DraSoGo/Cansat_Duck2Dragon/Data/Prediction.pdf

# รายงานการจำลองเชง

ิ

ต

ั

# วเลขของวถ

ิ ี

# การบ

ิ

# นและ การทำนายจ

ุ

# ดตกของจรวดน

ำ ส

่

# งดาวเทย

ี

# มขนาด

เล

็

# ก (CanSat)

## วรรณกรรมปรทิ ศั น์และเทคโนโลยกี ารจำลองวถิ ีการบนิ ในปัจจุบนั

การวจิยั และการพฒั นาในอตุ สาหกรรมการบนิ และอวกาศขนาดเล็ก โดยเฉพาะโครงการดาวเทยีมขนาดกระป๋อง เครอื่ งดื่มหรอื CanSat ได้รบั ความนิยมอยา่ งแพรห่ ลายในสถาบนั การศึกษาและหน่วยงานวจิยั ทวั่ โลก.

1
สถาปัตยกรรมทวั่ ไปของ CanSat มกั มขีนาดเส้นผา่ นศนู ยก์ ลาง 66 มลิลิเมตร สงู 115 มลิลิเมตร และมมี วลจำกัด อยใู่ นชว่ ง 300 ถึง 350 กรมั เพอื่ ให้สามารถบรรจุในทอ่ ปล่อยของจรวดนำ ส่ง (Rocket Launcher) หรอืปล่อย จากบอลลนู เพดานบนิ สงูได้.
1 หน่ึงในความทา้ทายทสี่ ำ | คัญทสี่ ดุ ของการดำ | เนินภารกิจคือการทำนายและคำ | นวณ
พกิ ัดจุดตกหลังจากการปล่อยตัว ณ จุดสงู สดุ หรอือะโพจี(Apogee).

5 ความคลาดเคลื่อนของพกิ ัดจุดตกมกั เกิด จากตัวแปรภายนอกทไี่ มค่ งที่เชน่ ลมพดั สอบ (Wind Shear) และกระแสลมพดั ปลิว (Wind Drift) ในชนั้ บรรยากาศระดับต่ำ .

5
จากงานวจิยั ของ Camogao และคณะ (2025) เรอื่ ง "Real-time Telemetry, Flight Path 3D Visualization, CanSat Attitude, and Landing Location Prediction" ได้มกี ารพฒั นาสถาปัตยกรรมฮารด์ แวรเ์พอื่ รองรบั การประมวลผลและการทำนายพกิ ัดแบบเวลาจรงิ (Real-time Telemetry).
| | 1 การใชไ้มโครคอนโทร
ลเลอรป์ ระสิทธภิ าพสงู รว่ มกับเซน็ เซอรว์ดั ความกดอากาศและระบบกำ | หนดตำ | แหน่งบนโลก ชว่ ยให้นักวจิยั สามารถ
ประเมนิ อัตราการรว่ งหล่นแนวดิ่งและคำ | นวณความเรว็ระนาบราบเพอื่ ทำนายจุดตกได้อยา่ งแมน่ ยำ.

1 รายละเอียด
โครงสรา้งฮารด์ แวรแ์ ละหน้าทขี่ องแต่ละส่วนประกอบตามทปี่ รากฏในงานวจิยั ดังกล่าวแสดงไวใ้นตารางด้านล่าง

1
:

### ตารางแสดงรายละเอียดฮารด์ แวรแ์ ละระบบโทรมาตรของ CanSat

ส่วนประกอบฮารด์ แวร์ | หน้าทเี่ ชงิระบบและการวดั ค่า | รูปแบบการส่งผา่ นขอ้ มลู และ อัลกอรทิ มึทเี่ กี่ยวขอ้ ง
Teensy 4.1 Microcontroller | ประมวลผลหลักของระบบการบนิ และบนั ทกึขอ้ มลู ลง SD Card สำ รอง | อัตราการส่มุ ตัวอยา่ งขอ้ มลู 1 เฮิรตซ์ป้องกันการสญู หายของ ขอ้ มลู 1
MS5611 Barometric Sensor | วดั ความกดอากาศ อณุ หภมู ิและ คำ นวณระดับความสงู ทางดิ่ง | ใชใ้นการคำ นวณอัตราเรว็ในการ รว่ งหล่น (Descent Rate) 1
BNO08x Inertial Measurement Unit | วดั ทศั นคติการทรงตัว (Pitch, Roll, Yaw) และความเรง่ | ใชฟ้ ิลเตอรค์ าลมานหรอื ฟิลเตอรแ์ มดก์วกิ ในการปรบั ปรงุ ความเทยี่ งตรง 1
SAM-M10Q GPS Receiver | ระบพุ กิ ัดภมู ศิ าสตร์(Latitude, | ป้อนขอ้ มลู เขา้ส่อู ัลกอรทิ มึ ระยะ

| Longitude) และความสงู เหนือ ระดับน ้ำ ทะเล | ื้ ทจี่ ุดตก 1 ทางฮาเวอรซ์ นี และพน
APC220 Wireless Transceiver | ส่งสัญญาณโทรมาตรคลื่นวทิ ยุ ความถี่ต่ำ มายงัสถานีภาคพน ื้ ดิน (GCS) | ตรวจสอบพฤติกรรมการ เคลื่อนทผี่ า่ นโปรแกรมตรวจสอบ 1 พกิ ัด 3 มติ ิ
ในส่วนของจรวดนำ | ส่ง งานวจิยั พฒั นาจรวดระดับแขง่ ขนั เชน่ ในโครงการ ESERO Greece's CanSat 2025 โดย
Panagiotou (2025) ได้นำ | เสนอการออกแบบระบบจรวดนำ | ส่งแบบนำ | กลับมาใชใ้หมไ่ ด้ซง่ึขน้ึ ไปถึงระดับความสงู
เป้าหมาย 1,000 เมตร และทำการปล่อย CanSat ออกมาอยา่ งปลอดภัย.
| | | 6
โครงการดังกล่าวประสบความสำ | เรจ็ใน
การบรูณาการซอฟต์แวรจ์ ำลองวถิ ีการบนิ แบบวงปิด โดยเรมิ่ ต้นจากการออกแบบโครงสรา้งบนซอฟต์แวรย์ อด นิยมอยา่ ง OpenRocket และส่งผา่ นพารามเิตอรอ์ ากาศพลศาสตรไ์ปวเิคราะห์ต่อยอดแบบ 6 องศาอิสระ
(6-DOF) ด้วยชุดเครอื่ งมอืคำ | นวณสถิติและการแจกแจงความน่าจะเป็นบนซอฟต์แวร์RocketPy.
| | | 6
แบบจำลองฟิสิกส์เชงิคำ | นวณและพลศาสตรก์ ารพดั ปลิวตามลม
การจำลองการเคลื่อนทขี่ องจรวดรว่ มกับ CanSat แบง่ ออกเป็นสองสถานะหลักทางฟิสิกส์ได้แก่ ชว่ งการบนิ ขน้ึ แบบแรงขบั ดันสงู และลอยตัวอิสระ (Ascent Phase) ซง่ึจรวดและดาวเทยีมเคลื่อนทรี่ ว่ มกันเป็นระบบเดียว และ ชว่ งการรว่ งหล่นภายใต้รม่ ชูชพี (Descent Phase) ซง่ึทงั้ สองโครงสรา้งแยกตัวออกจากกันและเคลื่อนทอี่ ยา่ ง อิสระตามความเรว็ปลายเฉพาะตัวและแรงลมภายนอก.
| 6
1. กรอบอ้างอิงพกิ ัดเชงิตำ | แหน่ง (Coordinate Reference Frames)

การจำลองพกิ ัดการเคลื่อนทจี่ ำเป็นต้องอ้างอิงสองระบบพกิ ัดหลัก ได้แก่

| | | 8 :
- ระบบพกิ ัดเฉื่อยแกนโลก (Inertial Frame - IF): วางแกนอ้างอิงคงทกี่ ับจุดศนู ยก์ ลางของโลก โดยแกน
ชตี้ ามแกนหมนุ ของโลก แกน | ชไี้ปยงัพกิ ัดเส้นเมรเิดียนกรนี ิช และแกน | ตัง้ ฉากตามระบบ
มอืขวาเพอื่ ระบพุ กิ ัดละติจูดและลองจจิูดเชงิมมุ .
| 8
- ระบบพกิ ัดเคลื่อนทตี่ ามลำ | ตัวจรวด (Moving Body Frame): มจีุดกำ | เนิดพกิ ัดอยทู่ จี่ ุดศนู ยก์ ลางมวล
ของจรวด แกนสมมาตรหลักพงุ่ ตรงจากทา้ยจรวดไปยงัหัวจรวด เพอื่ ใชว้เิคราะห์ทศิทางของแรงขบั ดัน แรง ยก และแรงต้านอากาศพลศาสตร.์
| 8

### 2. สมการการแปลการเคลื่อนทเี่ ชงิแปล (Translational Equations of Motion)

แรงภายนอกทกี่ ระทำต่อจรวดในแนวแกนใด ๆ สามารถวเิคราะห์ได้ด้วยกฎขอ้ ทสี่ องของนิวตัน ภายใต้สมมติฐาน การเปลี่ยนแปลงมวลอยา่ งรวดเรว็เนื่องจากการเผาไหมข้ องดินขบั

| | 8 :
เมอื่ แปลงเป็นส่วนประกอบในแนวดิ่ง (ความสงู | ) และแนวราบ ( | ) จะได้ความสัมพนั ธเ์ชงิอนุพนั ธด์ ังนี้

8
:

โดยที่ | คือแรงขบั จากมอเตอร์ณ เวลา , | คือมวลรวมของระบบทแี่ ปรผนั ตามเวลาเนื่องจากอัตรา

การสิ้นเปลืองเชอ

| ื้
เพลิง และ | คือค่าความเรง่ เนื่องจากแรงโน้มถ่วงทแี่ ปรผนั ตามความสงู
| | 8 :
แรงต้านอากาศพลศาสตร์( ) ขน้ึอยกู่ ับความหนาแน่นของอากาศ อัตราเรว็ และสัมประสิทธแิ์ รงต้าน ( | )
ของรปู ทรงโครงสรา้ง

15
:

สำ หรบั ชนั้ บรรยากาศจำลองมาตรฐานสากล (International Standard Atmosphere - ISA) ความหนาแน่นของ อากาศจะลดลงตามระดับความสงู เชงิเอ็กซโ์พเนนเชยีล

| 8 :
โดยที่ | คือความหนาแน่นอากาศทรี่ ะดับน
้ำ
ทะเล ( | ) และ | คือค่าความสงู อ้างอิงเกลของ
ชนั้ บรรยากาศประมาณ | เมตร.

8

### 3. แบบจำลองกระแสลมพดั สอบเชงิลอการทิ มึ (Logarithmic Wind Profile)

ในการคำ นวณแรงลมภายนอกทแี่ ปรผนั ตามระดับความสงู จำลอง นักวจิยัใชค้ วามสัมพนั ธท์ างชลศาสตรท์ อี่ ธบิ าย พฤติกรรมลมในชนั้ ขอบเขตบรรยากาศผวิพน

ื้

19
:
โดยที่ | คืออัตราเรว็ลม ณ ระดับความสงู | เหนือพน

ื้
ดิน, | คือความเรว็ลมเนื่องจากแรงเสียด
ทาน, | คือค่าคงทฟี่ อนคารม์ นั ( | ), และ | คือระดับความขรขุ ระทางภมู ศิ าสตรข์ องพน ื้ ทปี่ ล่อย.

19 ระดับ
ความขรขุ ระนี้แปรผนั ตามลักษณะทางกายภาพของสภาพแวดล้อมดังแสดงในตารางเปรยีบเทยีบค่าคงทที่ าง ภมู ศิ าสตรด์ ้านล่าง
| 19 :
ลักษณะทางภมู ศิ าสตรข์ องพนื้ ที่ ปล่อย | ค่าระดับความขรุขระพนื้ ผวิ (z0 - เมตร) | ตัวแปรประกอบการจำลองชนั้ ขอบเขตลม
ลานคอนกรตี เรยี บหรอื รนั เวย์สนามบนิ | | ลมมคี วามเรว็สงูใกล้ผวิพน ื้ แรง เฉือนต่ำ

ทงุ่ หญา้โล่งหรอืลานดินเรยี บ | สภาพภมู ปิ ระเทศปกติสำ หรบั การ 7 แขง่ ขนั CanSat
พนื้ ทเี่ กษตรกรรมมพี ชืคลมุ ดิน | เกิดความป่ันป่วนของลมในระดับ ต่ำ
พนื้ ทปี่ ่าหนาแน่นหรอืปรมิ ณฑล เมอืง | ความเรว็ลมลดลงอยา่ งรวดเรว็ ื้ 20 ใกล้ผวิพน

### 4. อัลกอรทิ มึการแปลงระยะทางและพกิ ัดภมู ศิ าสตร์(Geographical Conversion)

เมอื่ ทราบระยะการพดั ปลิวตามแนวราบในแกนตะวนั ออก-ตะวนั ตก ( ในหน่วยเมตร) และแนวเหนือ-ใต้( ใน
หน่วยเมตร) ทเี่ กิดขน้ึ ระหวา่ งการรว่ งหล่น ระบบจะคำ | นวณตำ | แหน่งพกิ ัดภมู ศิ าสตรส์ ดุ ทา้ยโดยแปลงระยะทางเป็น

พกิ ัดละติจูด ( ) และลองจจิูด ( ) โดยอาศัยความสัมพนั ธท์ างเรขาคณิตของทรงกลมโลก

| | 1 :
โดยตัวแปร | คือรศั มเีฉลี่ยทางดาราศาสตรข์ องโลกเทา่ กับ | เมตร.
| | 10

## สถาปัตยกรรมเชอื่ มต่อและการแปลงขอ้ มลู จาก OpenRocket สู่ Python

การเชอื่ มโยงขอ้ มลู จากไฟลโ์ครงสรา้งการออกแบบของ OpenRocket (นามสกลุ .ork) ไปยงัโปรแกรมจำลองวถิ ี การบนิ บนภาษา Python สามารถทำได้โดยสะดวกผา่ นเครอื่ งมอืแปลงสัญญาณชุดคำ สัง่ ของกล่มุ นักพฒั นา RocketPy-Team ซง่ึเปิดตัวเครอื่ งมอืวศิ วกรรมขอ้ มลู แบบโอเพนซอรส์ ชอื่ วา่ RocketSerializer.

22
ระบบซอฟต์แวรน์ ี้ทำงานโดยใชอ้ ินเทอรเ์ฟซภาษา Java ผา่ นการเรยี กใชง้านโมดลู คอมไพเลอร์JPype เพอื่ เขา้ถึง แกนประมวลผลภายในของโปรแกรม OpenRocket โดยตรง.

23 กระบวนการทำงานจะอ่านขอ้ มลู ไฟล์ต้นทางใน ลักษณะโครงสรา้งเอกสาร XML ของ .ork แล้วสกัดค่าคณุ สมบตั ิกายภาพทงั้ หมดออกมาให้อยใู่ นรปู ตัวแปร พจนานุกรม (Dictionary) ของโครงสรา้งภาษา JSON หรอืจดั สรา้งขน้ึ เป็นโครงงานสมดุ บนั ทกึการบนิ สำ หรบั การ ประมวลผลบนสภาพแวดล้อมจำลอง Jupyter Notebook หรอื Google Colab โดยอัตโนมตั ิ.

23

อยา่ งไรก็ดีการใชง้านเครอื่ งมอืแปลงรหัสอัตโนมตั ินี้มขีอ้ จำกัดเชงิโครงสรา้งทสี่ ำ คัญหลายประการ ซง่ึนักวจิยั จำเป็นต้องทราบดังนี้

23
:
- การจำกัดภาษาของฐานขอ้ มลู : ไฟลโ์ครงสรา้งการออกแบบต้นฉบบั จาก OpenRocket จะต้องจดั บนั ทกึ ไวใ้นสัญกรณ์รปู แบบภาษาอังกฤษเทา่ นั้น.

23
- ความต้องการขอ้ มลู จำลองพนื้ ฐาน: ตัวไฟล์.ork จะต้องเคยผา่ นการกดจำลองการประมวลผลการบนิ (Run Simulation) ในโปรแกรม OpenRocket มาแล้วอยา่ งน้อยหน่ึงครงั้ และมปี ระวตั ิผลการคำ นวณ บนั ทกึค้างไวภ้ ายในไฟล์เพอื่ ให้ตัวแยกแยะทางไวยากรณ์(Parser) สามารถดึงพารามเิตอรจ์ ำลองไปอ้างอิง ได้.

23
- โครงสรา้งทางเรขาคณิตทจี่ ำกัด: ตัวแปลงรหัสรองรบั รปู แบบจรวดชนิดขนั้ ตอนเดียว (Single-stage) เทา่ นั้น และจำกัดจำนวนการติดตัง้ โครงสรา้งปลายหัวจรวด (Nose Cone) เพยี งชนิ้ เดียว รวมถึงรองรบั ระบบขบั ดันมอเตอรเ์ดี่ยว (Single-motor Configuration) เทา่ นั้น.

23

### ตารางการจบั ค่พู ารามเิตอร์XML ของ OpenRocket กับวตั ถคุ ลาสใน RocketPy

ในการดึงขอ้ มลู โดยตรงจากโครงสรา้ง XML ของ OpenRocket ซอฟต์แวรจ์ ำลองภาษา Python จะทำการ จำแนกแทก็ (Tag) ต่าง ๆ และจดั โครงสรา้งใหมเ่ ขา้ส่วูตั ถคุ ลาสหลักตามรปู แบบตารางขอ้ มลู อ้างอิงต่อไปนี้

13
:
แทก็ โครงสรา้ง XML ในไฟล์ .ork | ความหมายเชงิฟิสิกส์ | วตั ถคุ ลาสเป้าหมายใน RocketPy
<nosecone> | โครงสรา้งปลายหัวจรวด รวมถึง วสั ดุความยาว และความหนา | 25 Rocket.add_nose_cone()
<bodytube> | ลำ ตัวหลักของจรวดทกี่ ำ หนด ื้ ื้ พน ทหี่ น้าตัดอ้างอิงเชงิพน ที่ | Rocket(radius=...) 13
<trapezoidalfinset> | ชุดปีกเสถียรภาพสี่เหลี่ยมคางหมู กำ หนดสแปน รทู คอรด์ และ ทปิ คอรด์ | Rocket.add_trapezoidal_fin s() 25
<parachute> | คณุ ลักษณะรม่ ชูชพี รปู รา่ ง และ แรงต้านขณะกางรว่ งหล่น | 13 Rocket.addParachute()
<launchlug> | ป่มุ นำ ทางรางปล่อยจรวดทรี่ ะบุ ระยะเชงิมมุ และตำ แหน่งตาม แกน | 25 Rocket.set_rail_buttons()
<motor> | คณุ สมบตั ิของเครอื่ งยนต์ดินขบั แขง็ ดินขบั ผสม หรอืของเหลว | SolidMotor() / HybridMotor() 13
ลำ | ดับขนั้ ตอนจำลองและการประมวลผลบนสภาพแวดล้อม

## Google Colab

สำ | หรบั กระบวนการพฒั นาและประมวลผลด้วยรหัสคอมพวิเตอรผ์ า่ นระบบ Google Colaboratory ผใู้ชส้ ามารถ
ใชบ้ ญั ชผี ใู้ชง้านทวั่ ไปเชอื่ มต่อโดยตรงกับไดรฟ์ขอ้ มลู จำลองและเขยีนคำ | สัง่ จำลองวถิ ีการบนิ ได้อยา่ งสะดวก
รวดเรว็ตามรปู แบบการทำงานสองทางเลือกดังต่อไปนี้

15
:

### ทางเลือกที่1: ระบบวเิคราะห์พลศาสตรแ์ ละทำนายจุดตก 3-DOF แบบกำ หนดเอง (Custom 3-DOF Simulator with Logarithmic Wind Model)

รหัสคอมพวิเตอรใ์นส่วนนี้ได้รบั การพฒั นาตามระบบฟิสิกส์คณิตศาสตรบ์ รสิทุ ธเิ์พอื่ แก้สมการการบนิ แปลการ เคลื่อนทขี่ องจรวดและชนิ้ ส่วน CanSat โดยอิสระ โดยอ้างอิงเงอื่ นไขจำลองยอดนิยมของการแขง่ ขนั ระดับนานา ชาติเชน่ การกางรม่ ชูชพี สองระดับ (Dual-parachute Sequence) ของทมี Soton CanSat 2022 ซง่ึกางรม่ ชว่ ยลดความเรว็ขนาดเล็กระดับสงูให้รว่ งหล่นด้วยอัตราเรว็ 15 เมตรต่อวนิ าทีและกางรม่ หลักขนาดใหญท่ รี่ ะดับ ความสงู 400 เมตร เพอื่ ลดอัตราความเรว็ให้เหลือ 5 เมตรต่อวนิ าทสีำ หรบั ความมนั่ ใจในการลงจอดอยา่ ง ปลอดภัย.

12
ชุดคำ สัง่ นี้ถกู ออกแบบมาให้รนั ได้ทนั ทโีดยไมม่ กี ารเรยี กใชร้ะบบไฟล์ภายนอกทอี่ าจทำให้เกิดความล้มเหลวขณะ ประมวลผลบนคลาวด์

15
:

Python
import numpy as np
import pandas as pd
import matplotlib.pyplot as plt
import io
# 1. การกำ หนดขอ้ มลู ดิบแรงขบั เคลื่อนและมวลของมอเตอร์(Thrust Profile Integration) # ---------------------------------------------------------

# ขอ้ มลู แรงขบั จำลองของเครอื่ งยนต์จำลอง (Estes C5-3 Motor Profile)

thrust_data = """Time (s),Thrust (N),Mass (kg)
0.0,0.0,0.024
0.1,5.2,0.023
0.2,9.8,0.022
0.3,14.5,0.020
0.4,12.1,0.018
0.6,6.2,0.016
0.8,5.1,0.014
1.0,4.8,0.012
1.2,4.6,0.010
1.4,4.5,0.008
1.6,4.4,0.006

1.8,4.1,0.004
1.85,0.0,0.003
"""

# โหลดขอ้ มลู เขา้ส่โูครงสรา้ง Pandas DataFrame เสมอืนทำงานบนระบบไฟล์จรงิ tcurve = pd.read_csv(io.StringIO(thrust_data))

timeval = tcurve.values
thrustval = tcurve.values
massval = tcurve['Mass (kg)'].values
thrust_time = round(timeval.max(), 3)
# 2. พารามเิตอรเ์ชงิกายภาพและตัวแปรสภาวะแวดล้อม (System & Environment Constants) # ---------------------------------------------------------

g = 9.81 | # ค่าแรงโน้มถ่วงเฉลี่ยของโลก (m/s^2)
rho_0 = 1.225 | # ความหนาแน่นของอากาศทรี่ ะดับน้ำทะเล (kg/m^3) [18]
dt = 0.001 | # ชว่ งก้าวการอินทเิกรตเวลาเชงิวนิ าที
# คณุ ลักษณะของจรวดนำ | ส่ง (Rocket Launcher)

m_rocket_dry = 0.110 # มวลแห้งของตัวจรวด (kg)
A_rocket = np.pi * (0.02302 ** 2) # พนื้ ทหี่ น้าตัดอ้างอิงตัวจรวด (m^2) C_d_rocket_ascent = 0.445 # สัมประสิทธติ์ ้านทานชว่ งบนิ ขน้ึ

# คณุ ลักษณะดาวเทยีม CanSat และภารกิจแยกตัว (CanSat Specifications) m_cansat = 0.350 # มวลมาตรฐานของ CanSat (kg) [3, 18] C_d_cansat_flight = 0.8 # สัมประสิทธติ์ ้านขณะอยใู่ นระบบทอ่

# พารามเิตอรพ์ กิ ัดปล่อยภมู ศิ าสตร์(Launch Pad Coordinates)

lat_launch = 13.7367 # พกิ ัดละติจูดจำลอง
lon_launch = 100.5231 # พกิ ัดลองจจิูดจำลอง
R_earth = 6378100.0 # รศั มที างเรขาคณิตของโลก (m)
# 3. อัลกอรทิ มึจำลองแบบจำลองลมพดั สอบ (Logarithmic Wind Model Function) # ---------------------------------------------------------

def estimate_wind_profile(alt):
"""
ประเมนิ ทศิทางและอัตราความเรว็ลม ณ ระดับความสงู ต่าง ๆ ด้วยโมเดลลอการทิ มึ """
if alt < 0.1:
alt = 0.1
u_friction = 0.35 # ความเรว็ลมเสียดทานเฉลี่ยผวิพนื้
z0 = 0.02 | # ระดับความขรขุ ระของพนื้ ทที่ งุ่ หญา้แขง่ ขนั
kappa = 0.4 | # ค่าคงทที่ างพลศาสตรอ์ ากาศ

speed = (u_friction / kappa) * np.log(alt / z0)

# กำ หนดมมุ กระแสลมเขา้ปะทะหลักทำมมุ 60 องศากับแกนทศิตะวนั ออก wind_angle = np.radians(60)

wind_x = speed * np.cos(wind_angle)
wind_y = speed * np.sin(wind_angle)
return wind_x, wind_y
# 4. แบบจำลองสภาพแกนการจำลองวถิ ีขาขน้ึ (Ascent Phase Trajectory) # ---------------------------------------------------------time_history = [0.0]

z_history = [0.0] # ระดับความสงู แนวตัง้
vz_history = [0.0] # ความเรว็แนวดิ่ง
x_drift = [0.0] | # ระยะทางราบแกน X (ตะวนั ออก-ตะวนั ตก)
y_drift = [0.0] | # ระยะทางราบแกน Y (เหนือ-ใต้)

t = 0.0
i = 0
m_motor_fuel = massval - massval[-1] # มวลเชอื้ เพลิงเบอื้ งต้น
m_total = m_rocket_dry + m_cansat + massval # มวลรวมขณะตัง้ บนแทน่ ปล่อย

# ค้นหาค่าแรงขบั ด้วยการประมาณค่าเชงิเวลาจากขอ้ มลู ดิบ

def get_motor_properties(current_time):
if current_time >= thrust_time:
return 0.0, 0.0
# ค้นหาตำ แหน่งดัชนีค่าทใี่ กล้เคียงทสี่ ดุ เชงิเวลา

idx = np.searchsorted(timeval, current_time) - 1
if idx < 0: idx = 0
T_step = thrustval[idx]
fuel_burn = (massval[idx] - massval[idx+1]) if idx < len(massval)-1 else 0.0 return T_step, fuel_burn

# ทำการเรมิ่ ประมวลผลชว่ งป้อนกำ ลังและชว่ งลอยตัวอิสระ จนกวา่ ความเรว็แนวดิ่งจะลดลงเป็นศนู ย์ while vz_history[i] >= 0.0:

T, fuel_loss = get_motor_properties(t)
m_total -= fuel_loss

# วเิคราะห์ค่าความหนาแน่นเชงิสถิติแปรผนั ตามระดับความสงู rho = rho_0 * np.exp(-z_history[i] / 8500.0)

# คำ นวณแรงต้านอากาศพลศาสตรแ์ นวดิ่ง

drag_ascent = 0.5 * rho * (vz_history[i]**2) * C_d_rocket_ascent * A_rocket

# คำ นวณผลความเรง่ และพกิ ัดการแปลแบบออยเลอร์[15, 31]

az = (T / m_total) - g - (drag_ascent / m_total)

# อัปเดตพกิ ัดความเรว็แนวราบจากอิทธพิ ลของลมพดั สอบภายนอก wx, wy = estimate_wind_profile(z_history[i])

# บนั ทกึพกิ ัดสเตตทางฟิสิกส์

vz_next = vz_history[i] + az * dt
z_next = z_history[i] + vz_history[i] * dt x_next = x_drift[i] + wx * dt
y_next = y_drift[i] + wy * dt

vz_history.append(vz_next) z_history.append(z_next)
x_drift.append(x_next)
y_drift.append(y_next)

t += dt
time_history.append(t)
i += 1

apogee_altitude = z_history[-1] apogee_x = x_drift[-1]
apogee_y = y_drift[-1]
print(f"--- จุดสงู สดุ อะโพจที ปี่ ระเมนิ ได้---")
print(f"ระดับความสงู อะโพจ:ี{apogee_altitude:.2f} เมตร")
print(f"ระยะพดั ปลิวตามลม ณ จุดสงู สดุ : X={apogee_x:.2f} ม., Y={apogee_y:.2f} ม.")
# 5. แบบจำลองพลศาสตรช์ ว่ งรว่ งหล่นแบบสองระดับแยกชนิ้ ส่วน (Post-Apogee Dual Descent Phase) # ---------------------------------------------------------

# ตัวแปรรว่ มสำ หรบั การจำลองรอ่ นลงของ จรวดเปล่า (Rocket Descent Core)

z_rock, x_rock, y_rock = [apogee_altitude], [apogee_x], [apogee_y]
# ตัวแปรรว่ มสำ หรบั การจำลองรอ่ นลงของ CanSat (CanSat Descent Core) z_sat, x_sat, y_sat = [apogee_altitude], [apogee_x], [apogee_y]

# กำ | หนดสเปกของรม่ ชูชพี ในการลงจอด

# จรวดนำ | ส่งใชร้ม่ ชูชพี เดี่ยวเพอื่ นำ | กลับมาใชใ้หม่

A_rock_chute = np.pi * (0.12 ** 2)
C_d_rock_chute = 1.35

# ดาวเทยีม CanSat ใชก้ ารประมวลผลกางรม่ แบบสองระดับ (Dual-parachute Stage Sequence)

# ระยะแรกเหนือกด 400 เมตร จะใชร้ม่ เล็ก (Drogue) อัตราการรว่ งหล่น ~15 m/s A_sat_drogue = np.pi * (0.04 ** 2)

C_d_sat_drogue = 1.1

# ระยะสองต่ำ กวา่ 400 เมตร จะกางรม่ ชูชพี หลัก (Main Chute) อัตราการรว่ งหล่น ~5 m/s A_sat_main = np.pi * (0.14 ** 2) [15]

C_d_sat_main = 1.75 [15]

# จำลองจรวดเปล่ารอ่ นลงกระทบพนื้ ดิน

t_idx = 0
while z_rock[-1] > 0.0:
curr_alt = z_rock[-1]
rho = rho_0 * np.exp(-curr_alt / 8500.0)

# อัตราความเรว็ปลายคงทขี่ ณะรว่ งหล่นของรม่ จรวด [18]

v_terminal_rock = np.sqrt((2 * m_rocket_dry * g) / (rho * C_d_rock_chute * A_rock_chute))

wx, wy = estimate_wind_profile(curr_alt)

z_rock.append(curr_alt - v_terminal_rock * dt) x_rock.append(x_rock[-1] + wx * dt) y_rock.append(y_rock[-1] + wy * dt)

# จำลอง CanSat รอ่ นลงกระทบพนื้ ดินแบบสองระดับเชงิเงอื่ นไข while z_sat[-1] > 0.0:

curr_alt = z_sat[-1]
rho = rho_0 * np.exp(-curr_alt / 8500.0)

# การคำ นวณแบง่ เฟสของรม่ ตามความสงู จรงิ (Trigger Logic)

if curr_alt >= 400.0:
# เฟสที่ 1: รม่ นำ รอ่ งประคองเสถียรภาพ (Drogue Phase)

v_terminal_sat = np.sqrt((2 * m_cansat * g) / (rho * C_d_sat_drogue * A_sat_drogue)) else:
# เฟสที่ 2: รม่ ชูชพี หลักกางทำงานเพอื่ ลงจอดอยา่ งปลอดภัย (Main Phase)

v_terminal_sat = np.sqrt((2 * m_cansat * g) / (rho * C_d_sat_main * A_sat_main))

wx, wy = estimate_wind_profile(curr_alt)

z_sat.append(curr_alt - v_terminal_sat * dt)
x_sat.append(x_sat[-1] + wx * dt) y_sat.append(y_sat[-1] + wy * dt)

# 6. รายงานตำ แหน่งและการแปลงพกิ ัดพยากรณ์เชงิแผนที่(Final GPS Location Reporting)

delta_lat_rock = (y_rock[-1] / R_earth) * (180 / np.pi)
delta_lon_rock = (x_rock[-1] / (R_earth * np.cos(np.radians(lat_launch)))) * (180 / np.pi)

delta_lat_sat = (y_sat[-1] / R_earth) * (180 / np.pi)
delta_lon_sat = (x_sat[-1] / (R_earth * np.cos(np.radians(lat_launch)))) * (180 / np.pi)

lat_final_rock = lat_launch + delta_lat_rock
lon_final_rock = lon_launch + delta_lon_rock

lat_final_sat = lat_launch + delta_lat_sat
lon_final_sat = lon_launch + delta_lon_sat
print(f"\n--- การคำ | นวณตำ | แหน่งลงจอดสดุ ทา้ยตามพกิ ัดภมู ศิ าสตร์---")
print(f"ตำ | แหน่งจรวดนำ | ส่งตกลงบนพนื้ : Lat {lat_final_rock:.6f}, Lon {lon_final_rock:.6f}")
print(f"ตำ | แหน่งดาวเทยีม CanSat ตกลงบนพนื้ : Lat {lat_final_sat:.6f}, Lon {lon_final_sat:.6f}")
# 7. วาดกราฟเปรยีบเทยีบผลเพอื่ ประเมนิ ความปลอดภัย (Visual Verification Output)

plt.figure(figsize=(10, 5))
plt.subplot(1, 2, 1)
plt.plot(x_drift, z_history, 'g-', label='Ascent Phase') plt.plot(x_rock, z_rock, 'r--', label='Rocket Descent') plt.plot(x_sat, z_sat, 'b--', label='CanSat Descent') plt.xlabel('Horizontal Drift Distance [m]') plt.ylabel('Altitude [m]')
plt.title('Flight Path 2D Side View')
plt.grid(True)
plt.legend()

plt.subplot(1, 2, 2)
plt.scatter(0, 0, color='orange', marker='*', s=150, label='Launch Pad')
plt.plot(x_rock, y_rock, 'r-', alpha=0.6, label='Rocket Track')
plt.plot(x_sat, y_sat, 'b-', alpha=0.6, label='CanSat Track')
plt.scatter(x_rock[-1], y_rock[-1], color='red', marker='x', s=100, label='Rocket Impact') plt.scatter(x_sat[-1], y_sat[-1], color='blue', marker='o', s=100, label='CanSat Impact') plt.xlabel('East-West Drift [m]')
plt.ylabel('North-South Drift [m]')
plt.title('Surface Landing Trajectory footprint')
plt.grid(True)

plt.legend()
plt.tight_layout()
plt.show()

### ทางเลือกที่2: ระบบจำลองวถิ ี6-DOF และการวเิคราะห์การกระจายตัวด้วย RocketPy (Professional RocketPy Integration Platform)

การสรา้งสครปิ ต์สำ | หรบั การทดสอบสถิติเชงิปรมิ าณของพกิ ัดจุดตกผา่ นชุดไลบรารวีทิ ยาศาตรร์ ะดับมาตรฐาน
สากล สามารถดำ | เนินแนวทางการเขยีนคำ | สัง่ ตามรปู แบบจำลองดังต่อไปนี้

16
:

Python
# ขนั้ แรกติดตัง้ ชุดไลบรารคี ำ นวณฟิสิกส์อากาศยาน [27]

!pip install rocketpy netCDF4 contextily -q

from rocketpy import Environment, SolidMotor, Rocket, Flight
import datetime

# 1. การประกาศพกิ ัดและโมเดลชนั้ บรรยากาศอ้างอิง (Environmental Formulation) [26, 28] env = Environment(

latitude=32.990254,
longitude=-106.974998,
elevation=1400 # ความสงู ของพนื้ ทเี่ หนือระดับน้ำทะเล (m)
)

# การเขา้ถึงฐานขอ้ มลู ทำนายลมตามเวลาพยากรณ์ผา่ นอินเทอรเ์น็ต GFS [26, 28]

tomorrow = datetime.date.today() + datetime.timedelta(days=1) env.set_date((tomorrow.year, tomorrow.month, tomorrow.day, 12)) # ปรบั ตัง้ ค่าเวลา UTC env.set_atmospheric_model(type="Forecast", file="GFS")

# 2. จดั สรา้งวตั ถมุ อเตอรร์ ะบอุ ัตราเรง่ ขบั ดัน (Motor Modeling) [13, 27]

# พารามเิตอรน์ ี้สกัดได้จากการอิมพอรต์ โมเดลเครอื่ งยนต์ของ OpenRocket ผา่ น RocketSerializer cesaroni_m1670 = SolidMotor(

thrust_source="https://raw.githubusercontent.com/RocketPy-Team/RocketPy/master/data/motors/cesaroni/Cesaroni_M1670.eng", # แหล่งขอ้ มลู โปรไฟล์เครอื่ งยนต์ตัวอยา่ ง [32]
dry_mass=1.815,
propellant_initial_mass=2.5,
nozzle_radius=0.033, nozzle_throat_radius=0.011, grain_number=5,
grain_density=1815,
grain_outer_radius=0.033,
grain_inner_radius=0.015,
grain_height=0.12,
grain_spacing=0.005,
combustion_chamber_to_nozzle=0
)

# 3. ประกอบโครงสรา้งตัวจรวดเสถียรภาพสงู (Dynamic Vehicle Assembler) [27, 28] custom_rocket = Rocket(

radius=127 / 2000, | # รศั มกี ายภาพของลำ | ตัวจรวด (m)
mass=14.426, | # น้ำหนักมวลแห้งของจรวดนำ | ส่งไมร่ วมอปุ กรณ์ดินขบั และ CanSat
inertia=(6.321, 6.321, 0.034), # ความเฉื่อยทางฟิสิกส์(Roll-Pitch Inertia Tensors)
power_off_drag=0.42, | # สัมประสิทธติ์ ้านทานอากาศเมอื่ เครอื่ งยนต์ดับ
power_on_drag=0.45, | # สัมประสิทธติ์ ้านทานอากาศเมอื่ เครอื่ งยนต์ติดเครอื่ ง
center_of_mass_without_motor=0
)
# กำ | หนดสลักรางนำ | ทางสำ | หรบั ตรวจสอบความเรว็หลดุ ราง [26, 28]

custom_rocket.set_rail_buttons( upper_button_position=0.0818, lower_button_position=-0.618, angular_position=45
)

# ติดตัง้ มอเตอรข์ บั ดันเขา้กับตำ แหน่งทา้ยระบบ [28] custom_rocket.add_motor(cesaroni_m1670, position=-1.255)

# การเชอื่ มต่อชนิ้ ส่วนความปลอดภัยเสถียรภาพทางอากาศพลศาสตร์[27, 28] custom_rocket.add_nose_cone(

group_name="Ogive Nose Cone",
length=0.274,
kind="ogive",
position=1.134
)

custom_rocket.add_trapezoidal_fins( n=4,
root_chord=0.120,
tip_chord=0.060,
span=0.110,

position=-1.04956
)

# 4. ประกาศกลไกกางรม่ ชูชพี นำ รอ่ งและหลัก (Parachute Ejection Mechanics) [29] def drogue_ejection_trigger(p, y):

# สัง่ การเปิดรม่ ชูชพี นำ รอ่ งทนั ทที อี่ ัตราความเรว็แนวดิ่งเป็นลบ (Apogee Detected) return True if y < 0 else False

def main_ejection_trigger(p, y):
# สัง่ การเปิดรม่ ชูชพี หลักเมอื่ ระดับความสงู อยตู่ ่ำ กวา่ 400 เมตร เหนือระดับพนื้ ดิน return True if y < 0 and y < 400 + 1400 else False

custom_rocket.addParachute(
"Drogue Chute",
CdS=1.15,
trigger=drogue_ejection_trigger, samplingRate=105,
lag=1.5,
noise=(0, 8.3, 0.5)
)

custom_rocket.addParachute( "Main Chute",
CdS=11.2,
trigger=main_ejection_trigger, samplingRate=105,
lag=1.5,
noise=(0, 8.3, 0.5)
)

# 5. ประมวลผลแบบจำลองเส้นทางบนิ เชงิ 6-DOF (Flight Trajectory Solver Execution) [27] flight_simulator = Flight(

rocket=custom_rocket,
environment=env,
rail_length=5.2,
inclination=85,
heading=0
)

# พมิพผ์ ลรายงานตัวแปรวกิ ฤตทางกายภาพของเทยี่ วบนิ [26, 27]

flight_simulator.info()

## การวเิคราะห์ความเบยี่ งเบนเชงิสถิติมอนเตคารโ์ลและววิฒั นาการ

## ระบบควบคมุ ทศิ ทาง

การทำนายวถิ ีจุดตกของ CanSat มวีวิฒั นาการทกี่ ้าวหน้าไปมากกวา่ เพยี งแค่การทำนายตำ แหน่งบนจุดอ้างอิง เชงิเดี่ยว (Deterministic Prediction) เนื่องจากกระแสลมภายนอก สภาวะอณุ หภมู ิและมวลรวมของระบบจรงิ มคี วามคลาดเคลื่อนเชงิฟิสิกส์อยเู่ สมอ.

8 การประยกุ ต์ใช้ระเบยีบวธิมีอนเตคารโ์ล (Monte Carlo Simulation) จงึเป็นมาตรฐานสากลทใี่ ชใ้นการคำ นวณการกระจายตัวของพกิ ัดจุดตก.

8
กระบวนการนี้ทำงานโดยสรา้งแบบจำลองการจำลองการบนิ ซ้ำจำนวน 1,000 ถึง 10,000 รอบ โดยกำ | หนดการส่มุ
กระจายตัวแปรนำ | เขา้ทสี่ ำ | คัญแบบส่มุ ทมี่ กี ารแจกแจงแบบปกติ(Gaussian Distribution) เชน่ กำ | หนดความ
ผนั ผวนของมวลแห้งทผี่ ดิพลาดได้ | , อัตราส่วนความเรว็ลมพดั สอบเพมิ่ ลดได้ | , และระดับความ
ล่าชา้ในการเปิดกางของรม่ ชูชพี (Trigger Lag) ในชว่ ง | วนิ าท.ี

29 ผลลัพธส์ ดุ ทา้ยจะปรากฏเป็นกล่มุ จุดตก บนแผนทภี่ มู ศิ าสตร์ซง่ึชว่ ยให้นักวจิยั สามารถวาดรปู วงรคี วามเชอื่ มนั่ (Landing Ellipse) ภายใต้ขอบเขตรศั มี

ความเชอื่ มนั่ สถิติระดับ | (ความน่าจะเป็นครอบคลมุ รอ้ ยละ 99.7) สำ | หรบั ควบคมุ รศั มคี วามปลอดภัยและการ
จำกัดขอบเขตพน

ื้
ทคี่ ้นหาและก้ภู ัยทางภมู ศิ าสตรไ์ด้อยา่ งดีเยยี่ ม.
| | 8
นอกเหนือจากการจำลองสถิติแล้ว ในการออกแบบ CanSat ขนั้ สงู นักวจิยั ยงัประยกุ ต์ใชเ้ทคโนโลยกี ารรอ่ นจอด ลงอยา่ งแมน่ ยำ (Autonomous Guided Landing) เพอื่ ควบคมุ ทศิทางอยา่ งกระตือรอื รน้ (Active Controls).

11
โดยสถาปัตยกรรม CanSat แบบพาราฟอยล์นำ ทาง (Steerable Parachute System) จะได้รบั การติดตัง้ ชุดขบั เคลื่อนมอเตอรเ์ซอรโ์ว (Servo Motors) ทำหน้าทดี่ ึงสายบงัคับรม่ ชูชพี ซา้ยและขวาเพอื่ ปรบั
เปลี่ยนรปู ทรงของรม่ ส่งผลให้เกิดแรงบงัคับเชงิเลี้ยวและการเล็งเป้าเขา้ส่พู กิ ัดนำ | รอ่ งทกี่ ำ | หนดล่วงหน้า.
| | | 4
การทำงานรว่ มกันระหวา่ งเซน็ เซอรก์ รองสัญญาณเชงิทศั นคติของแมดก์วกิ (Madgwick Filter IMU Integration) และการส่งค่าพกิ ัดตรวจวดั เปรยีบเทยีบระยะทางภมู ศิ าสตรผ์ า่ นอัลกอรทิ มึ ระยะทางฮาเวอรซ์ นี จะ ชว่ ยปรบั ค่าสัญญาณความกวา้งพลั ส์(PWM) ของมอเตอรเ์ซอรโ์ว เพอื่ ดึงสายควบคมุ รม่ ชูชพี พา CanSat เคลื่อนทเี่ ลี้ยวซา้ย ขวา หรอืกดหน้าตัวรม่ เพอื่ ลดแรงต้านอากาศ เพมิ่ ประสิทธภิ าพการเจาะกระแสลมพดั เฉือน และ ลงจอดในขอบเขตรศั มคี วามแมน่ ยำต่ำ กวา่ 10 เมตรจากจุดศนู ยก์ ลางเป้าหมายได้อยา่ งปลอดภัยสงู สดุ .
| | | 4

## สรุปและแนวทางการใชง้านเชงิปฏิบตั ิ

การผสานสถาปัตยกรรมโปรแกรมจำลองวถิ ีการบนิ OpenRocket เขา้ส่รู ะบบการประมวลผลคำ นวณทาง คณิตศาสตรบ์ นสภาพแวดล้อม Python ถือเป็นขนั้ ตอนทจี่ ำเป็นในการวจิยั ทางวศิ วกรรมการบนิ ระดับมาตรฐาน สากล.

8 การนำ | กระบวนการและทฤษฎีต่าง ๆ ไปประยกุ ต์ใชง้านจรงิอยา่ งมปี ระสิทธภิ าพ มขีอ้ พจิารณาเชงิเทคนิคที่
สำ | คัญดังนี้:
- การรวบรวมขอ้ มลู กายภาพทสี่ มบรูณ์: ก่อนทำการอิมพอรต์ วเิคราะห์ไฟล์.ork ผา่ นชุดคำ | สัง่
RocketSerializer หรอื orhelper นักวจิยั ต้องตรวจสอบให้แน่ใจวา่ ได้ทำการระบคุ ่าความเฉื่อยเชงิฟิสิกส์
(Inertia Tensors) และค่าพกิ ัดตำ | แหน่งอ้างอิงศนู ยถ์ ่วง (Center of Gravity) ทถี่ กู ต้องตามมาตรฐาน
กายภาพของอปุ กรณ์จรงิลงในโมเดลโครงสรา้งแล้ว เพอื่ ป้องกันความคลาดเคลื่อนสะสมขณะคำ | นวณความ
เสถียรทางการบนิ เชงิมมุ (Dynamic Stability Analysis).
| | 14
- ความสำ | คัญเชงิสถิติของกระแสลมระดับเพดานสูง: กระแสลมพดั สอบ (Wind Shear) มคี วามแปรปรวน
เชงิทศิทางและกำ | ลังตามระดับความสงู ของชนั้ ขอบเขตบรรยากาศ การจำลองการบนิ ทถี่ ือเอาแรงลม
ภายนอกเป็นค่าคงทสี่ ม่ำเสมอตลอดเวลาจะนำ | ไปส่คู วามคลาดเคลื่อนสะสมในการพยากรณ์พกิ ัดจุดลงจอด
อยา่ งรนุ แรง การนำ | แบบจำลองลอการทิ มึผวิพน
| | ื้
หรอืการเชอื่ มดึงขอ้ มลู พยากรณ์ลมแบบเวลาจรงิ GFS มา ประมวลผล จงึเป็นสิ่งจำเป็นอยา่ งยงิ่ ในการเพมิ่ ความเชอื่ ถือได้ของการทำนายพกิ ัดก้ชู พี .
| | 6
- ระบบความปลอดภัยทางวศิ วกรรม: นักวจิยั ควรตัง้ ค่าระบบกางรม่ แบบสองระดับเชงิเงอื่ นไข

(Dual-parachute Sequences) เป็นค่าเรมิ่ ต้นในการจำลองเสมอ เนื่องจากแรงเฉื่อยของ CanSat และ ความเรว็ปลายในการปะทะพน

ื้

ดิน เป็นปัจจยั วกิ ฤตทชี่ วี้ ดั การอยรู่ อดของอปุ กรณ์ฮารด์ แวรเ์ซน็ เซอรท์ ลี่ ะเอียดอ่อนจากการกระแทกในตอนทา้ยสดุ .

12

ผลงานทอี่ ้างอิง

1. Real-time Telemetry, Flight Path 3D Visualization, CanSat Attitude, and Landing Location Prediction - ResearchGate, เขา้ถึงเมื่อ มิถนุ ายน 9, 2026 https://www.researchgate.net/publication/399101221_Real-time_Telemetry_Flight_Path_3D_Visualization_CanSat_Attitude_and_Landing_Location_Prediction (https://www.researchgate.net/publication/399101221_Real-time_Telemetry_Flight_Path_3D_Visualization_CanSat_Attitude_and_Landing_Location_Prediction)
2. Research Article Experimental Approach for the Evaluation of the Performance of a Satellite Module in the CanSat Form Factor for - Semantic Scholar, เขา้ถึงเมื่อ มิถนุ ายน 9, 2026
https://pdfs.semanticscholar.org/1ab8/f579d7ff102affa9e8cb9fb38e7290274acf.p df (https://pdfs.semanticscholar.org/1ab8/f579d7ff102affa9e8cb9fb38e7290274acf.pdf)
3. CanSat - Grokipedia, เขา้ถึงเม

ื่
อ มิถนุ ายน 9, 2026
https://grokipedia.com/page/CanSat
4. CanSat 2021 - Herotech, เขา้ถึงเม

ื่
อ มิถนุ ายน 9, 2026 https://herotech.ro/cansat.html
5. APOGEE PREDICTION 1 A Machine Learning-Based Apogee Prediction Methodology for Experimental Student Rockets Price Hamilton Drawd - Liberty University, เขา้ถึงเม

ื่
อ มิถนุ ายน 9, 2026
https://digitalcommons.liberty.edu/cgi/viewcontent.cgi?article=2672&context=hon ors (https://digitalcommons.liberty.edu/cgi/viewcontent.cgi?article=2672&context=honors)
6. Design, Fabrication and Launching of CanSat-Deploying High-Power Rockets -MDPI, เขา้ถึงเม

ื่
อ มิถนุ ายน 9, 2026 https://www.mdpi.com/2673-4591/133/1/84
7. DESIGN CHALLENGES, AND OUTCOMES OF BUILDING A SATELLITE THE SIZE OF A SODA CAN - UPCommons, เขา้ถึงเมื่อ มิถนุ ายน 9, 2026 https://upcommons.upc.edu/bitstreams/5fa35656-49c1-4b0a-bf12-9e503b64aa3a/download (https://upcommons.upc.edu/bitstreams/5fa35656-49c1-4b0a-bf12-9e503b64aa3a/download)
8. Development of a Model Rocket Trajectory Simulation Tool with Python -ResearchGate, เขา้ถึงเม

ื่
อ มิถนุ ายน 9, 2026
https://www.researchgate.net/publication/368490407_Development_of_a_Model_Rocket_Trajectory_Simulation_Tool_with_Python (https://www.researchgate.net/publication/368490407_Development_of_a_Model_Rocket_Trajectory_Simulation_Tool_with_Python)
9. (PDF) nthroot Calculator - ResearchGate, เขา้ถึงเมื่อ มิถนุ ายน 9, 2026 https://www.researchgate.net/publication/391533330_nthroot_Calculator
10. GUI built in PyQt (Python) for a Can-Sized Sattelite (CanSat) - GitHub, เขา้ถึงเมื่อ มิถนุ ายน 9, 2026 https://github.com/AnshTanwar/GUI-Cansat-22
11. Constructing a Can Sized Sat With Steering - CanSat 2025 : 7 Steps -Instructables, เขา้ถึงเม

ื่
อ มิถนุ ายน 9, 2026
https://www.instructables.com/Constructing-a-Can-Sized-Sat-With-Steering-CanSat-/ (https://www.instructables.com/Constructing-a-Can-Sized-Sat-With-Steering-CanSat-/)
12. CanSat 2022 Preliminary Design Review (PDR) Outline Version 1.1, เขา้ถึงเมื่อ
มิถนุ ายน 9, 2026
https://cansatcompetition.com/docs/teams/cansat2022_1032_pdr_v1.pdf
13. Getting Started - RocketPy in Colab, เขา้ถึงเมื่อ มิถนุ ายน 9, 2026 https://docs.rocketpy.org/en/rel-v1.0.0a1/notebooks/getting_started.html
14. Source code for rocketpy.rocket.rocket, เขา้ถึงเมื่อ มิถนุ ายน 9, 2026 https://docs.rocketpy.org/en/latest/_modules/rocketpy/rocket/rocket.html
15. Python Model Rocket Trajectory Simulator Tutorial - SpaceLab Illinois, เขา้ถึงเมื่อ มิถนุ ายน 9, 2026
https://learnrockets.spacelab.web.illinois.edu/uploads/Python_Code_Rocket_Trajectory_Simulator_Final.pdf (https://learnrockets.spacelab.web.illinois.edu/uploads/Python_Code_Rocket_Trajectory_Simulator_Final.pdf)
16. GitHub - RocketPy-Team/RocketPy: Next generation High-Power Rocketry 6-DOF Trajectory Simulation, เขา้ถึงเม

ื่
อ มิถนุ ายน 9, 2026
https://github.com/RocketPy-Team/RocketPy
17. Rocket Simulation by using Machine learning - Kaggle, เขา้ถึงเมื่อ มิถนุ ายน 9, 2026 https://www.kaggle.com/code/rajeevsinghsisodiya/rocket-simulation-by-using-m achine-learning (https://www.kaggle.com/code/rajeevsinghsisodiya/rocket-simulation-by-using-machine-learning)
18. CanSat Report - ESERO Luxembourg, เขา้ถึงเมื่อ มิถนุ ายน 9, 2026 https://www.esero.lu/wp-content/uploads/2026/02/Final-CanSat-Report-SevenTo Heaven-.pdf (https://www.esero.lu/wp-content/uploads/2026/02/Final-CanSat-Report-SevenToHeaven-.pdf)
19. Fitting a two-layer model to wind profile data in python - Stack Overflow, เขา้ถึง เม

ื่
อ มิถนุ ายน 9, 2026
https://stackoverflow.com/questions/35795341/fitting-a-two-layer-model-to-win d-profile-data-in-python (https://stackoverflow.com/questions/35795341/fitting-a-two-layer-model-to-wind-profile-data-in-python)
20. Logarithmic wind profile doesn't give expected results - Forums, Autodesk, เขา้ถึง เม

ื่
อ มิถนุ ายน 9, 2026
https://forums.autodesk.com/t5/cfd-forum/logarithmic-wind-profile-doesn-t-give-expected-results/td-p/7891538 (https://forums.autodesk.com/t5/cfd-forum/logarithmic-wind-profile-doesn-t-give-expected-results/td-p/7891538)
21. Simulation and Analysis of Atmospheric Boundary Layer Characteristics in a Wind Tunnel Using Python - Engineered Science Publisher, เขา้ถึงเมื่อ มิถนุ ายน 9, 2026 https://www.espublisher.com/journals/articledetails/2148/
22. GitHub - openrocket/openrocket: Model-rocketry aerodynamics and trajectory simulation software, เขา้ถึงเม

ื่
อ มิถนุ ายน 9, 2026
https://github.com/openrocket/openrocket
23. RocketPy-Team/RocketSerializer: Easily convert your OpenRocket files into RocketPy simulations. - GitHub, เขา้ถึงเมื่อ มิถนุ ายน 9, 2026 https://github.com/RocketPy-Team/RocketSerializer
24. Scripting with Python and JPype - OpenRocket wiki, เขา้ถึงเมื่อ มิถนุ ายน 9, 2026 http://wiki.openrocket.info/Scripting_with_Python_and_JPype
25. File Specification — OpenRocket 23.09 documentation, เขา้ถึงเมื่อ มิถนุ ายน 9, 2026 https://openrocket.readthedocs.io/en/latest/dev_guide/file_specification.html
26. First Simulation with RocketPy, เขา้ถึงเมื่อ มิถนุ ายน 9, 2026 https://docs.rocketpy.org/en/latest/user/first_simulation.html
27. Getting Started - RocketPy in Colab, เขา้ถึงเมื่อ มิถนุ ายน 9, 2026 https://docs.rocketpy.org/en/latest/notebooks/getting_started_colab.html
28. Getting Started — RocketPy 1.12.1 documentation, เขา้ถึงเมื่อ มิถนุ ายน 9, 2026 https://docs.rocketpy.org/en/latest/notebooks/getting_started.html
29. Getting Started — RocketPy 0.13.1 documentation, เขา้ถึงเมื่อ มิถนุ ายน 9, 2026 https://docs.rocketpy.org/en/v0.13.1/notebooks/getting_started.html

30. Team Sammard's Official GCS Software for CanSat 2022 - GitHub, เขา้ถึงเมื่อ มิถนุ ายน 9, 2026 https://github.com/Jatin7385/CanSat_2022_GCS
31. 6-DOF Atmospheric Rocket Landing Guidance using Meta-Reinforcement Learning - electronic library -, เขา้ถึงเมื่อ มิถนุ ายน 9, 2026 https://elib.dlr.de/210766/1/Jacopo_Carradori_Thesis_reduced.pdf
32. Monte Carlo simulations — RocketPy 1.0.0a1 documentation, เขา้ถึงเมื่อ มิถนุ ายน 9, 2026
https://docs.rocketpy.org/en/rel-v1.0.0a1/notebooks/dispersion_analysis/dispersion_analysis.html (https://docs.rocketpy.org/en/rel-v1.0.0a1/notebooks/dispersion_analysis/dispersion_analysis.html)
33. Monte Carlo Simulations — RocketPy 1.12.1 documentation, เขา้ถึงเมื่อ มิถนุ ายน 9, 2026
https://docs.rocketpy.org/en/latest/notebooks/monte_carlo_analysis/monte_carlo_analysis.html (https://docs.rocketpy.org/en/latest/notebooks/monte_carlo_analysis/monte_carlo_analysis.html)
34. Design and Navigation Control of an Advanced Level CANSAT, เขา้ถึงเมื่อ มิถนุ ายน 9, 2026 https://cltp.info/pdf/paper4.pdf
