DraSoGo/Cansat_Duck2Dragon/Present/Post-Duck2Dragon.pdf

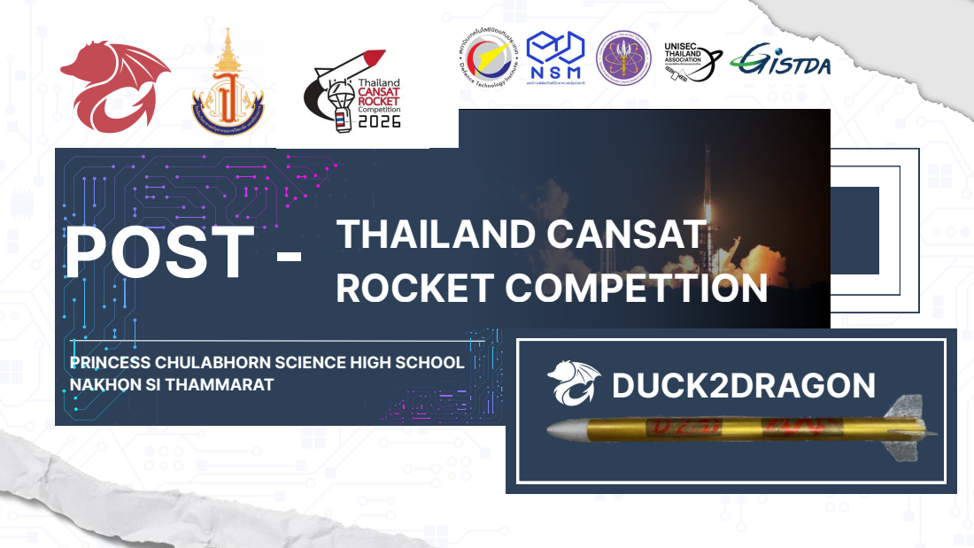
[picture p6: page 1]
THAILAND CANSAT; DUCK2DRAGON

ROCKET COMPETTION POST -

PRINCESS CHULABHORN SCIENCE HIGH SCHOOL
NAKHON SI THAMMARAT

# Meet Our Team

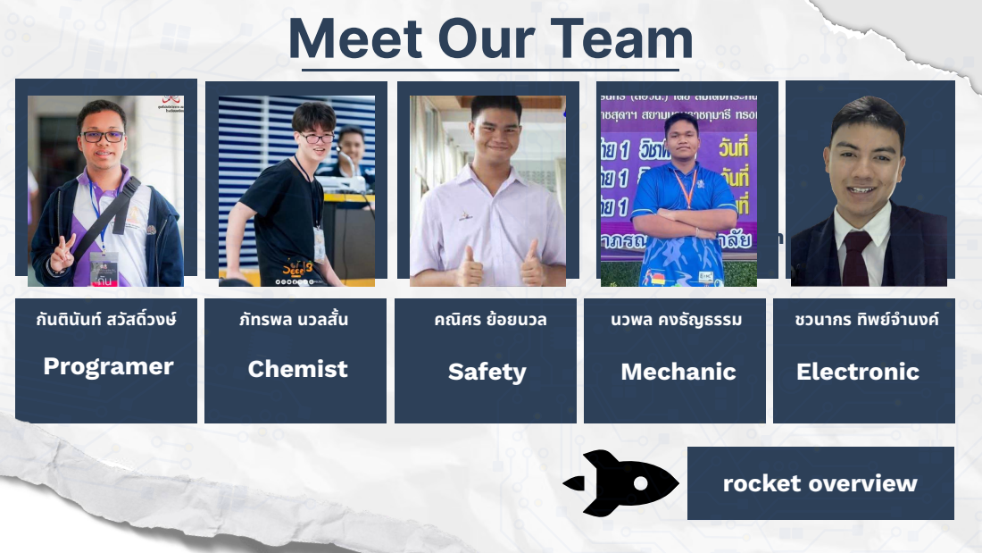
[picture p7: page 2]
สวสั ดิn; วงษ; ภัทรพล นวลสนัf; ยนวล; นวพล คงธัญธั; ธรรม; ชวนากร ทิพยจ; นงค; Programer; Chemist; Safety; Mechanic; Electronic; rocket overview

About Our Team

# Overview

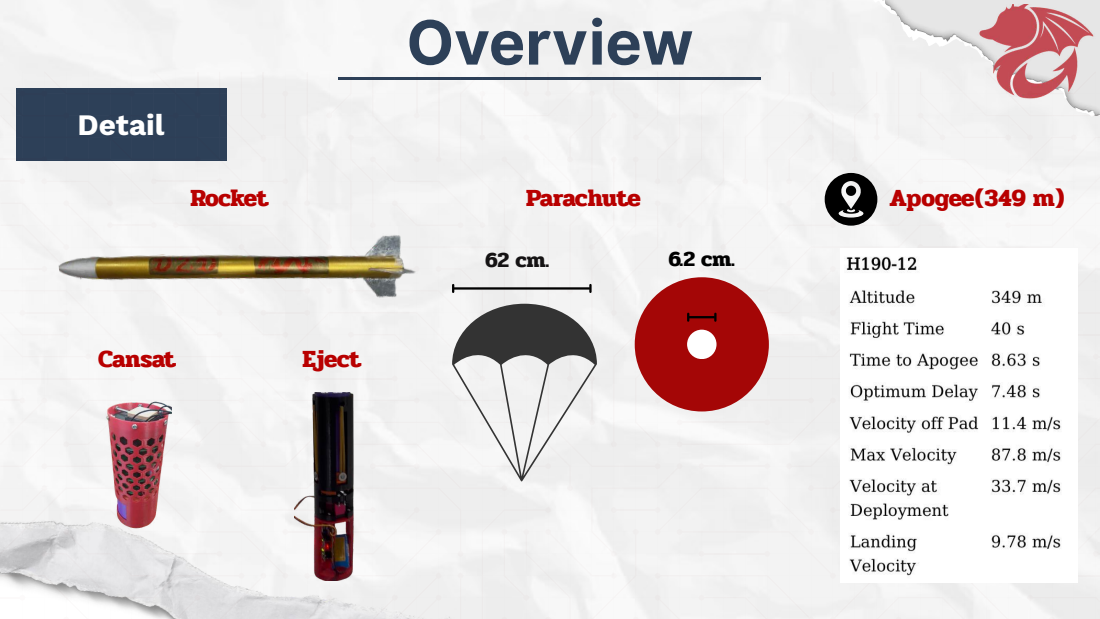
[picture p8: page 3]
Detail; Rocket; Apogee(349 m); Eject; Parachute; Cansat

# Overview

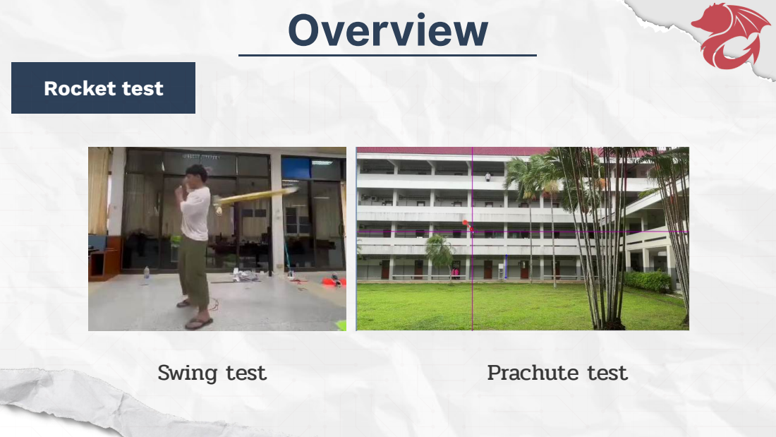
[picture p9: page 4]
Rocket test; Swing test; Prachute test

# Overview

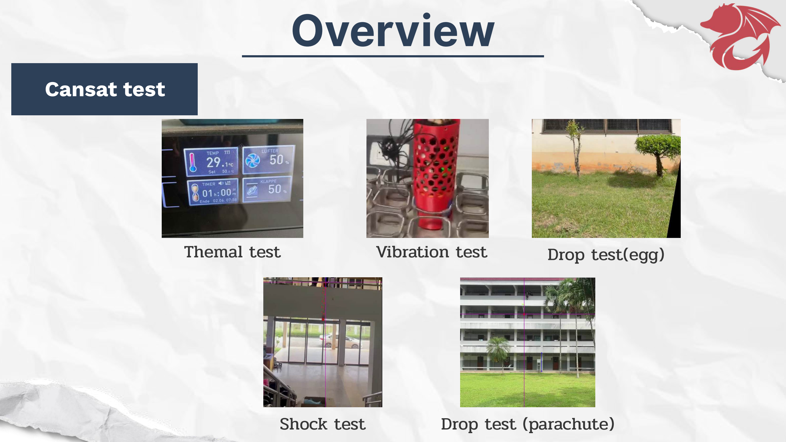
[picture p10: page 5]

Cansat test

Themal test | Vibration test | Drop test(egg)
Shock test | Drop test (parachute)

# Before Flight

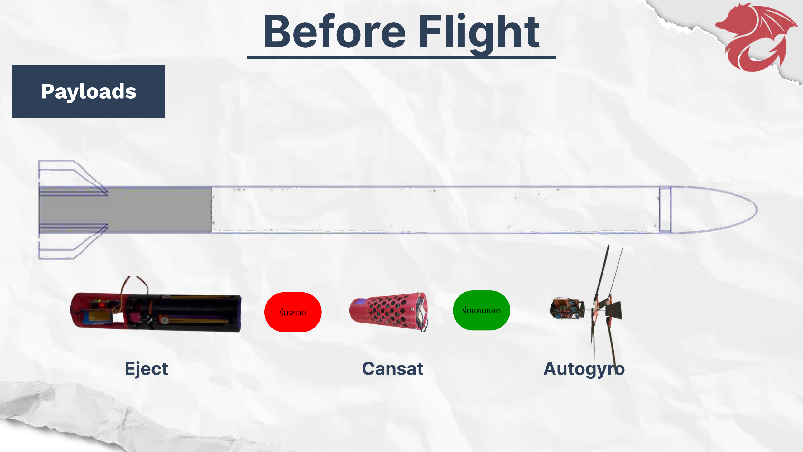
[picture p11: page 6]

Payloads

ร่มร่ | จรวด | ร่มร่ | แคนแสด
Eject | Cansat | Autogyro

# Before Flight

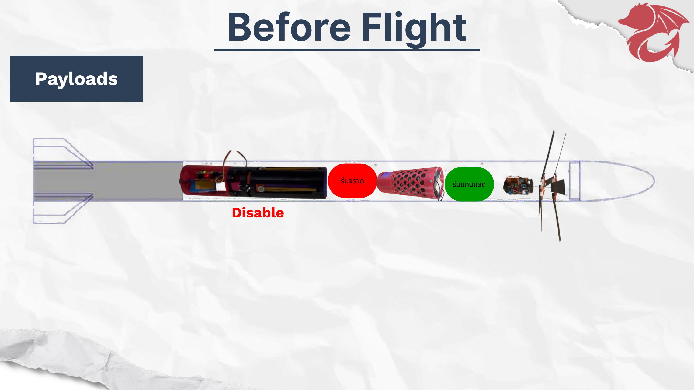
[picture p12: page 7]

Payloads

ร่มร่ | จรวด
ร่มร่ | แคนแสด
Disable

B

e

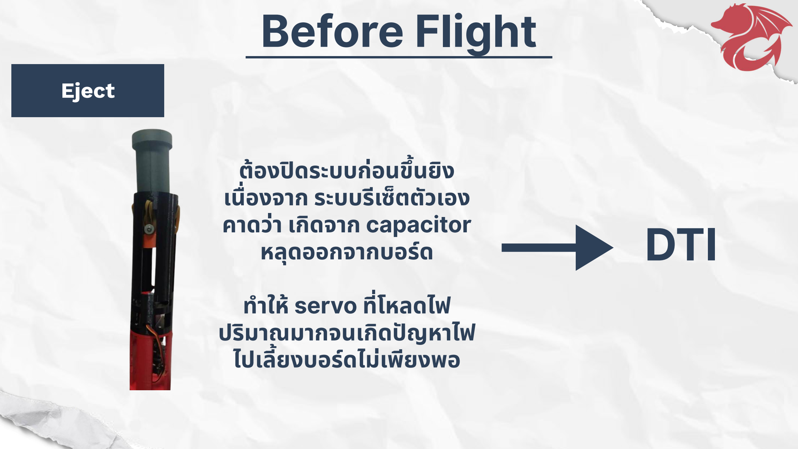
[picture p13: page 8]

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
เนื่

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
# Before Flight

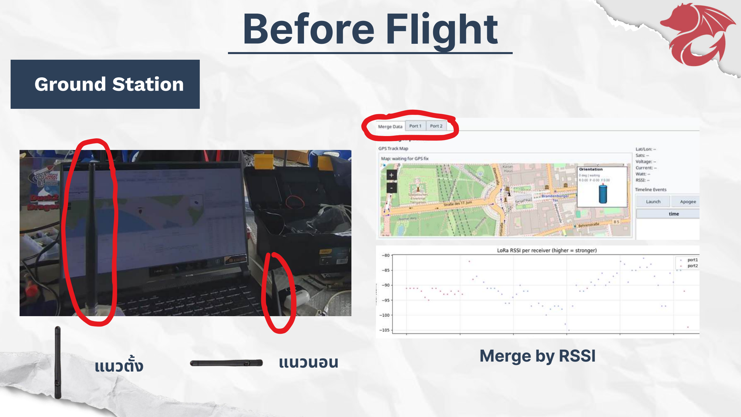
[picture p14: page 9]

Ground Station

Merge by RSSI
แนวตั้ง | แนวนอน

# During Flight

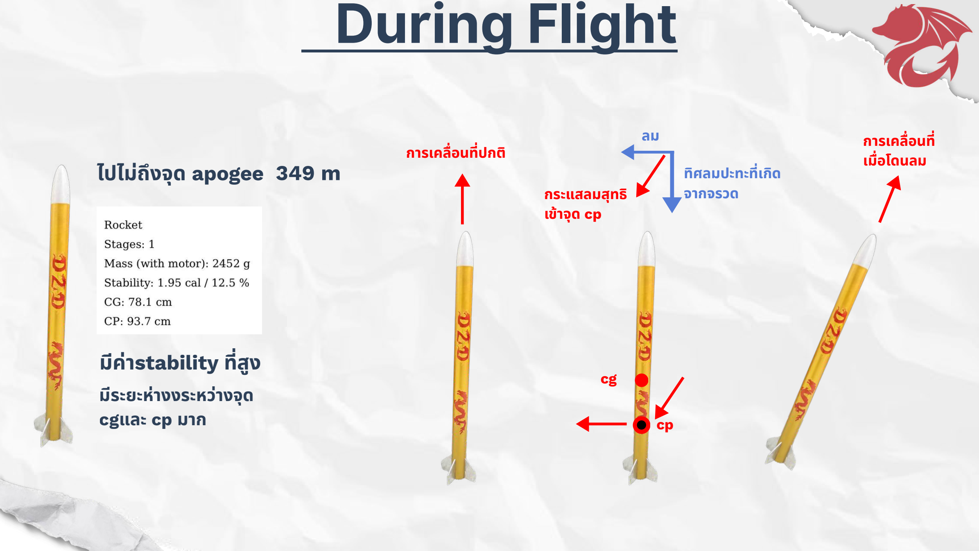
[picture p15: page 10]

ไปไม่ถ

ม่ ึ

งจ

ุ

ด apogee 349 m

การเคลื่อนท

ีcปกติ

cp

cg

ลม

ทิศลมปะทะที่เกิด
กระแสลมสุทสุ | ธิ | จากจรวด
เข้า
ข้

จุด cp

การเคลื่อนที่
เมื่อมื่ โดนลม

มีค่

มี ค่

าstability ที่สูง

สู
มร

ี
ะยะห

่

างงระหวา

่

งจ

ุ

ด
cgและ cp มาก

เริ่ | ม

# During Flight

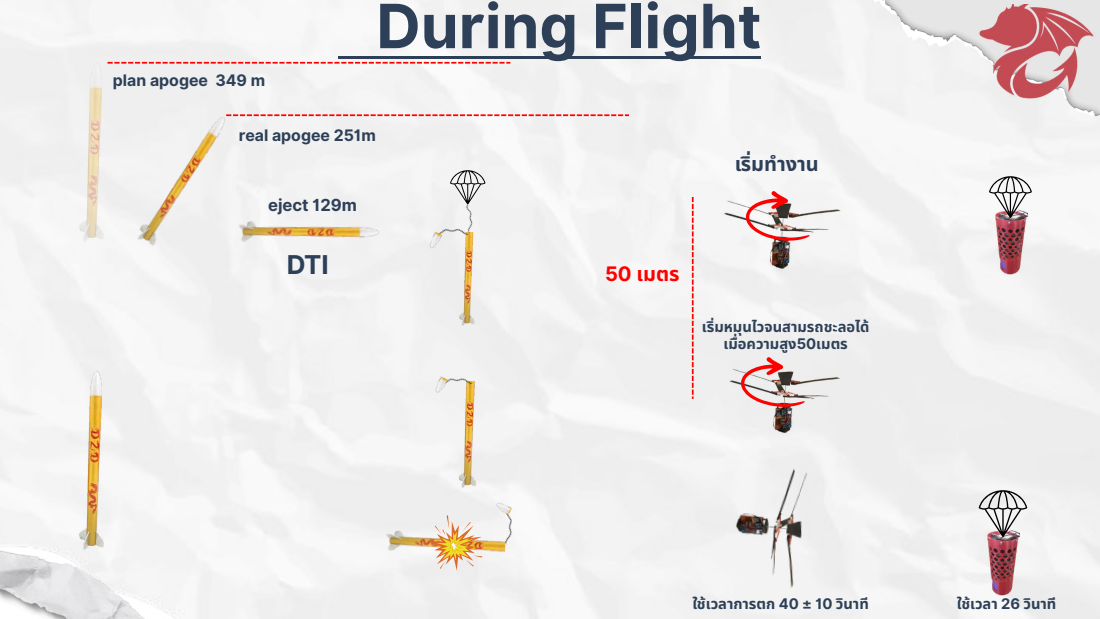
[picture p16: page 11]
eject 129m; real apogee 251m; plan apogee 349 m; หมุนไวจนสามรถชะลอได้; ความสงู 50เมตร; างาน; 50 เมตร; วลาการตก 40 ± 10 วินวิ; DTI

วลา 26 วนิ าที

# During Flight

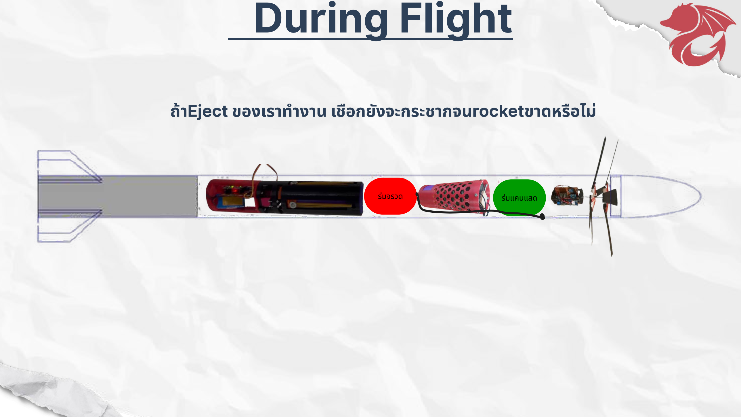
[picture p17: page 12]

ร่มร่ | จรวด | ร่มร่ | แคนแสด

ถ้าEject ของเราท

ํ

างาน เชอ
ื

กยง

ั

จะกระชากจนrocketขาดหรอ

ื ไม

่

# During Flight

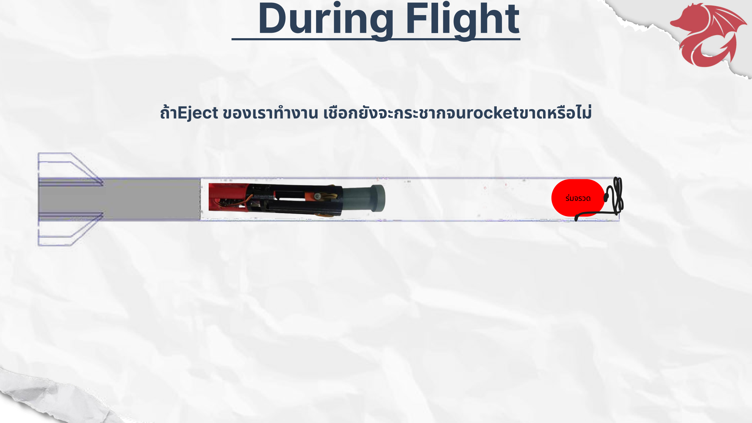
[picture p18: page 13]

ร่มร่ จรวด

ถ้าEject ของเราท

ํ

างาน เชอ
ื

กยง

ั

จะกระชากจนrocketขาดหรอ

ื ไม

่

# During Flight

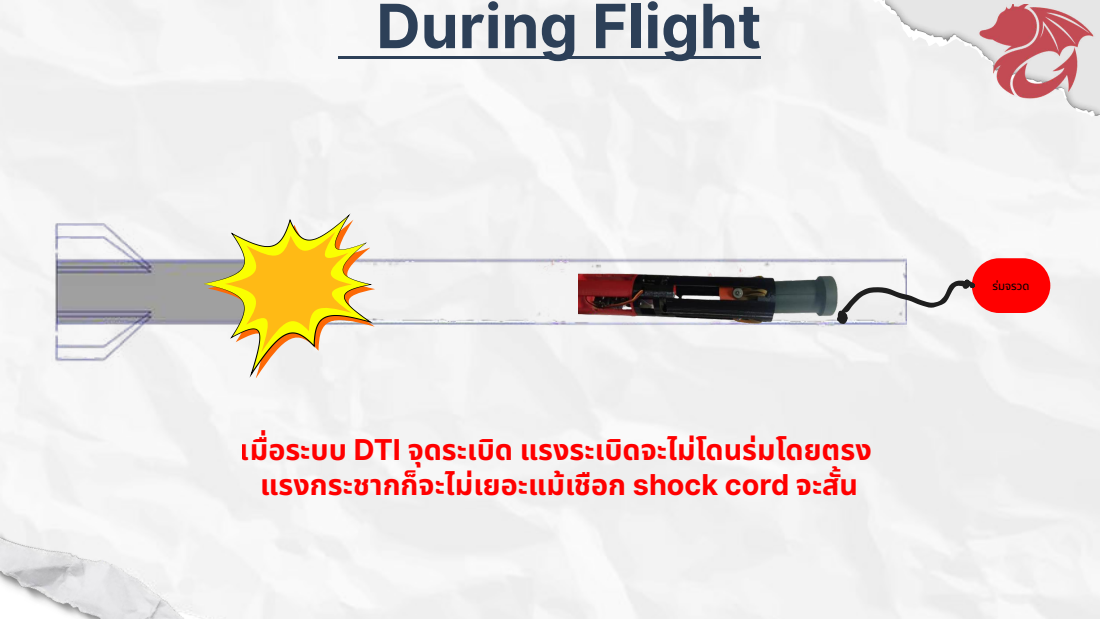
[picture p19: page 14]
จรวด; ระบบ DTI จ; ดระเบด; แรงระเบด; ดนรม; ่ โดยตรง; แรงกระชากก; จะไมเ; ยอะแมเ

จะไมโ่
ก shock cord จะสน

# During Flight

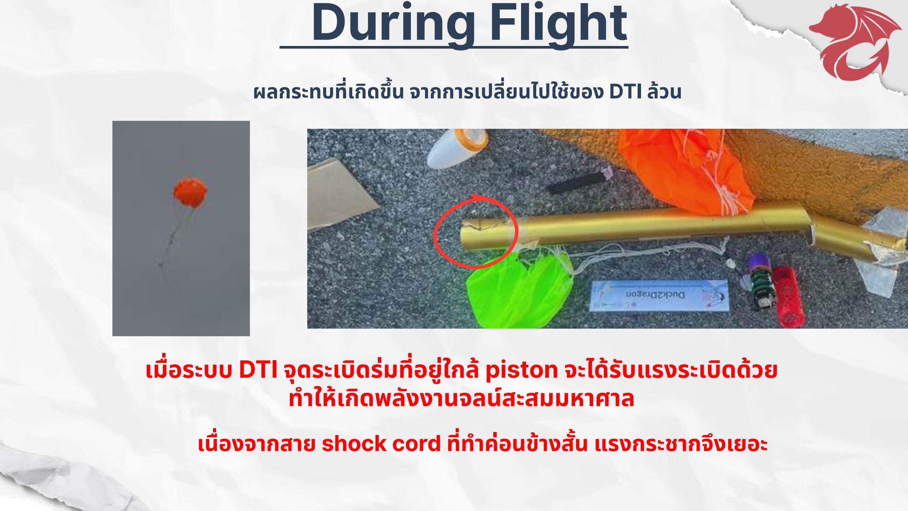
[picture p20: page 15]

เนื่อ
นื่

งจากสาย shock cord ท

ีc
ท

ํ

าค

่

### อนขา

้

### งสน

ั
f

### แรงกระชากจง

ึ

### เยอะ

เมื่อ
มื่

## ระบบ DTI จุดระเบิดบิ ร่ม

ร่

ที่อยู่ใยู่

กล้ piston จะได้รับ
รั

## แรงระเบิดบิ ด้วย

ทำ ให

้

## เกิดพล

ั

## งงานจลนส

์

## ะสมมหาศาล

ผลกระทบที่เกิดขน

f
ึ

จากการเปล

ีc
ยนไปใชข
้

อง DTI ล

้

วน

# After Flight

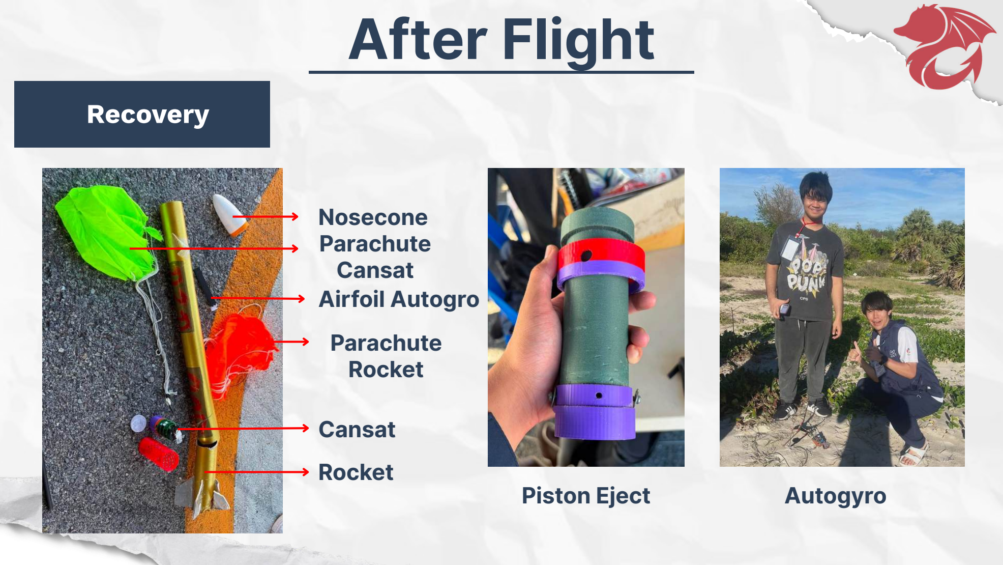
[picture p21: page 16]

Recovery

Piston Eject | Autogyro

Nosecone

Cansat
Rocket

Airfoil Autogro

Parachute
Cansat

Parachute
Rocket

# Cansat mission

01

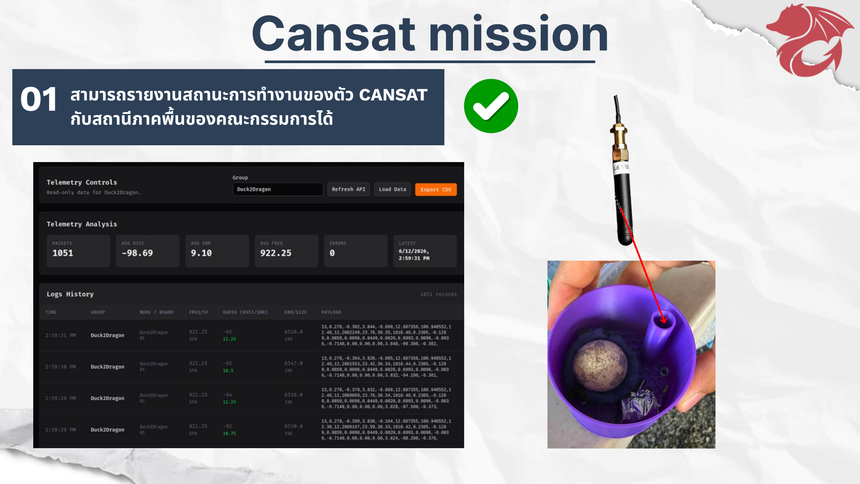
[picture p22: page 17]

สามารถรายงานสถานะการทํางานของตัว CANSAT กับสถาน

ี
ภาคพ

f
น

ื

ของคณะกรรมการได

้

02

# Cansat mission

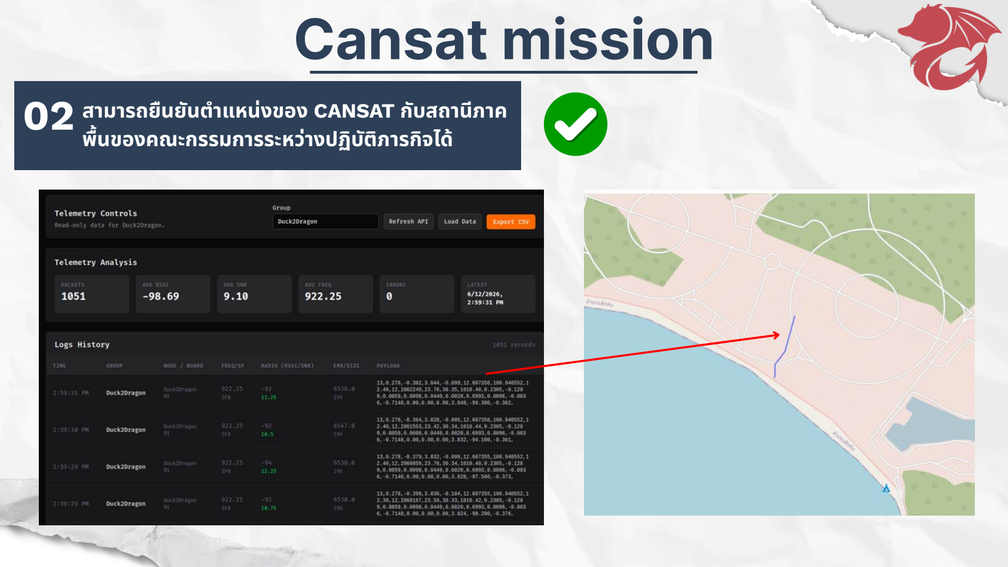
[picture p23: page 18]

สามารถยืน
ยื

ยัน
ยั

ตําแหน่ง
น่

ของ CANSAT กับสถานีภาค

พื้น
พื้

ของคณะกรรมการระหวา

่

งปฏิบต

ั ิภารกิจได

้

03

# Cansat mission

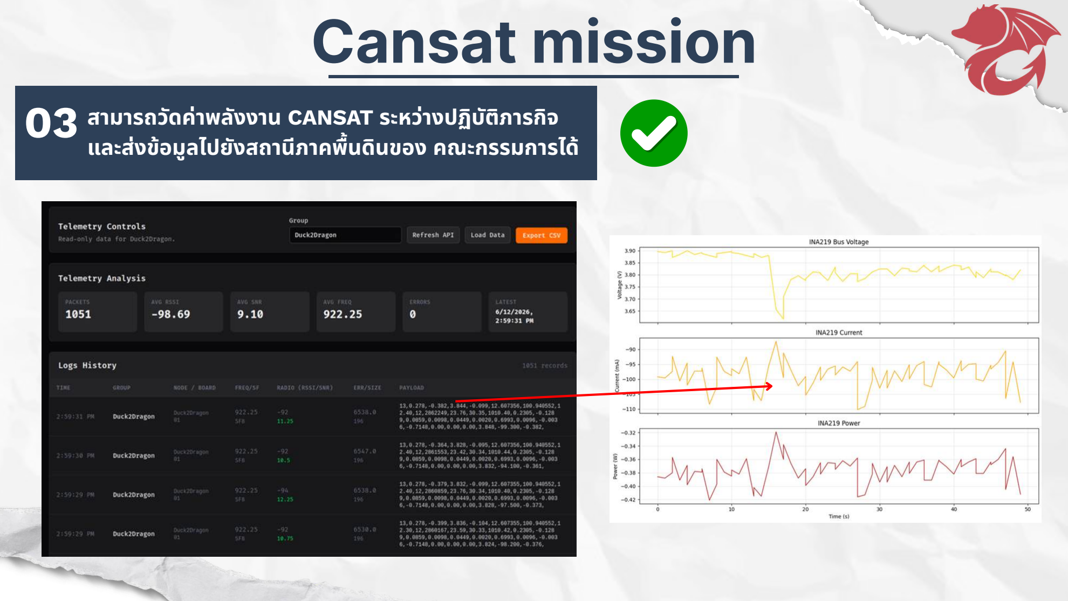
[picture p24: page 19]

สามารถวัด
วั

ค่าพลังงาน CANSAT ระหว่า
ว่

งปฏิบัติ

บั ติภารกิจ
และส่ง
ส่

ขอ

้

ม

ู

ลไปยง

ั

สถาน

ี
ภาคพ

f
น

ื

ดินของ คณะกรรมการได

้

ทํางานอยู่บ
ยู่

นอากาศไม่น้
ม่

อ
น้

ยกว่า

ว่ | 90 วินวิ | าที(เริ่มริ่ | นับ นั เมื่อ
มื่
CANSAT ถูก

ถู

ปล

่

อยออกจากจรวด)

04

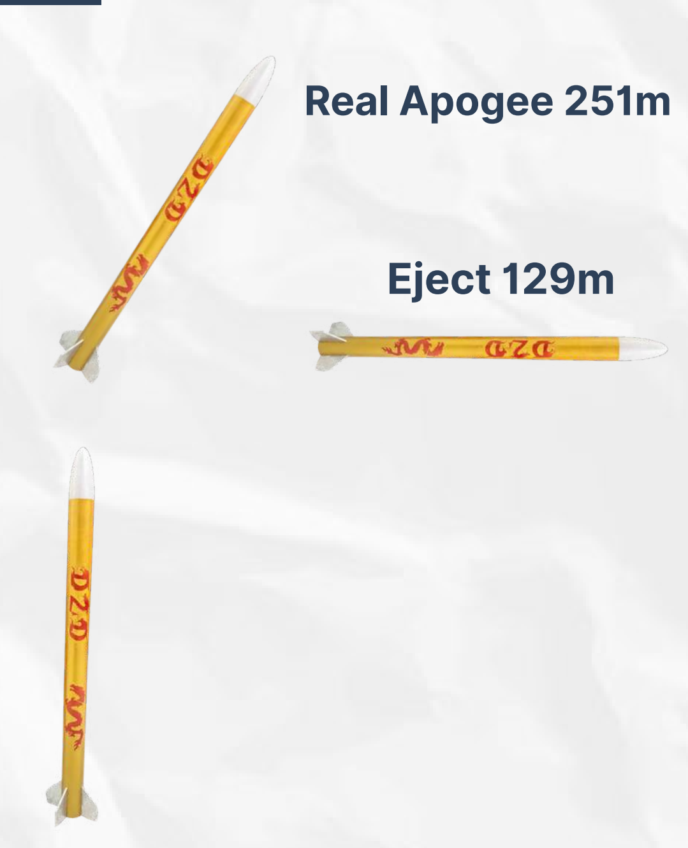
[picture p25: figure]
Eject 129m; Real Apogee 251m

Deployment 14:50:00

Landing 14:50:26

# Cansat mission

### 26 s

05
วัด
วั

ความเรง

่

ขณะขน

f
ึ

และลงจอดได

้

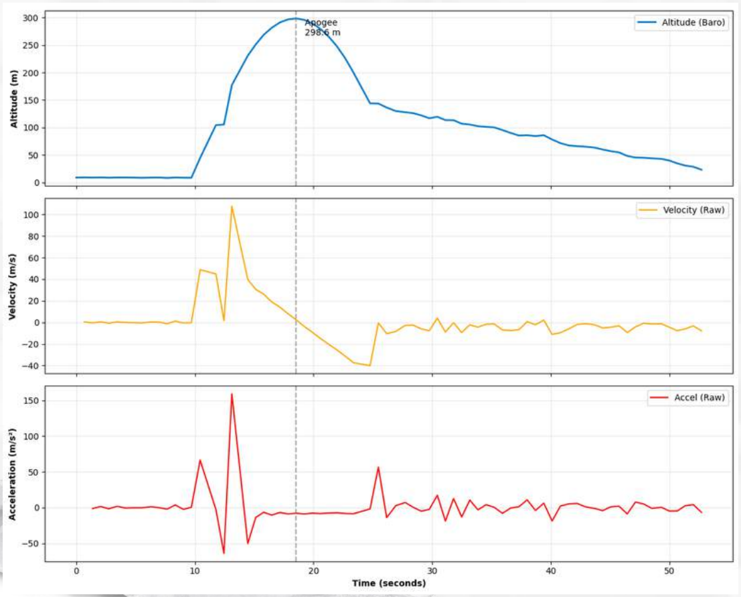
[picture p26: figure]

ความเร่ง
ร่

ขณะขึ้น

ขึ้
อยู่ที่

ยู่ ที่ 158.990 m/s
2
ความเร่ง
ร่

ขณะลงจอดอยู่ที่

ยู่ ที่ 0.531 m/s
2

MS5611 วัด
วั

ความสง

ู
vt = ht-ht-1
Δt
at = vt-vt-1
Δt

# Cansat mission

ความเร็ว
ร็

ก

่

อนตก 50 เมตรอย

ู

ท

่ ีc 5.877 m/s

บรรจุไข่ โดยมีอ
มี

ย่า
ย่

งน้อ
น้

ย 1 ฟองอยู่ใยู่

น
สภาพสมบูรณห

์

ล

ั

งลงจอด

06

# Cansat mission

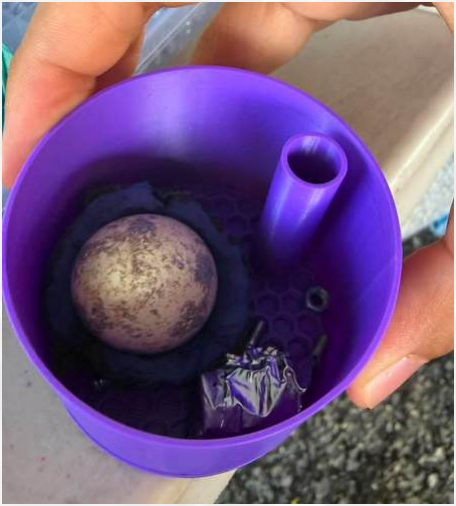
[picture p27: figure]

# Cansat mission

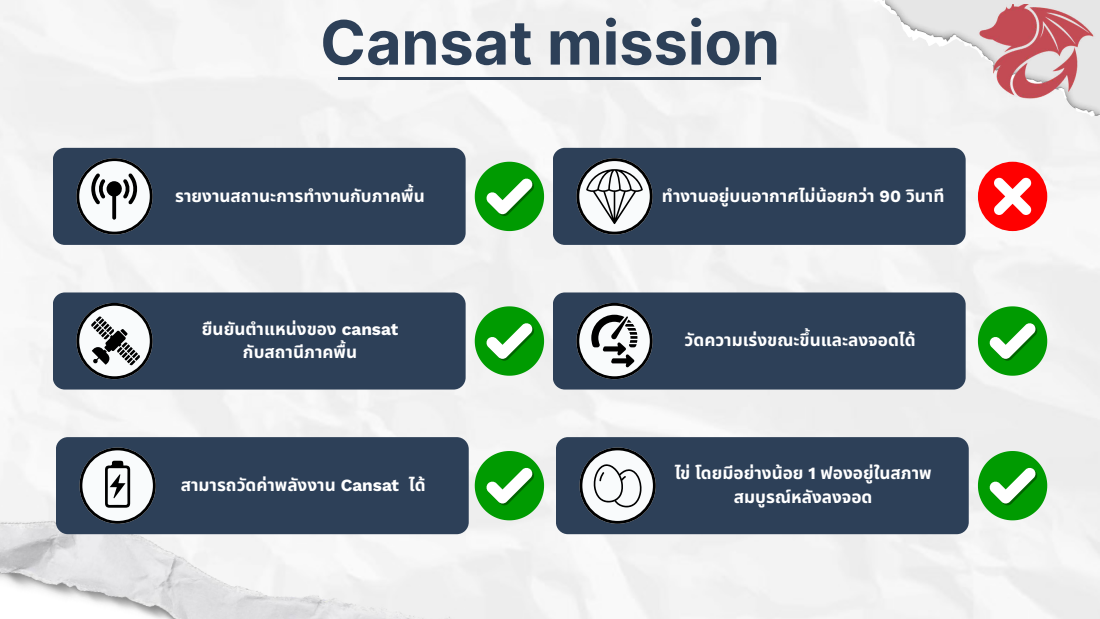
[picture p28: page 23]
ไข่ โดยมีอมี; ย 1 ฟองอยู่ใยู่; นสภาพ; ตำ แหน่ง; ของ cansat กับสถานีภาคพ; สามารถวัดวั; ค่าพลังงาน Cansat ได้; ทํางานอย; นอากาศไมน; ยกวา; ความเรง; ขณะขน; fึและลงจอดได ้

รายงานสถานะการทำ งานกับภาคพ

สมบูรณห์ ลังลงจอด

# Rocket mission

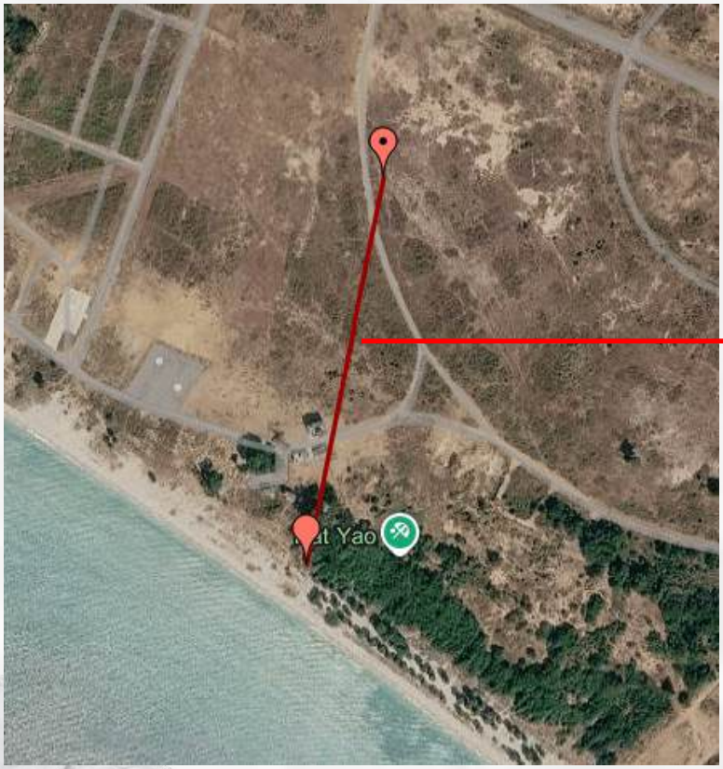
[picture p29: figure]

ROCKET ต้องตกภายในรัศ
รั

มีไมี

ม่เ
ม่

กิน 300
เมตร จากจุดปล

่

อย

01

286.476 m.

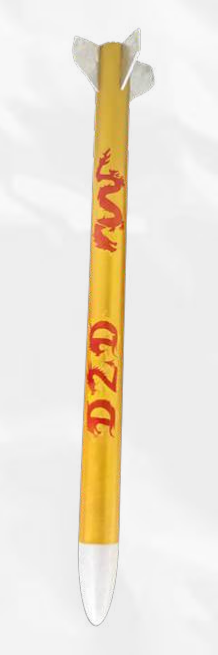
[picture p30: figure]

Free Fall

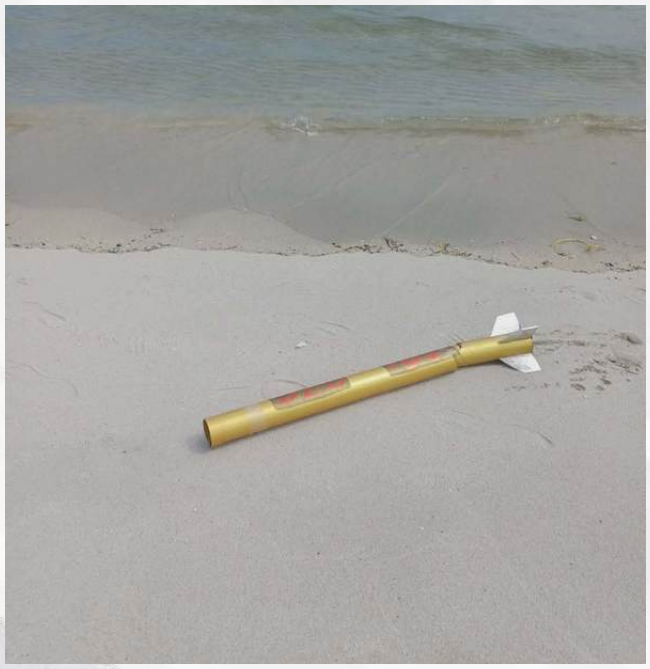
[picture p31: figure]
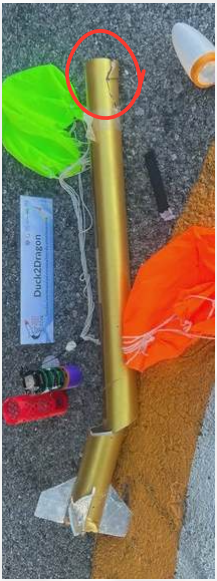
[picture p32: figure]
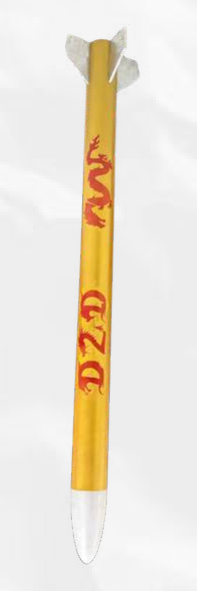
[picture p33: figure]

ROCKET ต้องสามารถกลับสู่พื้สู่ พื้ น

พื้ ในสภาพ
สมบูรณ

์

และสามารถนา

ํ

กล

ั

บมาใชใ้

| หมไ่ ด ้

02

# Rocket mission

Free Fall

# Rocket mission

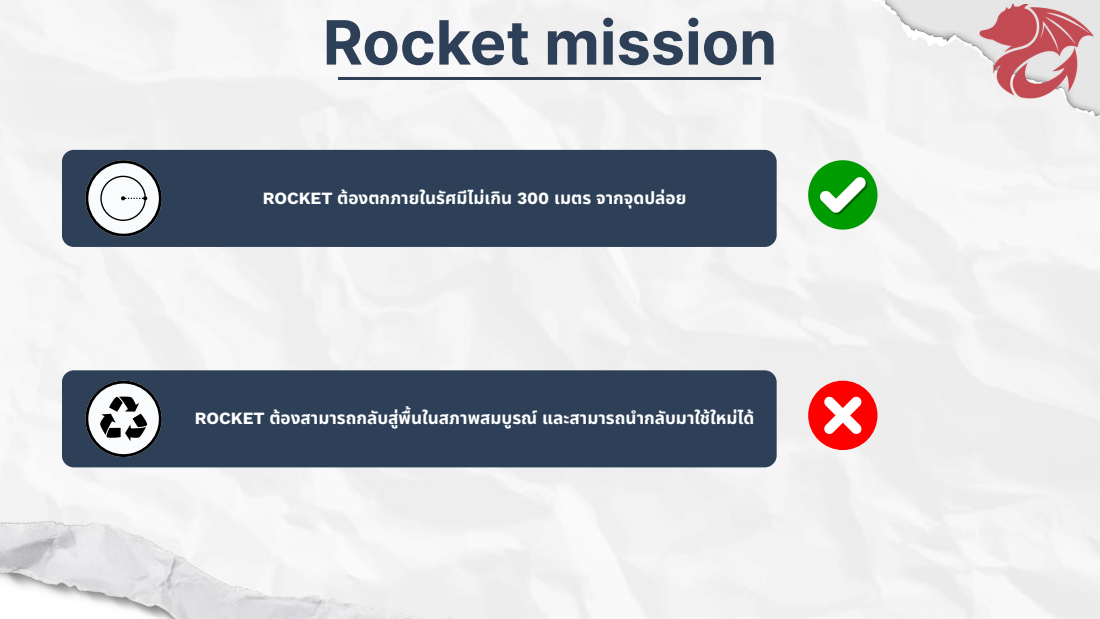
[picture p34: page 26]
นื ในสภาพสมบ; รณ์และสามารถนา; กลับมาใชใ้; หมไ่

ROCKET ต้องตกภายในรศั มไีมเ

กิน 300 เมตร จากจุดปล

ROCKET ต้องสามารถกลับสพู่ f

# Sub mission

01

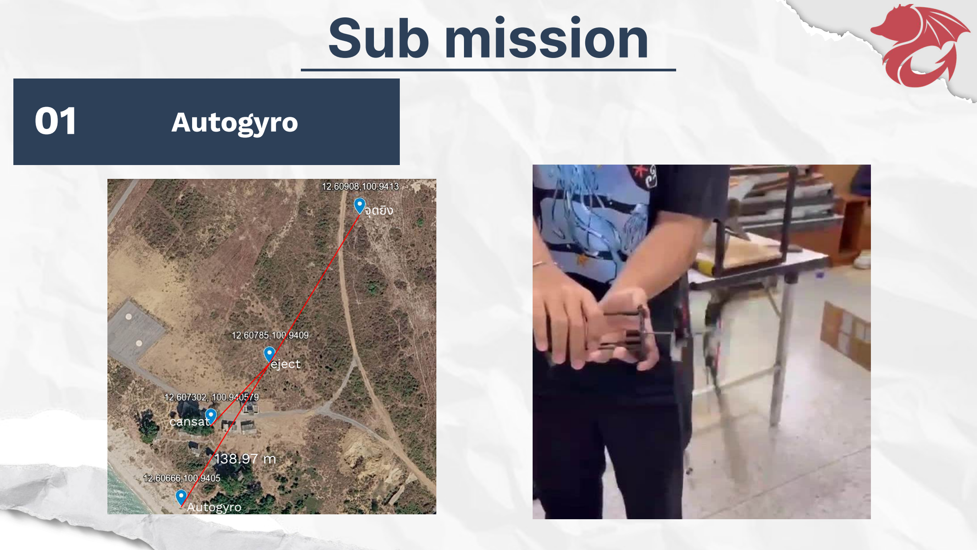
[picture p35: page 27]

Autogyro

จุ | ดยง ิ

eject

cansat

Autogyro

138.97 m

# Sub mission

01
Autogyro

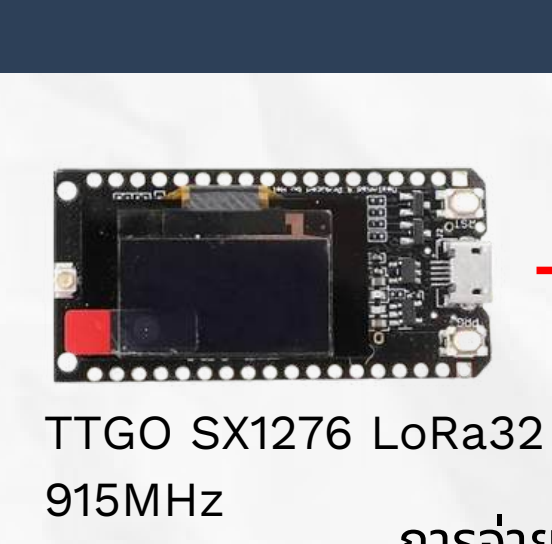
[picture p36: figure]
TTGO SX1276 LoRa32 915MHz
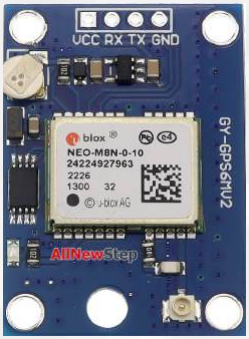
[picture p37: figure]
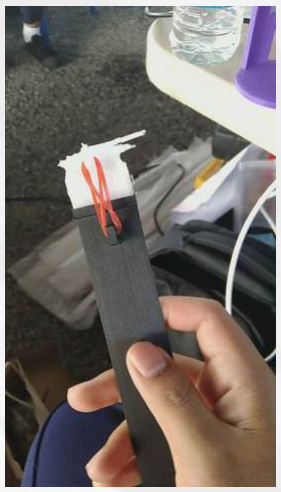
[picture p38: figure]

ADXL345 | GPS Module GY-NEO-M8N

MS5611

esp32 nodemcu-32s

คาดวา

่

รร

ู

บ

ั

ความดน

ั

ขนาดเล

็

ก
ล

ั

ดวงจรจากการโดนละอองน

f
า

ํ

คาดวา

่

เก

ิ

ดจากสายไฟหลวมหลด

ุ
ระหวา

่

งยง

ิ

# การจ่ า

จ่

ยไฟเก

ิ

นขนาด

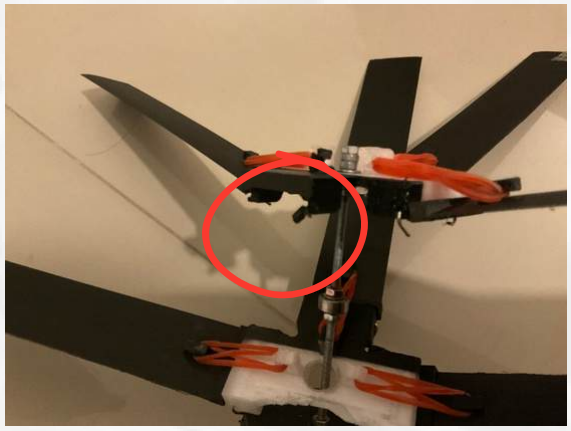
[picture p39: figure]

คาดว่า
ว่

ลวดข้อ
ข้

ต่อเกี่ยวกับเชือชื ก
ที่ติดกับnosecone

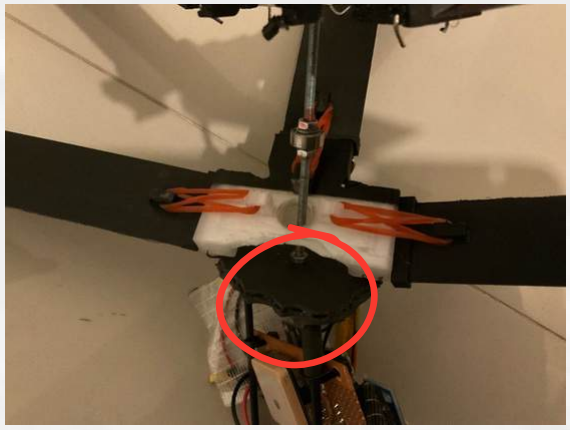
[picture p40: figure]

คาดว่า
ว่

เกิดจากเคลcือนถึงพfนื ดนิ

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
ลเพย

ี

งจาก3จ

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
ดlauncher,จ

ุ

ดeject,จ

ุ

ดlanding
จากการก

ํ

าหนดrawsนอ

้

ยเก

ิ

นไปจง

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
10วน

ิ

าท

ี

# Sub mission

01

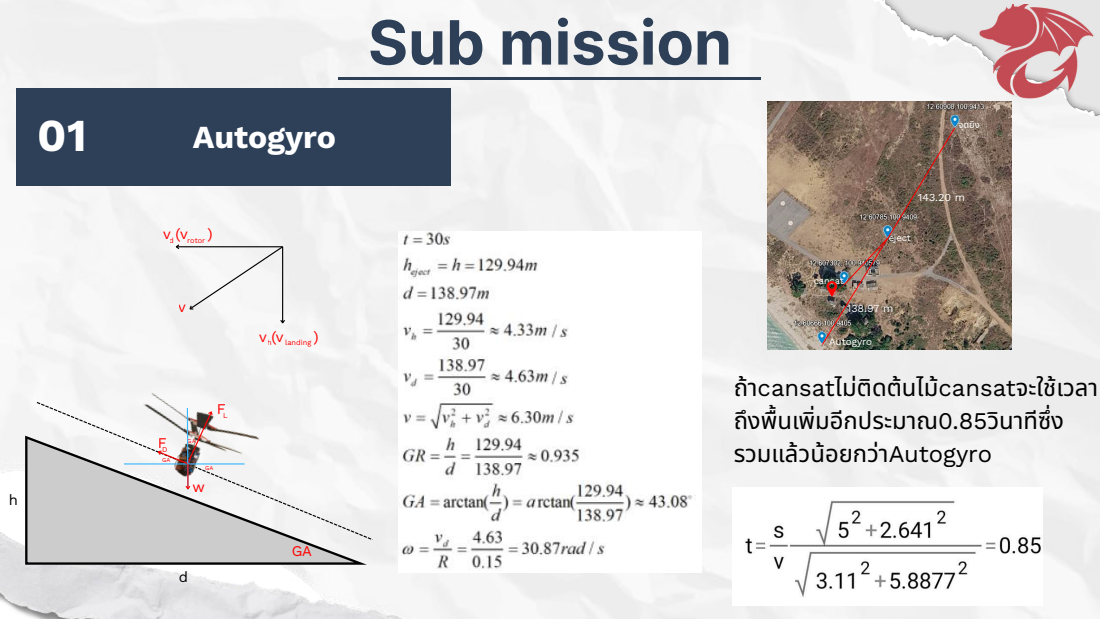
[picture p41: page 29]
cansat; Autogyro; rotor; landing; ดยงิ; eject; าcansatไมต; นไมc; ansatจะใชเ ้; วลา; เพม; กประมาณ0.85วน; รวมแล; วนอ; ยกวา; ่ Autogyro

# Sub mission

01
Autogyro

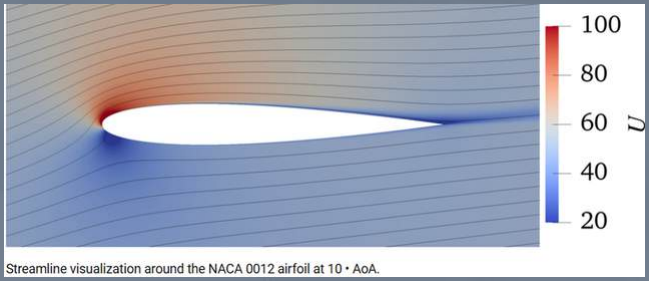
[picture p42: figure]

-NACA 0012, Fixed AoA 10° เพราะ symmetric airfoil ให

้Cl ใกล

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
นีfโดยไมต
่ ้

องมก

ี

ลไกปรบ

ั

ม

ุ

ม ลดความซบ

ั

ซอ

้

น
นํ

f
าหนัก และความเสย

ีc
งจาก motor failure

-2 ใบแบบ Teeter ลดความซบ

ั

ซอ

้

นของ hub
, พบ

ั

เก

็

บเปq

นเสน

้

ตรงได้ง

่

ายในท

่

อ , balance
ง

่

ายเพราะเปq

นชน
ิ
f

เดียวสมมาตร ลดmoment
of inertia

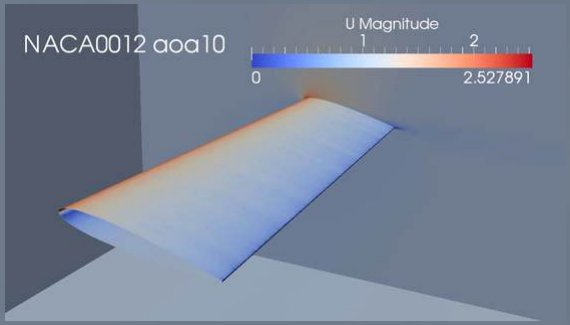
[picture p43: figure]

-ความยาวใบพด

ั

ค

ํ

านวณจาก disk loading
target
Disk loading DL = W/A
ถ

้

า rotor เล

็

กเก

ิ

นไป → DL สง

ู

→ ตกเรว

็ ไม

่
autorotateได้ท

ั

นโดยเฉพาะถ

้

าปล

่

อยจาก
ความสง

ู

ไมม

่

ากพอ

# Sub mission

02
Vitamin-C

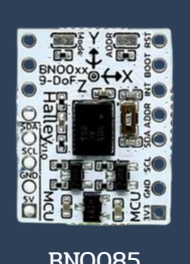
[picture p44: figure]
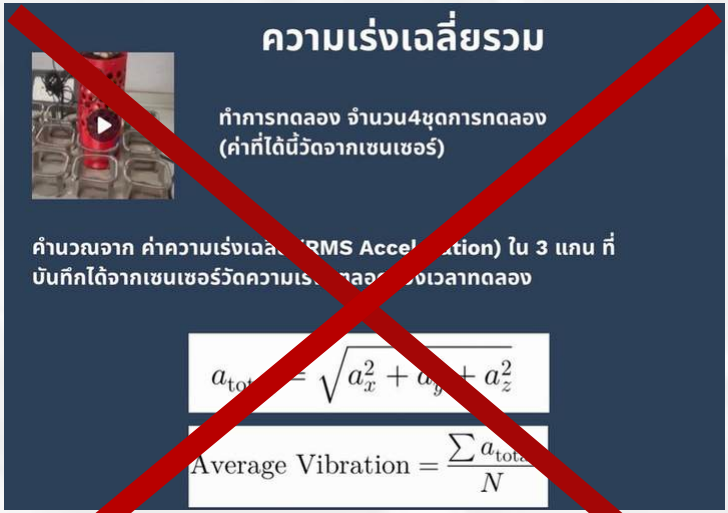
[picture p45: figure]

BNO085

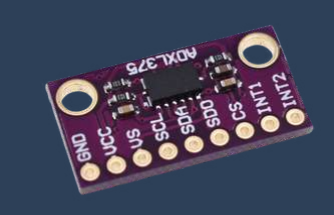
[picture p46: figure]

ADXL375

เซ็น
ซ็

เซอร์วั
ร์

ด
วั

ความเร่ง
ร่

ทั้ง
ทั้

2ต

ั

วไมท

ํ

างาน

ทำ ให

้

จา

ํ

เปน

q

ต

้

องเปล

ีc
ยนสงิc

ท

ีc
จะศ

ึ

กษาในต

ั

วแปร

# แรงG

# Sub mission

02
Vitamin-C

แต่โชคดีที่ในตอนแรกเราวางแผนจะศึกษา 3 ตัวแปร คืออุณหภูมิ

ภู มิ แรงG แรงสั่น
สั่
ทำ ให้เราพอจะมีข้
มี

อ
ข้

มูล แรงG ที่ศึกษาจากเครื่อ
รื่

งเหวี่ย

วี่
ง
และค่าความเร่ง

ร่ ในแกนz จากเครื่อ
รื่

ง orbital shaker

ค่าคงที่ปฏิกิริยริ า
(*10 min )

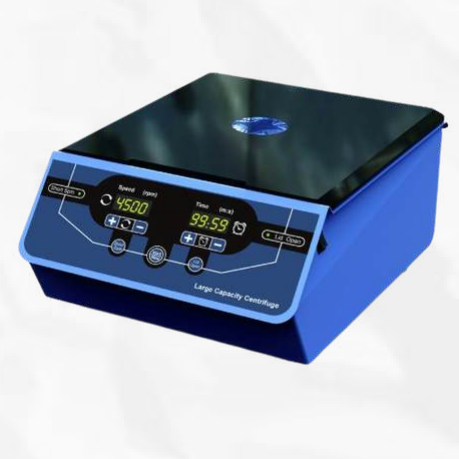
[picture p47: figure]
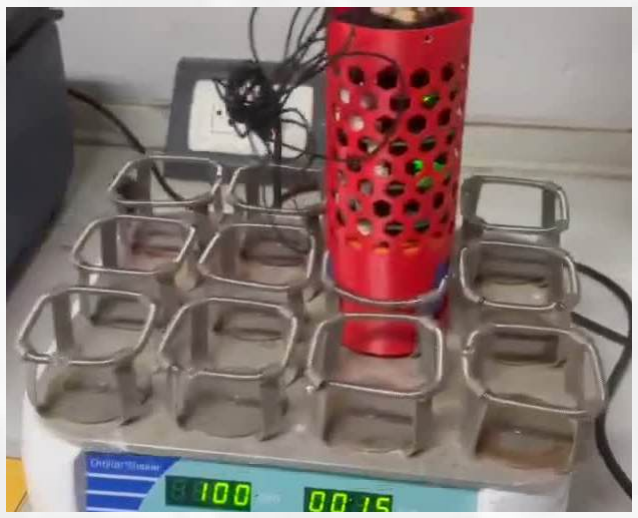
[picture p48: figure]

3 | -1 | อุณหภมู ิ(องศาเซลเซยีส) | แรงG

# Sub mission

02
Vitamin-C

ค

่

าท

ีc
วด

ั ได

้

## จากเซน

็

## เซอร

์

## (นับต

ั
f

## งแต

่

## ตอน ขน

f
ึ

## จนถ

ึ

งตอน eject)

ค

่

าอ

ุ

## ณหภม

ู

เ

ิ

ฉล

ีc
ย = 37.2173

ค

่

## าความเรง

่

## เฉล

ีc
ย = 4.389583

## ทำ นายค

่

## าคงท

ีc

## การสลายต

ั

## วได

้
0.00870 min

-1

## แต่ค่าที่ได้จากการทดลองจริง

ริ 0.116 min

-1

# Sub mission

02
Vitamin-C

เกิดอะไรขน

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
ีcได
้

คลาดเคล

c
ื

อนขนาดน

ีf

2.ตัวแปรท

ีc
ศ

ึ

กษาไมไ่

ด

้

รอบคลม

ุ

การสน

ั
c

ซง

c
ึ

คาดวา

่

เปน

q

ต

ั

วแปลท

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
ของการสลายต

ั

ว

1.จำ นวนช

ุ

ดการทดลองไมม

่

ากพอ ควรมช

ี
ุ

ดการทดลอง 15-30 ช

ุ

ดการทดลอง
แต่เรามีแ
มี

ค่ 8 ชุดการทดลอง เน

c
อ

ื

งจากขอ

้

จา

ํ

ก

ั

ดทางด

้

านเวลา

3.setting การทดลองไม่ด

ม่ ี
พอ เน

c
อ

ื

งจากจา

ํ

เปน

q

ต

้

องเปล

ีc
ยนแผนการทดลอง
เช่น
ช่

การนำ az ของชุดการทดลองการสน ั c มา หาเปน

q

แรงG

# Issue and Solution

## Issue

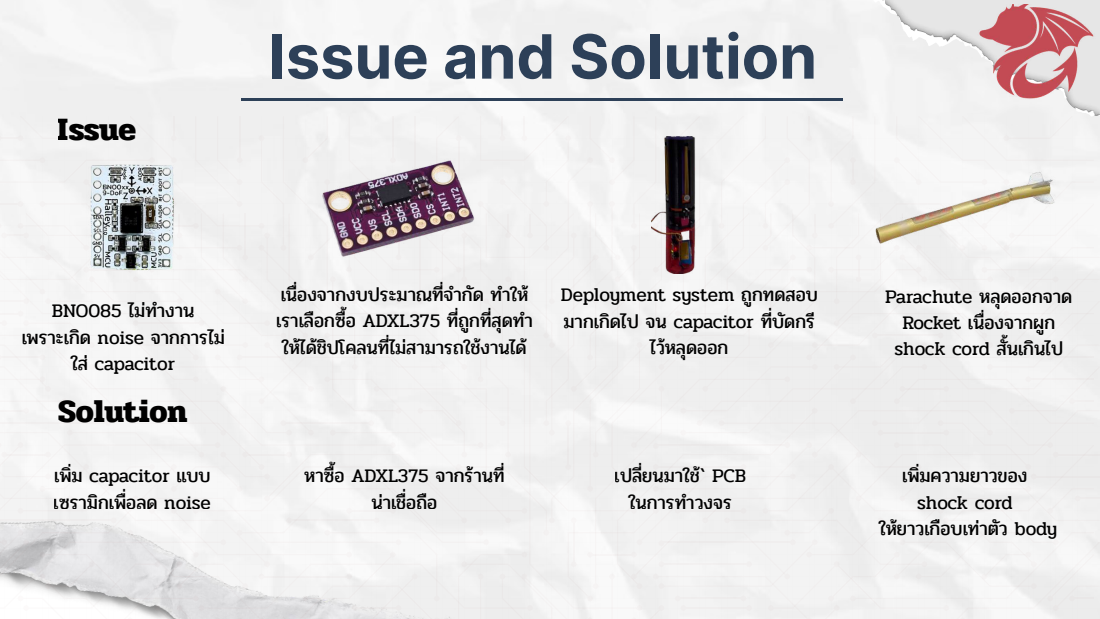
[picture p49: page 35]
BNO085 ไม; ทํางาน; เพราะเก; ด noise จากการไม ใส; capacitor; เนื่องจากงบประมาณที่จำ; ิปโคลนท; สามารถใช; ดออก; Solution; ม capacitor แบบ เซราม; กเพ; อลด noise; หาซ;  อ ADXL375 จากร; านท; าเช; เปล; ยนมาใช; ้` PCB ในการทําวงจร; นไป; เพิ่มความยาวของ shock cord ให้ยาวเก; อบเท; ว body

เราเลือกซื้อ ADXL375 ที่ถูกที่สุดทำ

Deployment system ถูกทดสอบ
มากเกิดไป จน capacitor ที่บัดกรี
งานได

Parachute หลุดออกจาด
Rocket เนื่องจากผูก
shock cord สั้นเก

# Future Plan

AutoGyro | Vitamin-C | Fix all problem

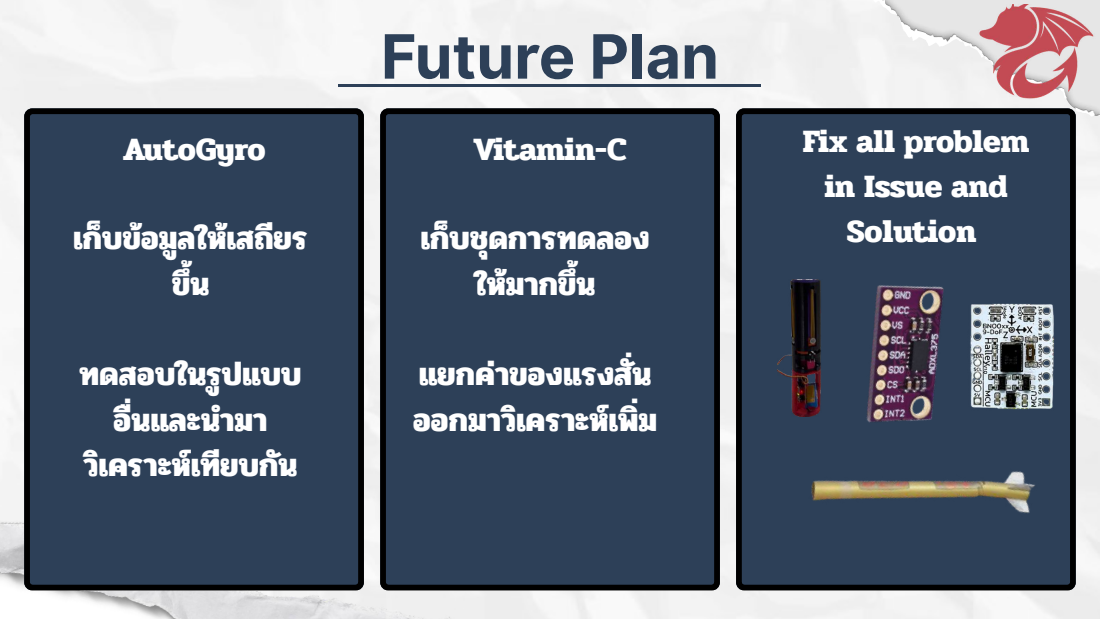
[picture p50: page 36]
เก็บชุดการทดลอง; Solution; ให้มากข; แยกค่าของแรงสั่น ออกมาวิเ วิ; คราะห; ทดสอบในรูปแบบ อื่นและนำ มา; ยบก

in Issue and

เก็บข้อมูลให้เสถียร

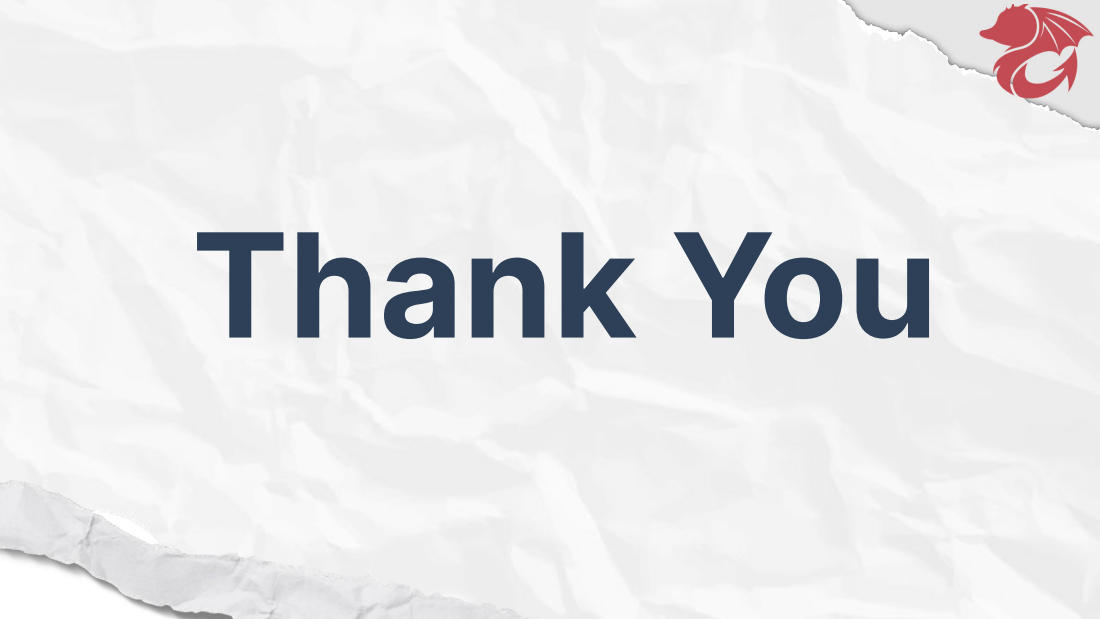
[picture p51: page 37]
Thank You

05
วัด
วั

ความเรง

่

ขณะขน

f
ึ

และลงจอดได

้

# Cansat mission

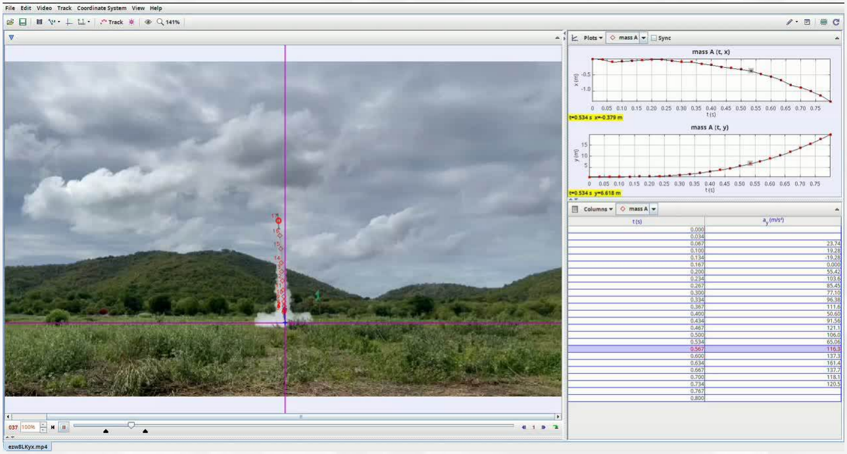
[picture p52: figure]

ความเร่ง
ร่

จาก tracker 161.4 m/s
2

Fthrust - mg = ma
Fthrust = m(g+a)
Fthrust = 1.901(1+22)
Fthrust = 43.723g

Fthrust - mg = ma
43.723 - 2.452 = 2.452a
a = 16.832g
a = 164.953 m/s

2

# Cansat Submission

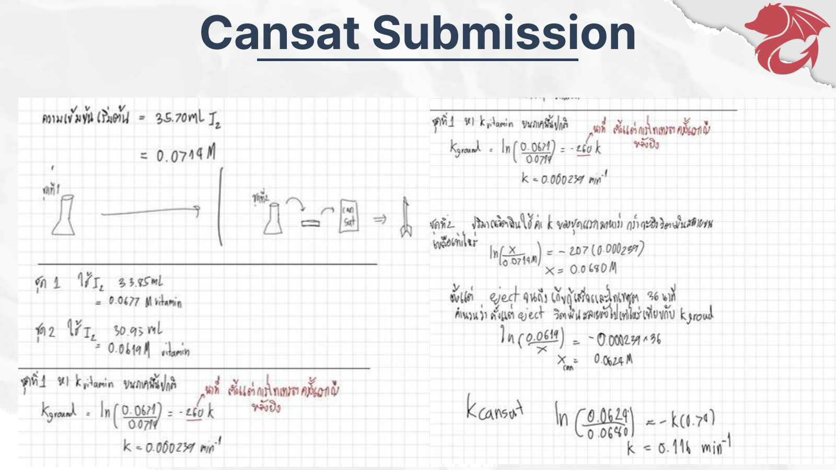
[picture p53: page 39]
