DraSoGo/Cansat_Duck2Dragon/Document/Duck2Dragon.pdf

### 1. รายละเอียดการทำภารกิจ Cansat 1.1 แผนการทำภารกิจหลัก

ภารกิจที่ | ภารกิจ | รายละเอียด | อุปกรณ์ที่ใช้ / รูปประกอบ
1 | สามารถรายงาน สถานะการ ทํางานของตัว แคนแซทกับ สถานีภาคพื้นของ คณะกรรมการได้ | ใช้ระบบ LoRa ในการสื่อสาร โดยใช้ TTGO SX1276 LoRa32 เป็นบอร์ดควบคุม ที่มีความถี่ 915MHz โดย คาดการณ์ระยะมากที่สุดที่จรวดจะไปไกลฐาน 10 กิโลเมตร และ 915MHz Flexible Antenna ที่จะ ขยาย RX 5dBi และค่า Tx ของ TTGO มีขนาด 18dBm จากการคำนวณ FSPL ได้ค่าอยู่ที่ -104.7 dB จะได้ความเข้มสัญญาณสุทธิประมาณที่ 25.44 dB ทำ ให้มีประสิทธิภาพในการรับส่งสัญญานที่ดี | 1. TTGO SX1276 LoRa32 915MHz 2. FPC flexible antenna 915 MHz

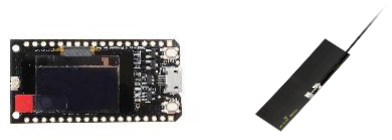
[picture p54: figure]

2 | สามารถยืนยัน ตําแหน่งของ CANSAT กับ สถานีภาคพื้นของ คณะกรรมการได้ | ยืนยันตำแหน่งของ CANSAT ด้วย GPS Module GY-NEO-6M Ublox ในการจับพิกัดออกมาเป็น longitude และ latitude ใช้ MS5611 ในการหาระดับความสูง แล้วจึงคำนวณหาตำแหน่งของ CANSAT | 1. GPS Module GY-NEO-6M 2. MS5611

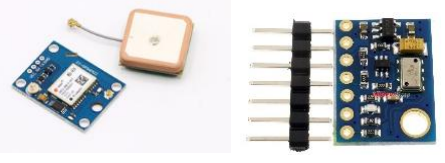
[picture p55: figure]

3 | สามารถวัดค่า พลังงาน CANSAT ระหว่างปฏิบัติ ภารกิจ และส่ง ข้อมูลไปยังสถานี ภาคพื้นดินของ คณะกรรมการได้ | ใช้เซนเซอร์ INA219 ซึ่งเป็น IC ที่ออกแบบมาเพื่อวัดค่า พลังงานโดยเฉพาะ สามารถวัดได้ทั้งแรงดันไฟฟ้า และ กระแสไฟฟ้า ที่ระบบดึงไปใช้งาน ทำให้สามารถ คำนวณหาค่ากำลังไฟฟ้าได้ | 1. INA219
4 | ทํางานอยู่บน อากาศไม่น้อย กว่า 90 วินาที | จากน้ำหนักของ Cansat 300 กรัม สามารถคำนวณจาก Parachute ขนาดเส้นผ่านศูนย์กลาง 66 cm. โดย สามารถคำนวณเวลาในการตกได้จากสูตรการ คำนวณที่ [1] โดยความเร็วขณะตกสูงพื้นประมาณ 4.21 m/s และใช้EMRR Parachute Calculator คำนวนเวลา การตกได้99s

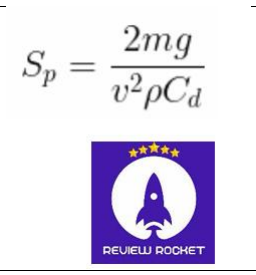
[picture p56: figure]

5 | วัดความเร่ง ขณะขื้นและลง จอดได้ | ใช้เซนเซอร์ADXL375 ในการตรวจวัดความเร่งขณะลง จอด | ADXL375

### 1.2 แผนการทำภารกิจเสริม

ภารกิจเสริมที่1 สร้างสมการ multiple regressionวิเคราะห์การสลายตัวของวิตามินซี(ascorbic acid) ในสภาวะต่างๆ 1.2.1 ที่มาและความสำคัญของภารกิจเสริม
การส่งเสบียงและยาสู่อวกาศต้องเผชิญสภาวะวิกฤต ทั้ง อุณหภูมิ แรงสั่นสะเทือน และ แรงจี (G-force) ที่เปลี่ยนแปลง ฉับพลันระหว่างการปล่อยและกลับสู่โลก ปัจจัยเหล่านี้ส่งผลกระทบโดยตรงต่อเสถียรภาพของสารชีวเคมี โดยเฉพาะ วิตามินซี (Ascorbic Acid) ซึ่งเป็นสารต้านอนุมูลอิสระที่ไวต่อปฏิกิริยาออกซิเดชันและสลายตัวได้ง่าย คณะผู้จัดทำจึงเล็งเห็นถึงความ จำเป็นในการศึกษาผลกระทบของปัจจัยดังกล่าว โดยเฉพาะในสภาวะแรงจีและแรงสั่นสะเทือนสูงผ่านแบบจำลอง CanSat เพื่อ วิเคราะห์อัตราการสลายตัวของวิตามินซี ข้อมูลที่ได้จะเป็นองค์ความรู้สำคัญในการพัฒนาระบบจัดเก็บและขนส่งเสบียงที่คง ประสิทธิภาพสูงสุดสำหรับการสำรวจอวกาศในอนาคต
1.2.2 ผลที่คาดว่าจะได้รับ
1.2.2.1 ข้อมูลที่ได้จากการวิจัยนี้สามารถนำไปใช้ปรับปรุงกระบวนการขนส่งอาหารและยาไปยังสถานีอวกาศ รวมถึง การเตรียมเสบียงสำหรับ ภารกิจระยะยาว เช่น การสำรวจดวงจันทร์หรือดาวอังคาร
1.2.2.2 การศึกษานี้จะช่วยระบุว่า ปัจจัยใดสามารถส่งผลต่อการสลายตัวของวิตามินซีโดยสร้างสมการmultiple regression ออกมาเพื่อใช้ในการคำนวนอัตราการสลายตัวของวิตามินซีได้เพียงแค่ใส่ค่าของแต่ละตัวแปรลงไป
1.2.2.3 การศึกษานี้จะช่วยส่งเสริมความเข้าใจด้าน เคมีของวิตามินและปฏิกิริยาออกซิเดชันในสภาวะพิเศษ ซึ่งเป็น ข้อมูลสำคัญสำหรับนักวิทยาศาสตร์นักโภชนาการ และวิศวกรอวกาศ ในการออกแบบระบบสนับสนุนชีวิตในอวกาศที่มี ประสิทธิภาพมากขึ้น
1.2.3 วัตถุประสงค์
1.2.3.1 เพื่อศึกษาผลกระทบของ G-force แรงสั่น อุณหภูมิต่ออัตราการสลายตัวของวิตามินซีอย่างละเอียด 1.2.3.2 เพื่อเปรียบเทียบการสลายตัวของวิตามินซีภายใต้G-force สูง (เช่น ระหว่างการปล่อย CanSat) กับสภาวะ ปกติบนพื้นโลก (1G)
1.2.3.3 เพื่อประเมินแนวทางการเก็บรักษาวิตามินซีให้คงตัวภายใต้สภาวะ G-force สูง และแรงสั่นสูง

6 สามารถบรรจุไข่ นกกระทาดิบไม่ จํากัดจํานวนฟอง แต่ต้องมีไข่อย่าง น้อยหนึ่งฟอง ยังคงมีสภาพ สมบูรณ์หลังการ ลงจอด

ระบบป้องกันไข่นกกระทาถูกออกแบบเป็น 2 ส่วนหลัก ได้แก่ส่วนป้องกันรอบนอก มีโครงสร้างทำจาก HDPE โดยฐานด้านล่างถูกออกแบบให้เป็นโครงสร้างแบบ Hexagonal Grid และมีการติดตั้ง Air Bubble เพื่อกัน กระแทกด้านข้าง สำหรับ ส่วนป้องกันชั้นใน ที่ห่อหุ้มไข่ โดยตรง จะประกอบด้วยวัสดุ 2 ชั้น คือ ชั้นนอกสุดทำ จากวัสดุ TPU และบุภายในด้วยโฟม EVA เพื่อดูดซับ แรงกระแทกก่อนถึงตัวไข่นกกระทา

ตัวแปรต้น
ค่า อุณหภูมิแรงG แรงสั่น ในแต่ละชุดการทดลองย่อยและ เปรียบเทียบระหว่างบนภาคพื้นปกติและ การนำส่งใน cansat
ตัวแปรตาม
ปริมาณวิตามินซีที่เหลืออยู่หลังการทดลอง
อัตราการสลายตัวของวิตามินซีภายใต้สภาวะต่างๆ
ตัวแปรควบคุม
ปริมาณออกซิเจนในภาชนะ(ทำให้ภาชนะเป็นระบบปิด) ,ชนิดของภาชนะบรรจุ ,ความเข้มข้นของวิตามินซีเริ่มต้น ,เวลา ที่ใช้เก็บตัวอย่าง ,อุปกรณ์ที่ใช้ในการทดลอง
1.2.4 กระบวนการ
การเตรียมตัวอย่าง: ละลายกรดแอสคอร์บิก 62.5 มก. ในน้ำกลั่น 25 มล. บรรจุในขวด PET ขนาด 30 ลบ.ซม. (เหลือช่องว่าง อากาศ 5 ลบ.ซม. เพื่อให้มีออกซิเจนสำหรับปฏิกิริยา Oxidation)
การเก็บข้อมูลกายภาพ: ใช้เซ็นเซอร์ADXL375 และ MS5611 บันทึกค่า อุณหภูมิ, แรง G (ความเร่งลัพธ์) และ แรงสั่นสะเทือน (ความเร่งที่เปลี่ยนแปลงในแนวแกน X และ Z) ตลอด 10 นาที
แผนการทดลอง (12 ชุดข้อมูล):
ชุดที่ 1-11 ชุดการทดลองควบคุม: ดำเนินการที่โรงเรียนเพื่อสร้างฐานข้อมูล (Database) สำหรับสมการ Regression โดยแยก ทดลองทีละปัจจัยและแบบผสม และใช้การไทเทรตเพื่อหาอัตราการสลายตัว *หมายเหตุในชุดควบคุมเราจะใช้เตาอบในการควบคุมอุณหภูมิและใช้เครื่องใส่ในการควบคุมแรงสั่น ซึ่งการทดลองนี้เรา ทำการศึกษาที่โรงเรียน มิได้นำเครื่องเหล่านี้ไปทดสอบที่สนามแข่งจริง รวมถึงค่าทั้งหมด 11 ชุดเราทำที่โรงเรียนและจดบันทึก เพื่อให้มีข้อมูลเพียงพอในการทำสมการ mutiple regression โดยการทดลองครั้งที่12 เป็นการเก็บค่าจากสภาวะบนแคนแสด จริงๆ
ชุดที่ 12 สภาวะบนแคนแสดจริง: บันทึกค่าจริงจากสภาวะขณะปฏิบัติภารกิจ CanSat ในสนามแข่งขัน
การวิเคราะห์ผล: ไทเทรตหาความเข้มข้นที่เหลือด้วย สารละลายไอโอดีนมาตรฐานและน้ำแป้ง เพื่อคำนวณอัตราการสลายตัว (M/นาที) แล้วนำไปประมวลผลด้วย Multiple Regression โดยใช้โปรแกรม spss

ภารกิจเสริมที่2 Autogyro
โมดูล Autogyro ทำงานโดยอาศัยการเปลี่ยนพลังงานศักย์จากการตกให้เป็นพลังงานการหมุนของใบพัดผ่านหลักการ Autorotation โดยเมื่อโมดูลถูกปล่อยจากที่สูง ระบบใบพัดจะเริ่มกางออกและตัวโมดูลจะตกลงภายใต้แรงโน้มถ่วง อากาศที่ ไหลผ่านจากด้านล่างขึ้นด้านบนจะทำให้ใบพัดเริ่มหมุนโดยไม่ต้องใช้มอเตอร์ เมื่อความเร็วรอบเพิ่มขึ้น ใบพัดจะสร้างแรงยกและ

แรงต้านอากาศที่ช่วยลดความเร็วในการตกของโมดูล จนเข้าสู่สภาวะสมดุลของแรงที่น้ำหนักมีค่าใกล้เคียงกับแรงยก ทำให้เกิด ความเร็วตกคงที่ที่ต่ำลง (terminal velocity) ในขณะเดียวกัน การหมุนของใบพัดยังช่วยเพิ่มเสถียรภาพของระบบด้วยผลของ แรงไจโรสโคป ลดการเอียงและการแกว่งของตัวลำ และในกรณีที่ใช้ใบพัดแบบ 2 ชั้นหมุนสวนทางกัน จะช่วยหักล้างแรงบิดและ ลดผลกระทบจาก Gyroscopic precession ทำให้การตกมีความนิ่งมากยิ่งขึ้น ระหว่างการทำงาน เซนเซอร์ต่าง ๆ เช่น IMU, GPS และตัววัดความเร็วรอบ จะทำหน้าที่เก็บข้อมูลเกี่ยวกับความเร่ง ความเร็ว การหมุน และพฤติกรรมการตกของระบบ ก่อน บันทึกลงหน่วยความจำเพื่อนำไปวิเคราะห์และสร้างแบบจำลองทางคณิตศาสตร์ต่อไป เมื่อโมดูลตกถึงพื้น ระบบจะสิ้นสุดการ ทำงานและสามารถนำข้อมูลที่ได้ไปใช้ในการปรับปรุงประสิทธิภาพของโมดูลในอนาคตได้อย่างมีประสิทธิภาพ

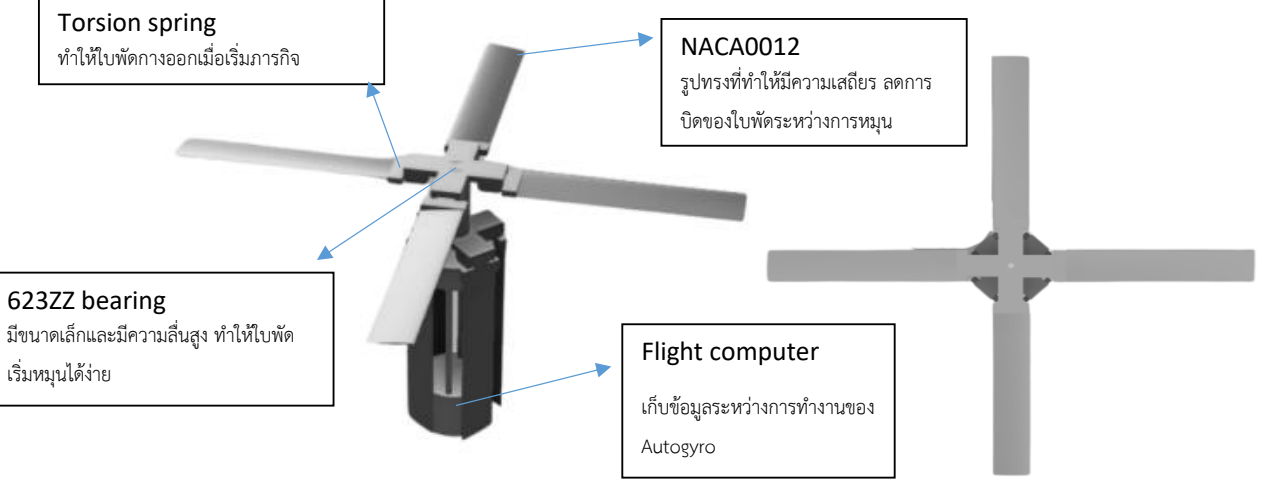
[picture p57: figure]
NACA0012 รูปทรงที่ทำให้มีความเสถียร ลดการ บิดของใบพัดระหว่างการหมุน; Torsion spring ทำให้ใบพัดกางออกเมื่อเริ่มภารกิจ; 623ZZ bearing มีขนาดเล็กและมีความลื่นสูง ทำให้ใบพัด; เริ่มหมุนได้ง่าย; Flight computer; เก็บข้อมูลระหว่างการทำงานของ Autogyro
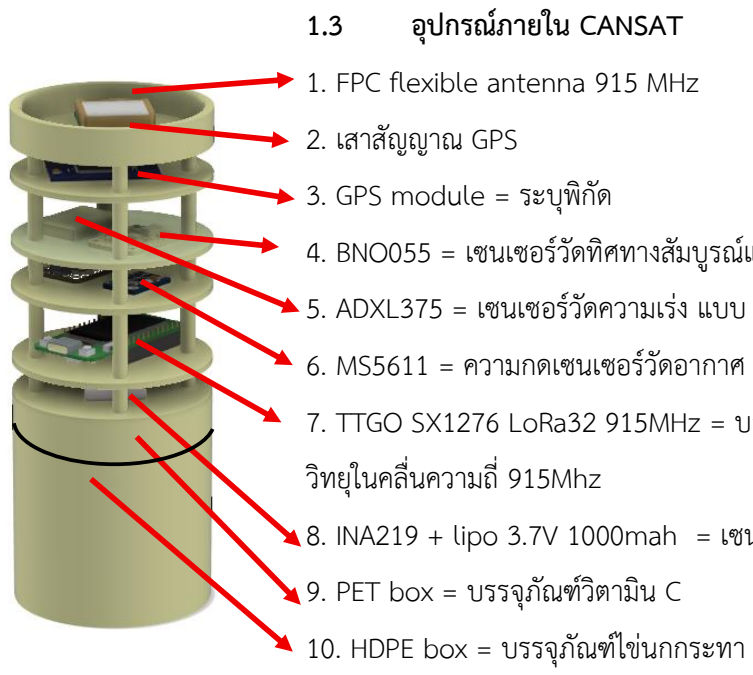
[picture p58: figure]
1.3 อุปกรณ์ภายใน CANSAT 1. FPC flexible antenna 915 MHz 2. เสาสัญญาณ GPS 3. GPS module = ระบุพิกัด; วิทยุในคลื่นความถี่ 915Mhz; 9. PET box = บรรจุภัณฑ์วิตามิน C 10. HDPE box = บรรจุภัณฑ์ไข่นกกระทา

4. BNO055 = เซนเซอร์วัดทิศทางสัมบูรณ์แบบ 9 แกน
5. ADXL375 = เซนเซอร์วัดความเร่ง แบบ 3 แกนที่มีความไวสูง
6. MS5611 = ความกดเซนเซอร์วัดอากาศ และอุณหภูมิ
7. TTGO SX1276 LoRa32 915MHz = บอร์ดควบคุมหลักที่ทำหน้าที่ส่งข้อมูลผ่าน สัญญาณ
8. INA219 + lipo 3.7V 1000mah = เซนเซอร์วัดค่าพลังงาน + ถ่านจ่ายไฟ

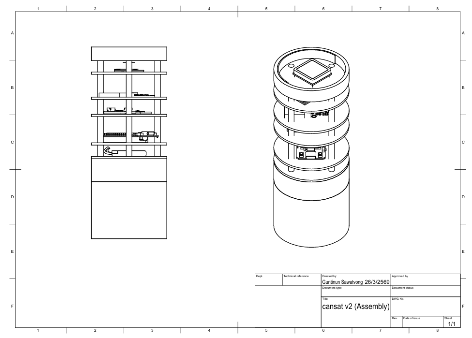
[picture p59: figure]

### 1.4 แผนการทดสอบ CANSAT

การทดสอบที่ | เป้าหมายการทดสอบ | วิธีการทดสอบ
1 | การตรวจสอบโครงสร้าง | -ตรวจสอบวัสดุและความแข็งแรง โดยทำ Drop Test ที่ ระดับความสูง 1-2 เมตร เพื่อตรวจสอบว่ากล่อง CanSat ทนต่อแรงกระแทกได้
2 | การทดสอบระบบอิเล็กทรอนิกส์ | - ตรวจสอบระบบพลังงาน ทดสอบว่าแบตเตอรี่จ่ายไฟได้ นานกว่า 3 ชั่วโมง - ทดสอบเซ็นเซอร์และวงจรสื่อสาร โดยให้ CanSat ส่ง ข้อมูลกลับสถานีภาคพื้นผ่าน LoRa Module 915MHz
3 | การทดสอบ Deployment | -ทดสอบระบบร่มชูชีพ (Parachute Test) โดยปล่อยจากที่ สูง อาคาร 3-5 ชั้นเพื่อตรวจสอบการทำงานของระบบลด ความเร็ว และวัดอัตราการตก
4 | การทดสอบ Cansat สามารถทน แรงสั่นสะเทือนจาการปล่อยจรวดได้ | - นำ CANSAT ติดตั้งบนเครื่องสั่นขัดผิวและปรับระดับแรง สั่นตาม กำหนด ทิ้งไว้เป็นระยะเวลา 3 นาทีและสังเกต ความเสียหายที่เกิดขึ้น เริ่มทดสอบจากความแรงต่ำไปสูง
5 | Cansat สามารถทน ความชื้นได้ | - นำ Cansatไปใส่ในกล่องทดลองความชื้นแบบปิด ซึ่งมี เครื่องสร้าง ไอน้ำและเซนเซอร์ตรวจจับความชื้น
6 | Cansat รับแรงกระชาก จากร่มชูชีพได้ | - นำ Cansat ผูกกับเชือกที่ร้อยไว้กับรอกบนเพดาน โดย ปลายเชือก อีกฝั่งผูกก้อนถ่วงน้ำหนัก จากนั้นทดสอบโดย การปล่อยก้อนน้ำหนักให้ ตกอย่างอิสระ เพื่อให้เกิดแรงดึง ในเส้นเชือกไปดึง Cansat
7 | ทดสอบการบรรจุไข่นกกระทา | - นำกล่องที่ได้ติดตั้งระบบกันกระแทกที่บรรจุไข่นกกระทา อยู่ แล้วปล่อยที่ระดับความสูงอาคาร 1 ชั้น
8 | ทดสอบที่อุณหภูมิสูง | - การให้ความร้อน Cansat ด้วย Thermal Chambers แล้วควบคุมอุณหภูมิที่ 50-60 องศาเซลเซียสเพื่อตรวจสอบ ว่าชิ้นส่วนอิเล็กทรอนิกส์ของ Cansat สามารถทำงานได้ อย่างปกติ - ตรวจสอบว่าวัสดุของ Cansat ไม่ละลาย บิดเบี้ยว หรือ ได้รับความเสียหายจากความร้อน

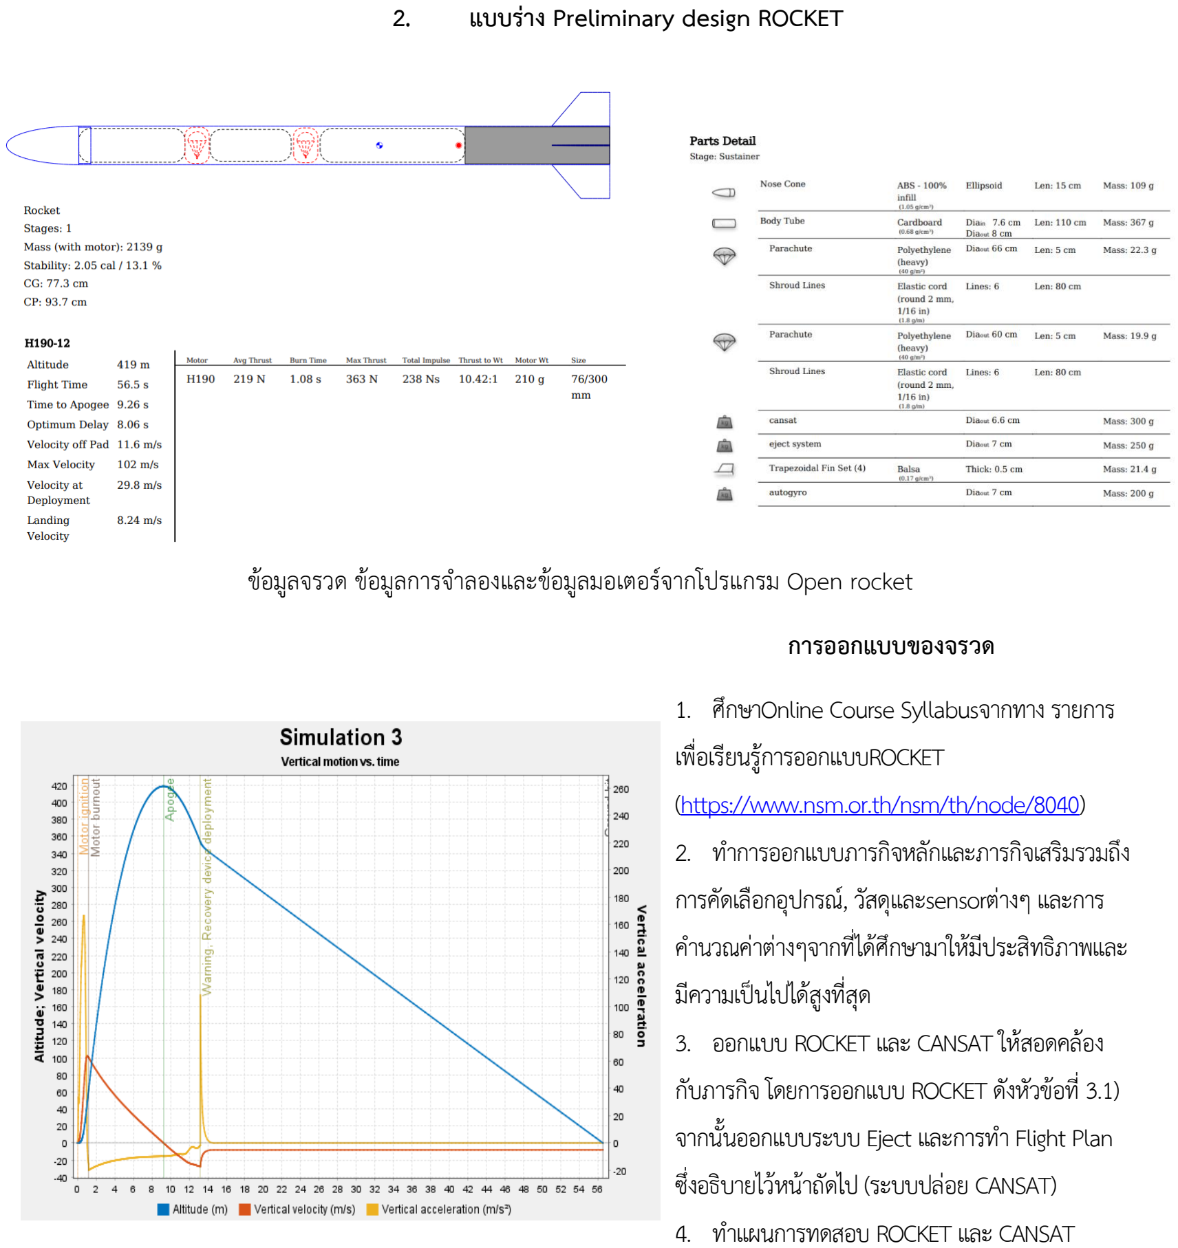
[picture p60: page 6]

### 2. แบบร่าง Preliminary design ROCKET

ข้อมูลจรวด ข้อมูลการจำลองและข้อมูลมอเตอร์จากโปรแกรม Open rocket การออกแบบของจรวด
1. ศึกษาOnline Course Syllabusจากทาง รายการ เพื่อเรียนรู้การออกแบบROCKET (https://www.nsm.or.th/nsm/th/node/8040)
2. ทําการออกแบบภารกิจหลักและภารกิจเสริมรวมถึง การคัดเลือกอุปกรณ์, วัสดุและsensorต่างๆ และการ คํานวณค่าต่างๆจากที่ได้ศึกษามาให้มีประสิทธิภาพและ มีความเป็นไปได้สูงที่สุด
3. ออกแบบ ROCKET และ CANSAT ให้สอดคล้อง กับภารกิจ โดยการออกแบบ ROCKET ดังหัวข้อที่ 3.1) จากนั้นออกแบบระบบ Eject และการทํา Flight Plan ซึ่งอธิบายไว้หน้าถัดไป (ระบบปล่อย CANSAT)
4. ทําแผนการทดสอบ ROCKET และ CANSAT

### 3. ขั้นตอน และแนวความคิดในการออกแบบ ROCKET รวมถึงแผนงานในการสร้างและทดสอบ ROCKET

### 3.1. Rocket

1. Nose Cone ใช้ทรง Ellipsoid เนื่องจากมี สัมประสิทธิ์แรงต้าน (Drag coefficient) ที่ต่ำที่สุดคือ 0.68 ซึ่ง ช่วยลดแรงต้านอากาศที่เกิดขึ้นระหว่างการบินและทำให้จรวดสามารถบินได้อย่างมีประสิทธิภาพมากขึ้น 2.Parachute ใช้รูปทรง Round Parachute ซึ่งช่วยเพิ่มเวลาในการตกและเพิ่มความปลอดภัยทั้งสำหรับ ROCKET และ CANSAT ขนาดเส้นผ่านศูนย์กลางของ Parachute ของ ROCKET คือ 60 cm โดยคำนวณตาม ขนาดของภารกิจหลักเพื่อให้การเปิดพาราชูตมีประสิทธิภาพ การพับ Parachute จะพับให้เป็นระเบียบเพื่อ ป้องกันสายพันกันและให้การปล่อยพาราชูตเป็นไปอย่างราบรื่น
3. Fin ใช้รูปทรง Trapezoidal Fin จำนวน 4 ชิ้น ช่วยเพิ่มเสถียรภาพในการบินของจรวด ลดการหมุนหรือการ เสียสมดุลขณะบิน ช่วยให้จรวดบินไปในทิศทางที่ต้องการได้อย่างมีประสิทธิภาพ

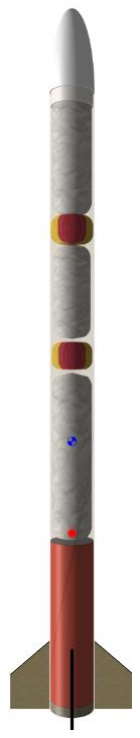
[picture p61: figure]

### 3.2. แผนการทดสอบROCKET

การทดสอบที่ | เป้าหมายการทดสอบ | วิธีการทดสอบ
1 | Swing Test | นำ ROCKET มาทำการทดสอบ Swing Test เพื่อสังเกต เสถียรภาพและการส่ายของหัวจรวด โดยมีขั้นตอนคือ ผูก เชือกยาวประมาณ 2 เมตรที่จุด CG จากนั้นเหวี่ยงจรวด เชือกจะต้องทำให้จรวดเคลื่อนที่ไปข้างหน้าอย่างเสถียร โดย ที่หัวจรวดต้องไปข้างหน้าอย่างมั่นคง
2 | การตกถึงพื้นของ ROCKET | ปล่อย Parachute ที่ติดกับมวลถ่วงน้ำหนักจากความสูง 10 เมตร และอัดคลิปวิดีโอ จากนั้นใช้โปรแกรม Tracker เพื่อ ติดตามการตก (track) หาความเร็วและความเร่งขณะตกลง มา
3 | Autogyro Free-drop test | ปล่อย Autogyro จากความสูง 10 เมตร และอัดคลิปวิดีโอ จากนั้นใช้โปรแกรม Tracker เพื่อ ติดตามการตก (track) หาความเร็วและความเร่งขณะตกลง มา

### 4. ระบบปล่อย CANSAT ออกจากจรวด (Deployment system)

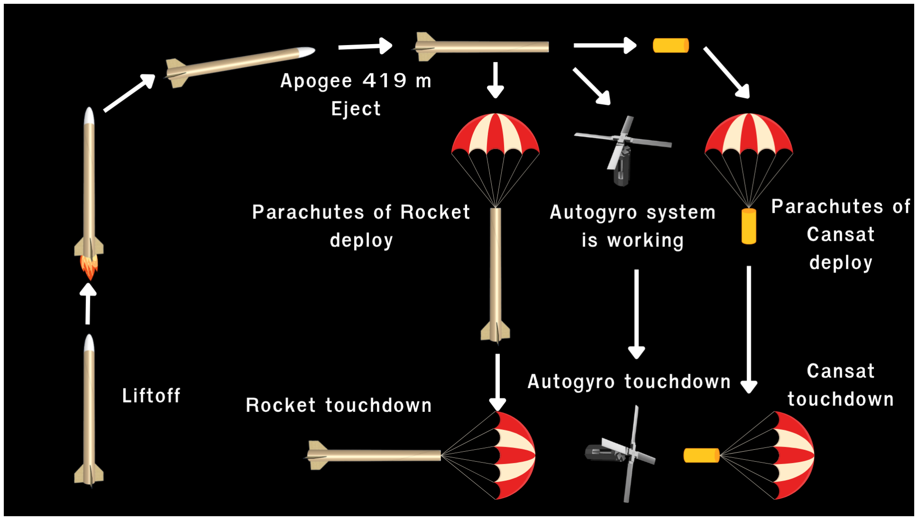
[picture p62: figure]

ระบบ Eject ใช้ระบบ Piston พร้อมสายยางดึง ในการขับเคลื่อน Cansat เพื่อดีดออก โดยในระหว่างที่ Rocket มีความสูงที่ ลดลง ระบบจะทำการสั่งให้ Servo motor ปลดสลักเชิงกล เพื่อปล่อยลูกสูบที่ถูกดึงรั้งไว้ภายใต้ความตึงของสายยาง ทำให้ ลูกสูบดีดตัวขึ้นอย่างรวดเร็ว และดันให้ Cansat ถูกขับออกจาก Rocket ในทันที

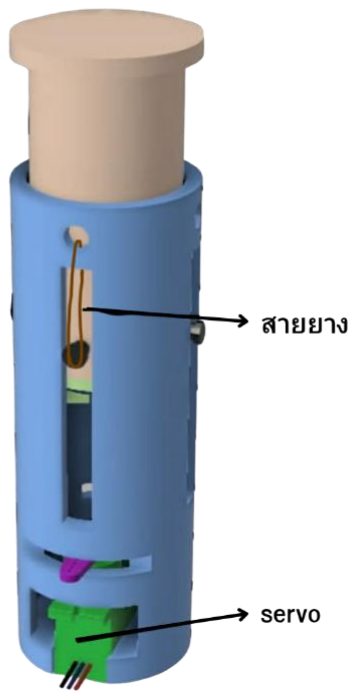
[picture p63: figure]

การควบคุมระบบ Eject ควบคุมการทำงานด้วย Arduino Nano และใช้เซ็นเซอร์ MS5611 ในการตรวจสอบความสูง เมื่อ ความสูงมีระดับลดลง จะสั่งให้ Servo motor ทำการหมุนเพื่อปลดล็อคสลักกลไกตามที่อธิบายไว้ข้างต้น
ระบบสำรอง ใช้ระบบสำรองที่ทางผู้จัดการแข่งขันจัดเตรียมไว้ให้ เพื่อความปลอดภัยและเพิ่มโอกาสความสำเร็จของภารกิจ

อุปกรณ์ที่ใช้
1.Servo motor 1 ตัว
2.สายยาง สำหรับดึงลูกสูบ
3.ตะปู
4.ชุดลูกสูบและกระบอกสูบ (โครงสร้าง 3D printed จากพลาสติก ABS)
