DraSoGo/Cansat_Duck2Dragon/Data/log_vibration_test1.csv

millis | lat | lon | alt_gps | sats | alt_baro | temp | pressure | ax | ay | az | gx | gy | gz | qw | qx | qy | qz | high_ax | high_ay | high_az | voltage | current | time_s | accel_mag | alt_smooth | vz
47271 | 0.0 | 0.0 | 0.0 | 0 | 48.65 | 32.41 | 1007.42 | 0.0 | 0.0 | 0.0 | 0.0371 | 0.0391 | -0.0059 | 1.0 | 0.0 | 0.0 | 0.0 | 0.0 | 0.0 | 0.0 | 3.544 |  | 47.271 | 0.0
48098 | 0.0 | 0.0 | 0.0 | 0 | 48.32 | 32.41 | 1007.46 | -1.0977 | 0.2539 | -0.0664 | 0.0 | 0.0 | 0.0 | 1.0 | 0.0 | 0.0 | 0.0 | 0.0 | 0.0 | 0.0 | 3.54 |  | 48.098 | 1.1286361061032912
48942 | 0.0 | 0.0 | 0.0 | 0 | 48.32 | 32.41 | 1007.46 | 0.0 | 0.0 | 0.0 | 0.0039 | -0.0195 | -0.0098 | 1.0 | 0.0 | 0.0 | 0.0 | 0.0 | 0.0 | 0.0 | 3.548 |  | 48.942 | 0.0 | 48.418
49770 | 0.0 | 0.0 | 0.0 | 0 | 48.32 | 32.42 | 1007.46 | -1.0352 | 0.7969 | -0.0664 | 0.0 | 0.0 | 0.0 | 1.0 | 0.0 | 0.0 | 0.0 | 0.0 | 0.0 | 0.0 | 3.548 |  | 49.77 | 1.3080892974105398 | 48.318 | -0.12077294685990467
50595 | 0.0 | 0.0 | 0.0 | 0 | 48.48 | 32.42 | 1007.44 | 0.0 | 0.0 | 0.0 | -0.0059 | -0.0293 | -0.0137 | 1.0 | 0.0 | 0.0 | 0.0 | 0.0 | 0.0 | 0.0 | 3.56 |  | 50.595 | 0.0 | 48.284 | -0.04121212121212012
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
