DraSoGo/Cansat_Duck2Dragon/Data/log_vibration_test2.csv

millis | lat | lon | alt_gps | sats | alt_baro | temp | pressure | ax | ay | az | gx | gy | gz | qw | qx | qy | qz | high_ax | high_ay | high_az | voltage | current | time_s | accel_mag | alt_smooth | vz
324091 | 8.375336 | 100.080513 | -557.6 | 5 | 40.96 | 32.81 | 1008.34 | 0.0 | 0.0 | 0.0 | -0.0117 | 0.0059 | 0.0 | 1.0 | 0.0 | 0.0 | 0.0 | 0.0 | 0.0 | 0.0 | 3.436 |  | 324.091 | 0.0
324942 | 8.375336 | 100.080513 | -557.6 | 5 | 40.63 | 32.81 | 1008.38 | -2.3594 | 0.9023 | -0.0586 | 0.0 | 0.0 | 0.0 | 1.0 | 0.0 | 0.0 | 0.0 | 0.0 | 0.0 | 0.0 | 3.428 |  | 324.942 | 2.5267266591382613
325812 | 8.375336 | 100.080513 | -557.6 | 5 | 40.96 | 32.8 | 1008.34 | 0.0 | 0.0 | 0.0 | 0.0352 | -0.0781 | -0.0117 | 1.0 | 0.0 | 0.0 | 0.0 | 0.0 | 0.0 | 0.0 | 3.436 |  | 325.812 | 0.0 | 41.094
326666 | 8.375336 | 100.080513 | -557.6 | 5 | 42.13 | 32.79 | 1008.2 | 4.9062 | -0.6523 | 0.0977 | 0.0 | 0.0 | 0.0 | 1.0 | 0.0 | 0.0 | 0.0 | 0.0 | 0.0 | 0.0 | 3.436 |  | 326.666 | 4.9503372632579286 | 40.926 | -0.19672131147541244
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
