DraSoGo/Cansat_Duck2Dragon/Data/log_vibration_test3.csv

millis | lat | lon | alt_gps | sats | alt_baro | temp | pressure | ax | ay | az | gx | gy | gz | qw | qx | qy | qz | high_ax | high_ay | high_az | voltage | current | time_s | accel_mag | alt_smooth | vz
1618633 | 8.3675 | 100.043922 | -1.8 | 12 | 43.3 | 30.22 | 1008.06 | 0.0 | 0.0 | 0.0 | 0.0 | 0.0 | 0.002 | 1.0 | 0.0 | 0.0 | 0.0 | 0.0 | 0.0 | 0.0 | 3.164 |  | 1618.633 | 0.0
1619503 | 8.3675 | 100.043922 | -1.8 | 12 | 43.63 | 30.22 | 1008.02 | 0.0 | 0.0 | 0.0 | -0.0039 | 0.0039 | 0.0039 | 1.0 | 0.0 | 0.0 | 0.0 | 0.0 | 0.0 | 0.0 | 3.16 |  | 1619.503 | 0.0
1620355 | 8.3675 | 100.043922 | -1.8 | 12 | 43.97 | 30.22 | 1007.98 | 0.5156 | -0.8555 | 0.0742 | 0.0 | 0.0 | 0.0 | 1.0 | 0.0 | 0.0 | 0.0 | 0.0 | 0.0 | 0.0 | 3.164 |  | 1620.355 | 1.0016133235934914 | 43.534
1621225 | 8.367499 | 100.043922 | -3.4 | 12 | 43.47 | 30.22 | 1008.04 | 0.0078 | 1.5117 | -0.2031 | 0.0 | 0.0 | 0.0 | 1.0 | 0.0 | 0.0 | 0.0 | 0.0 | 0.0 | 0.0 | 3.16 |  | 1621.225 | 1.5253023765798046 | 43.534000000000006 | 8.167157882301027e-15
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
