DraSoGo/Cansat_Duck2Dragon/Test/thermal_test_01.jpeg

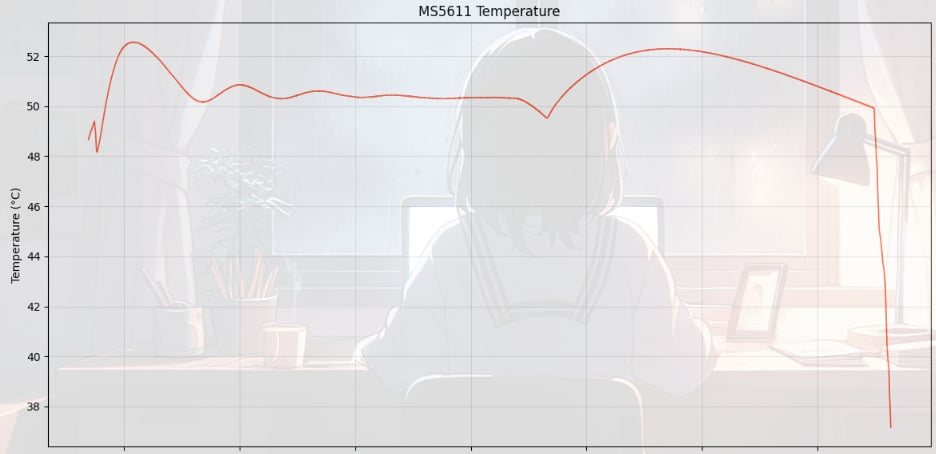
Test/thermal_test_01.jpeg
