DraSoGo/Cansat_Duck2Dragon/Test/thermal_test_02.jpeg

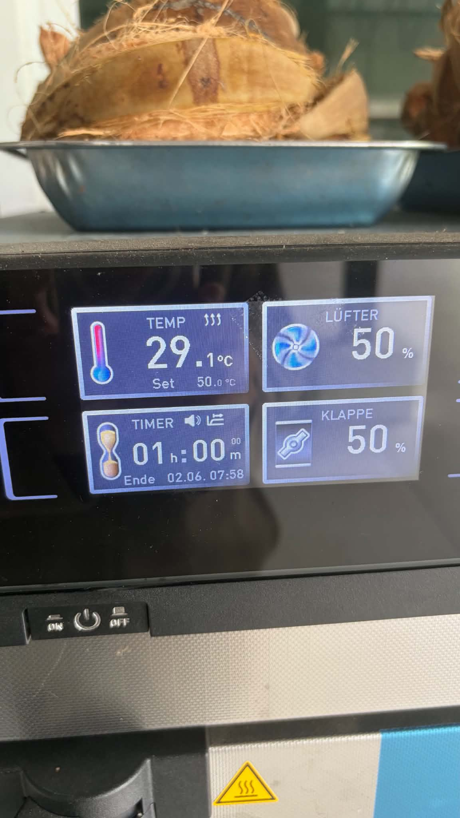
Test/thermal_test_02.jpeg
