DraSoGo/Cansat_Duck2Dragon/Present/Pre-Duck2Dragon.pdf

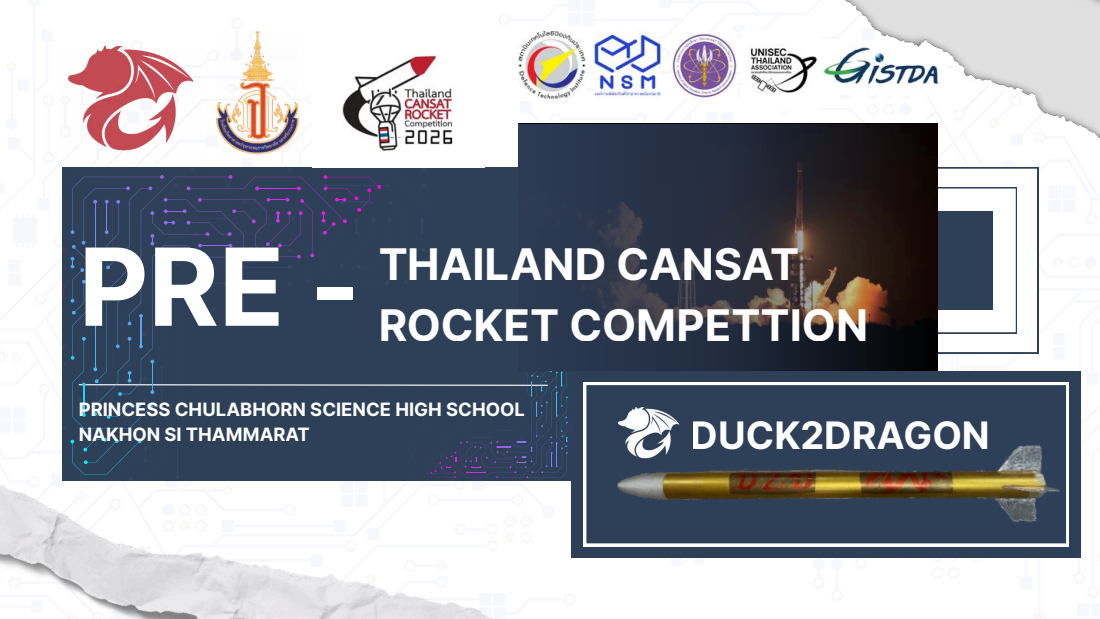
[picture p66: page 1]
DUCK2DRAGON

THAILAND CANSAT PRE - ROCKET COMPETTION

PRINCESS CHULABHORN SCIENCE HIGH SCHOOL
NAKHON SI THAMMARAT

# Meet Our Team

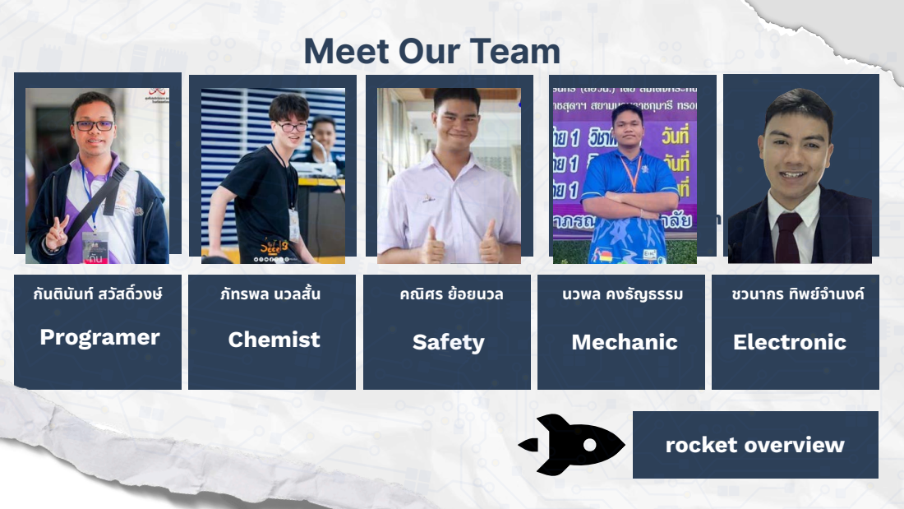
[picture p67: page 2]
วงษ์; ภัทรพล นวลสัน; คณิศร ย้อยนวล; นวพล คงธัญธรรม; ชวนากร ทิพย์จํานงค์; Programer; Chemist; Safety; Mechanic; Electronic; rocket overview

About Our Team

# Rocket Overview

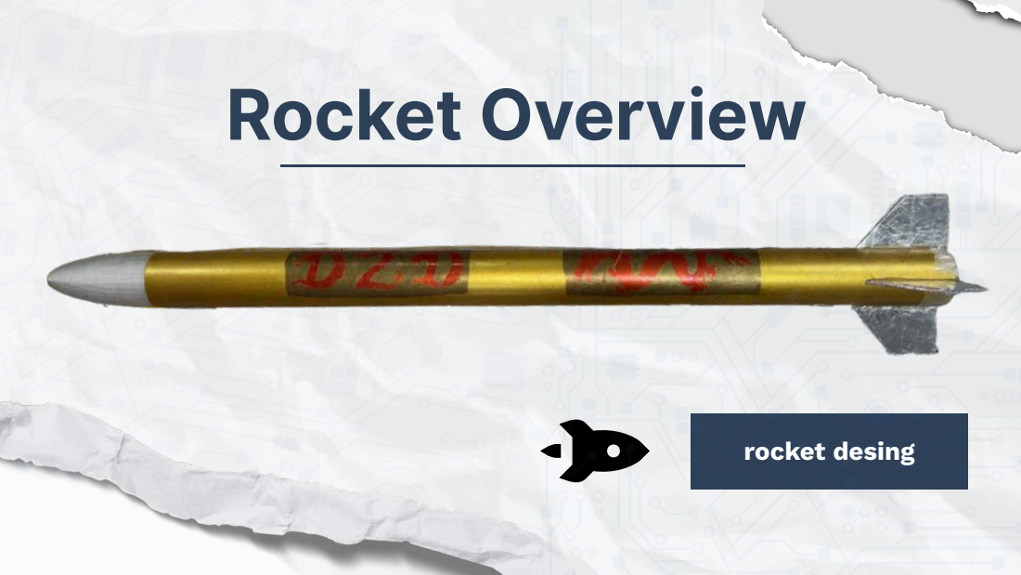
[picture p68: page 3]
rocket desing

# ROCKET DESING

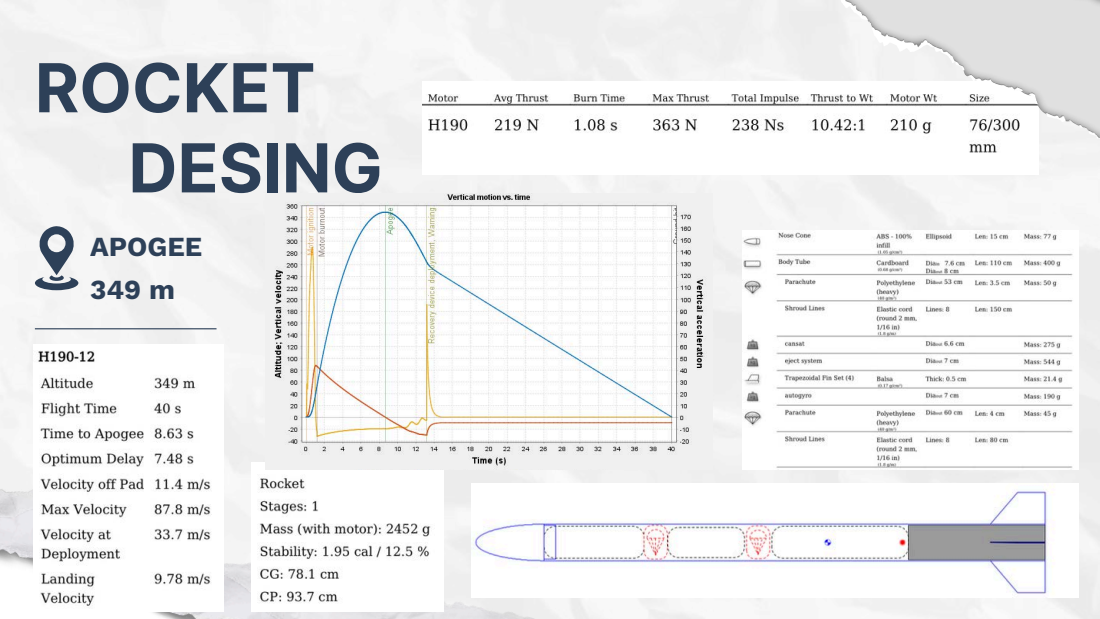
[picture p69: page 4]
APOGEE 349 m

# Rocket test Swing test

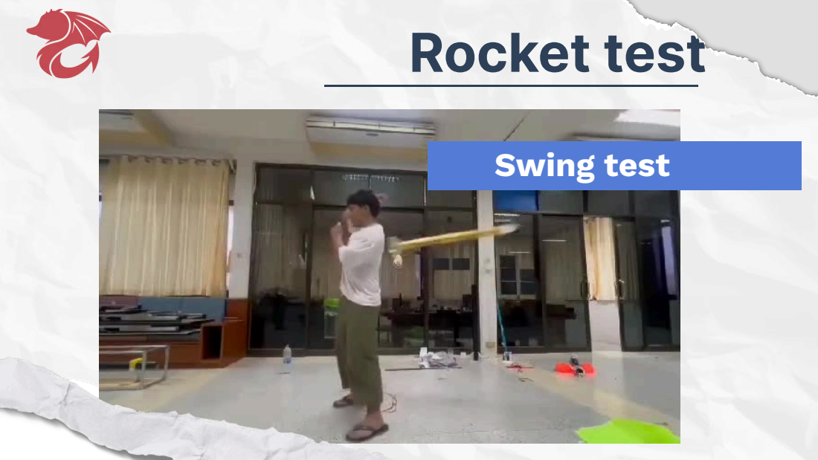
[picture p70: page 5]

## Rocket test Drop test (parachute) v = 9.66 m/s

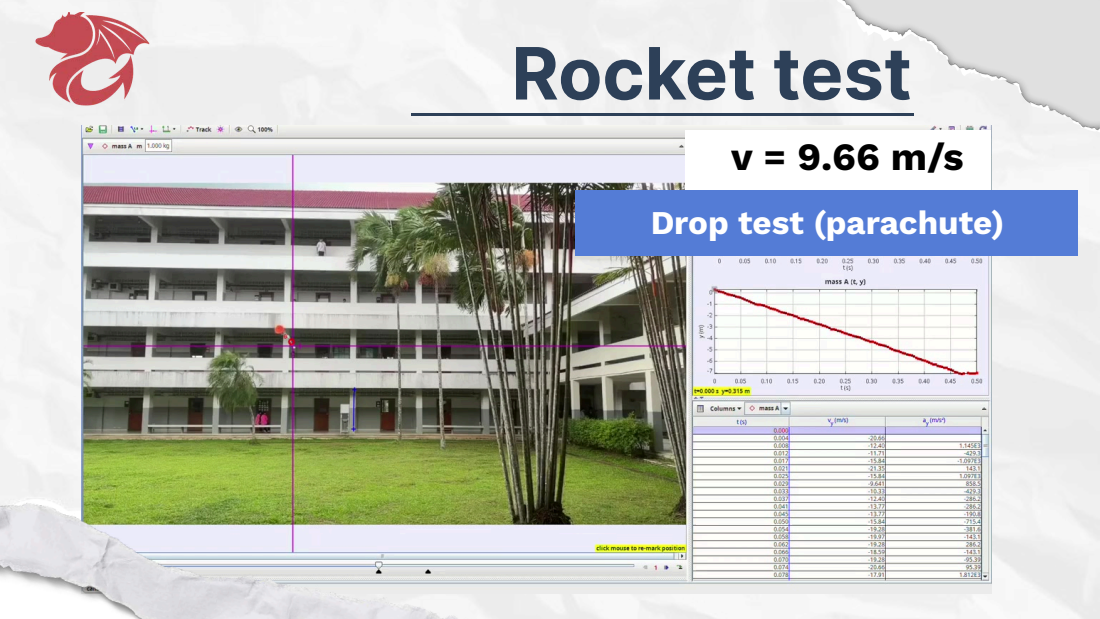
[picture p71: page 6]

# Cansat Overview

# เคลือบบอร์ดด้วย

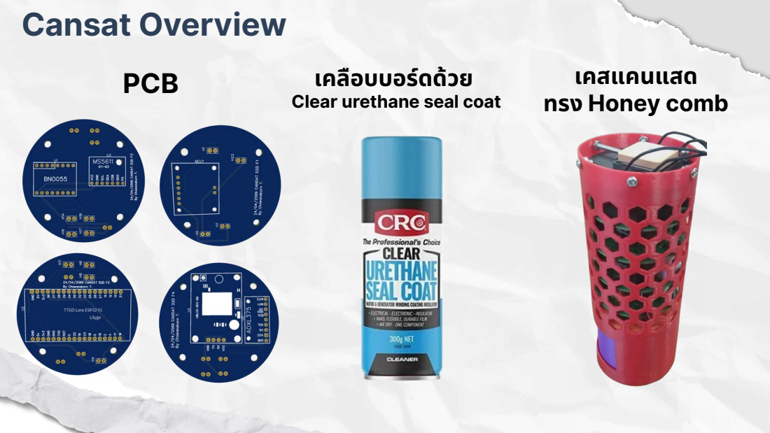
[picture p72: page 7]
Contact; PCB; เคสแคนแสด

Clear urethane seal coat

ทรง Honey comb

# Cansat Overview

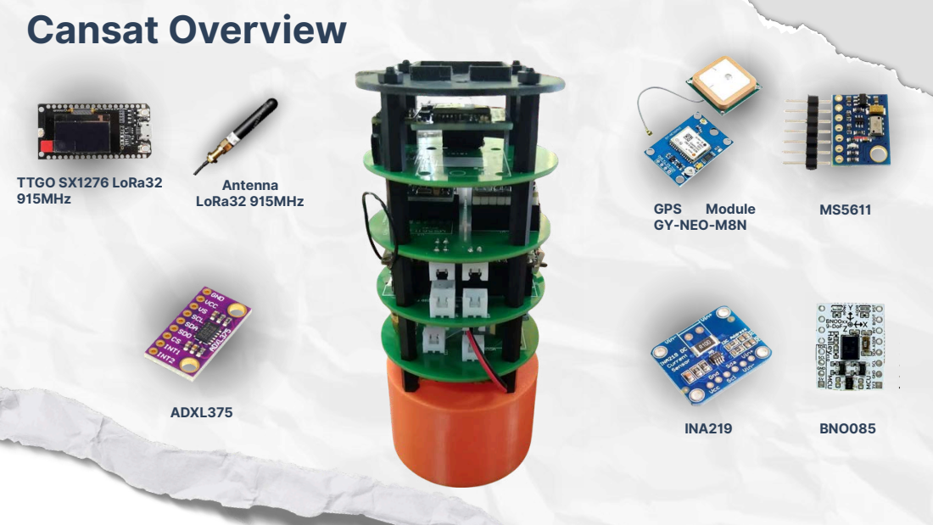
[picture p73: page 8]
Contact; TTGO SX1276 LoRa32 915MHz; Antenna LoRa32 915MHz; ADXL375; GPS; Module; GY-NEO-M8N; INA219; BNO085

# Main mission

01

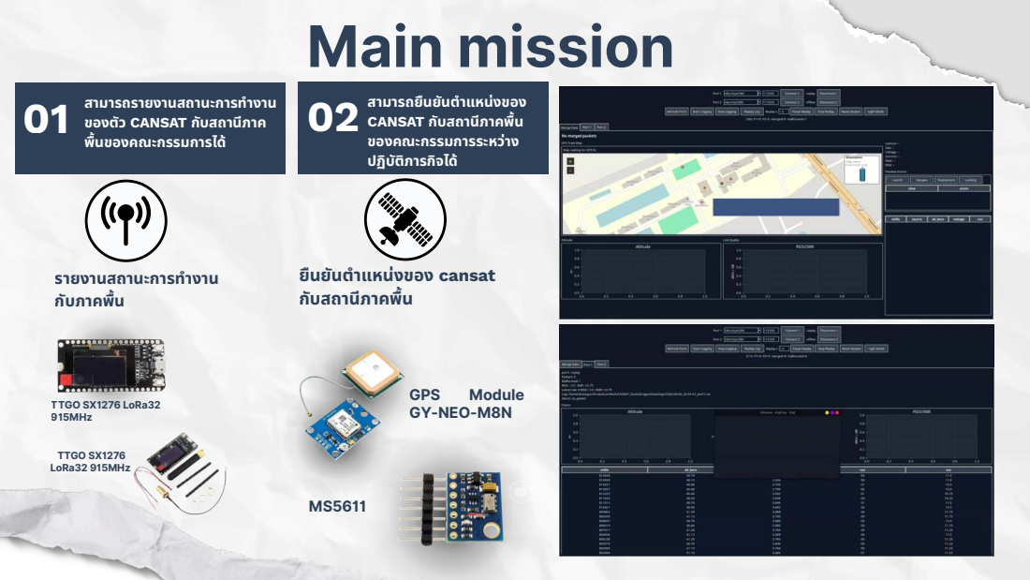
[picture p74: page 9]
รายงานสถานะการทํางาน กับภาคพืน; TTGO SX1276 LoRa32 915MHz; GPS; Module; GY-NEO-M8N

สามารถรายงานสถานะการทํางาน
ของตัว CANSAT กับสถานีภาค
พื้นของคณะกรรมการได้

สามารถยืนยันตําแหน่งของ
CANSAT กับสถานีภาคพื้น
ของคณะกรรมการระหว่าง
ปฏิบัติภารกิจได้

ยืนยันตำแหน่งของ cansat
กับสถานีภาคพืน

# Main mission 6.2 cm

03

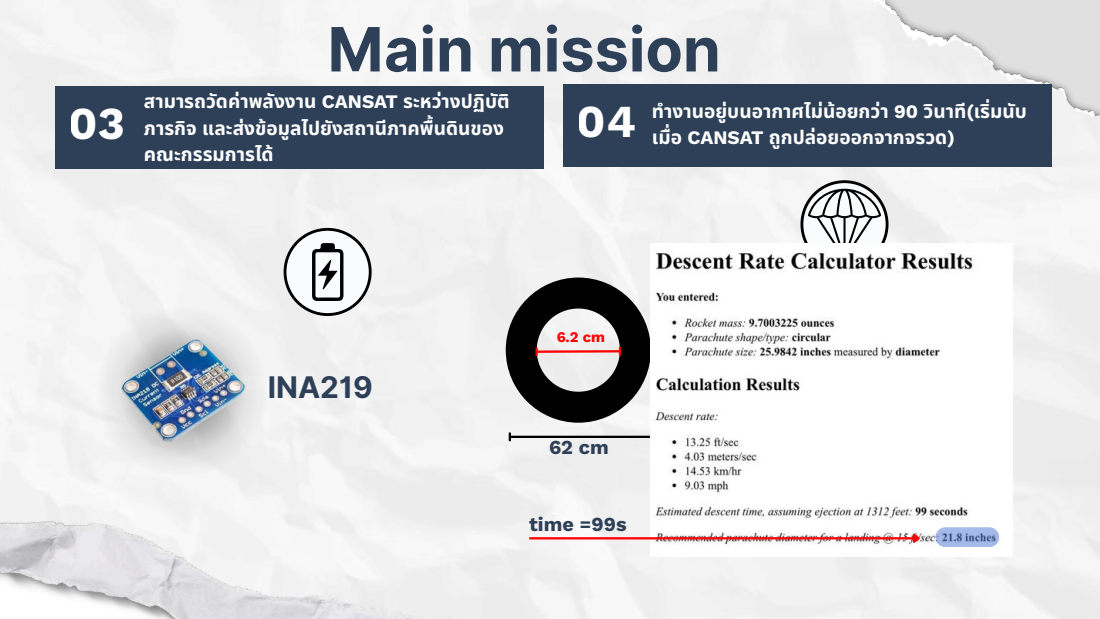
[picture p75: page 10]
INA219; time =99s

สามารถวัดค่าพลังงาน CANSAT ระหว่างปฏิบัติ
ภารกิจ และส่งข้อมูลไปยังสถานีภาคพื้นดินของ
คณะกรรมการได้

ทํางานอยู่บนอากาศไม่น้อยกว่า 90 วินาที(เริ่ม
เมื่อ CANSAT ถูกปล่อยออกจากจรวด)

บรรจุไข่โดยมีอ

มี ย่างน้อย 1 ฟอง

06
อยู่ในสภาพสมบูรณ์หลังลงจอด

# Main mission

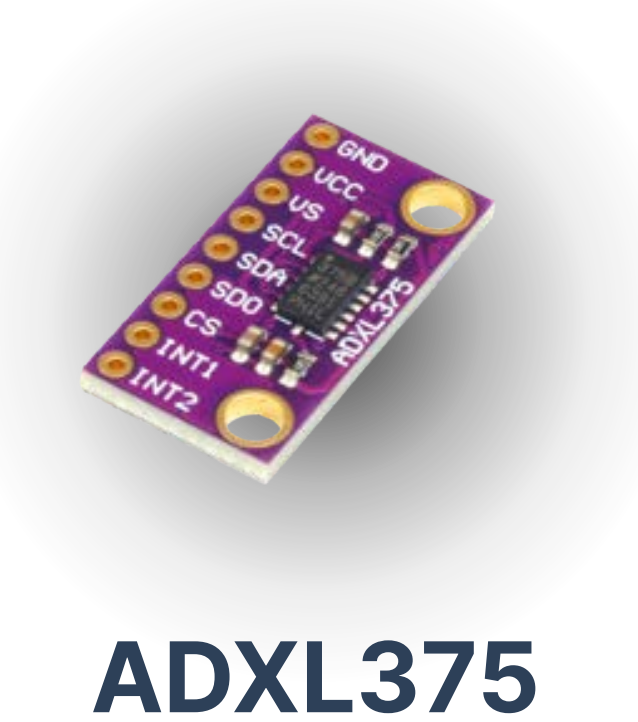
[picture p76: figure]
ADXL375

กรอบนอกทำจาก HDPE ฐานด้านล่างถูก ออกแบบให้เป็นโครงสร้างแบบ Hexagonal เพื่อรับแรงกระแทก และมี air bubble กัน กระแทกอีกชนั นึง

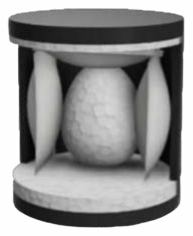
[picture p77: figure]
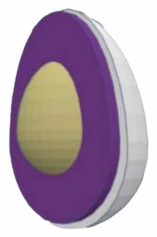
[picture p78: figure]

ชน

ั ด้านในทําจากวัสดุ TPU และบรรจุ ภายในด้วยโฟม EVA เพือดูดซับ แรงกระแทกก่อนถึงตัวไข่นกกระทา

05
วัดความเร่งขณะขึนและลงจอดได้

# Cansat Test

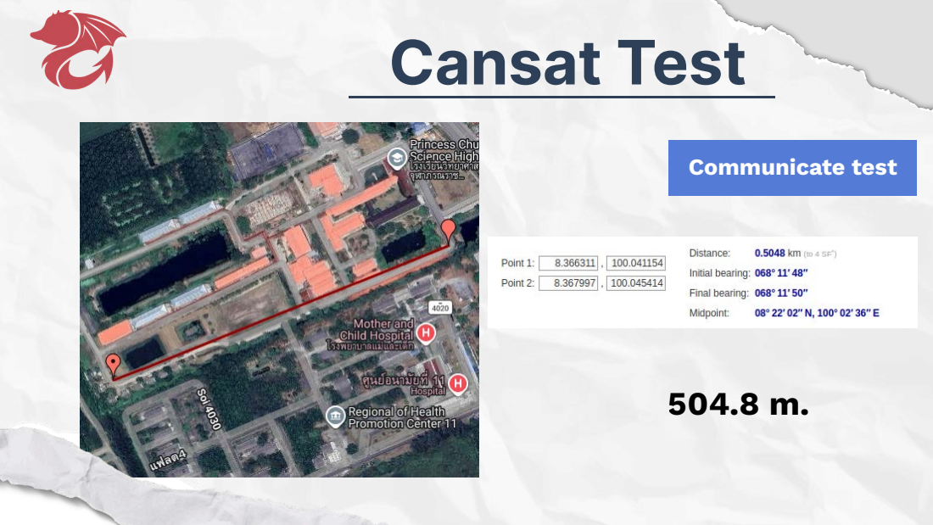
[picture p79: page 12]
Communicate test

# Cansat Test

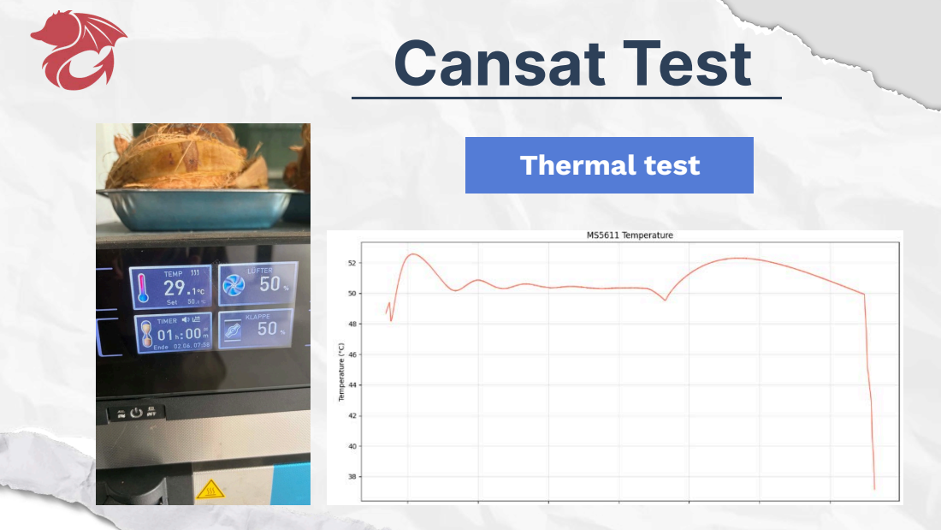
[picture p80: page 13]
Thermal test

# Cansat Test

# orbital shaker

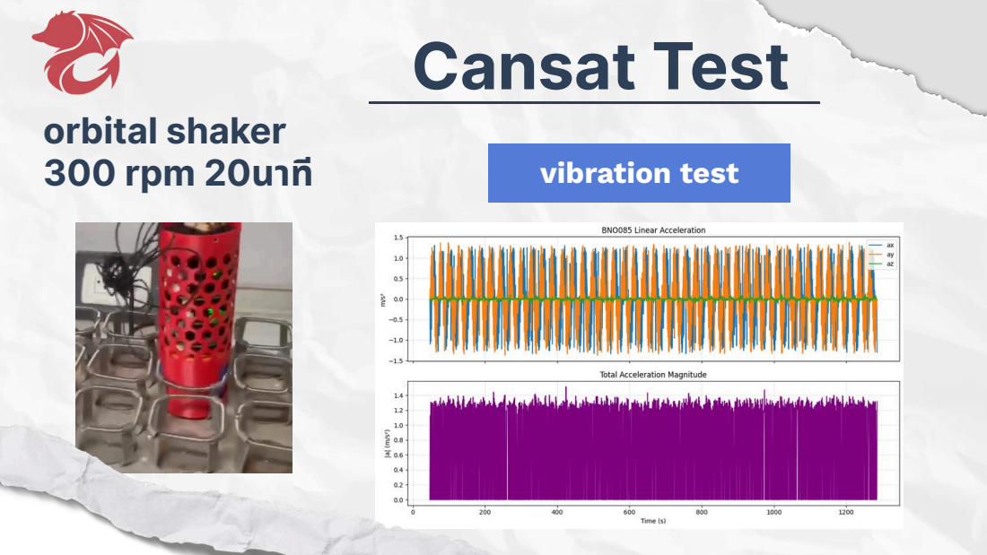
[picture p81: page 14]
vibration test; 300 rpm 20นาท

## Drop test (parachute) Cansat Test v = 7.51 m/s

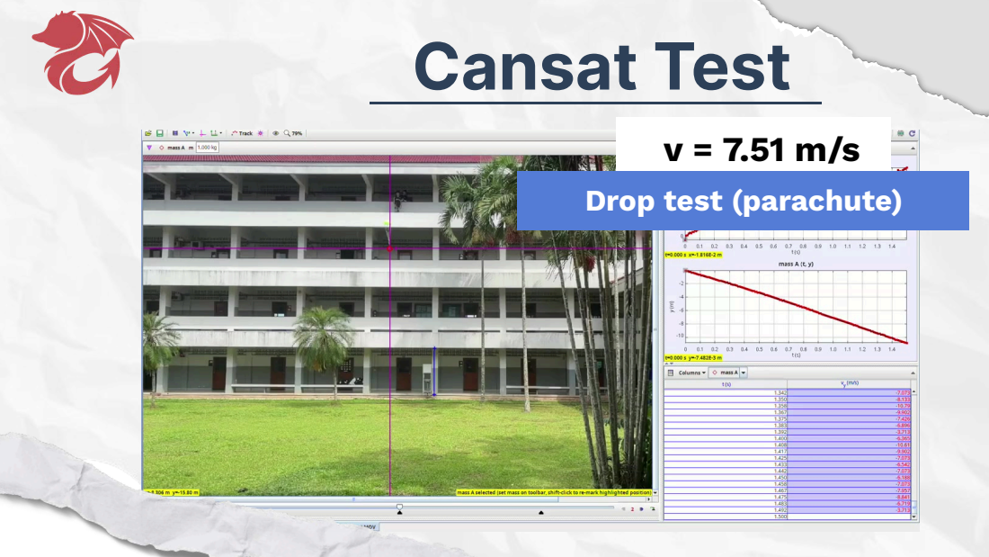
[picture p82: page 15]

# Cansat Test

## a = 123.4 m/s

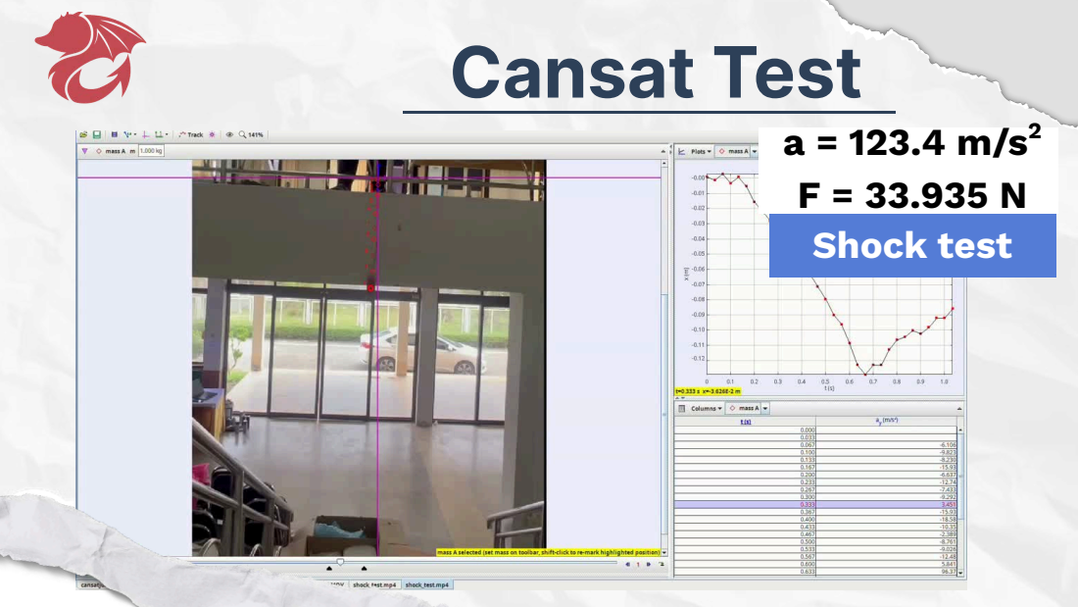
[picture p83: page 16]
Shock test

# Cansat Test

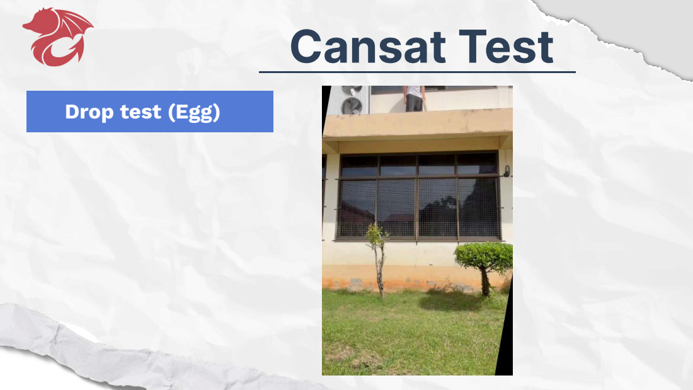
[picture p84: page 17]

Drop test (Egg)

# Cansat Price 3935.07 บาท

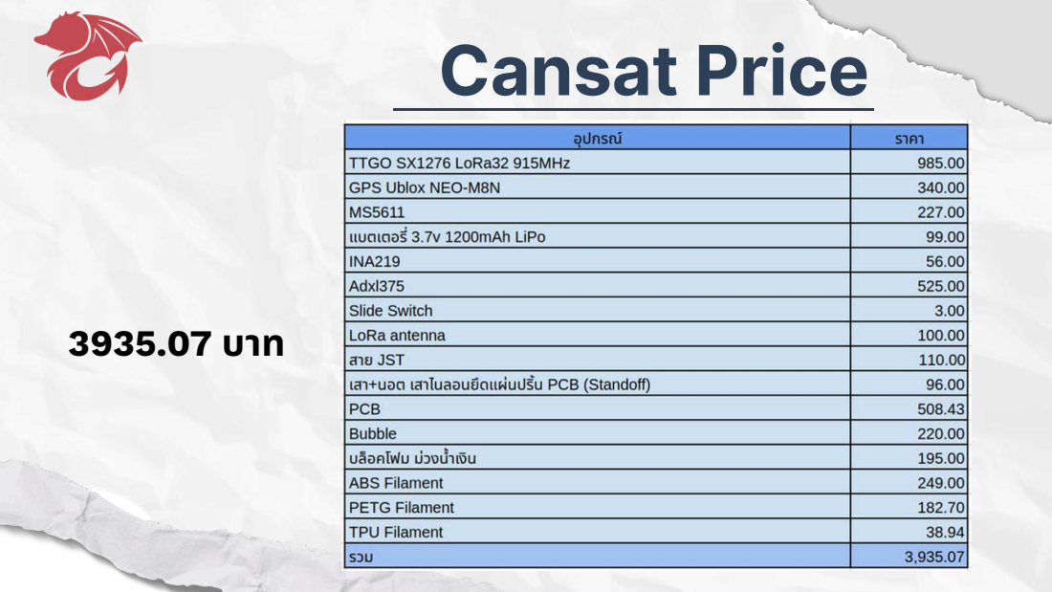
[picture p85: page 18]

# Eject System 9

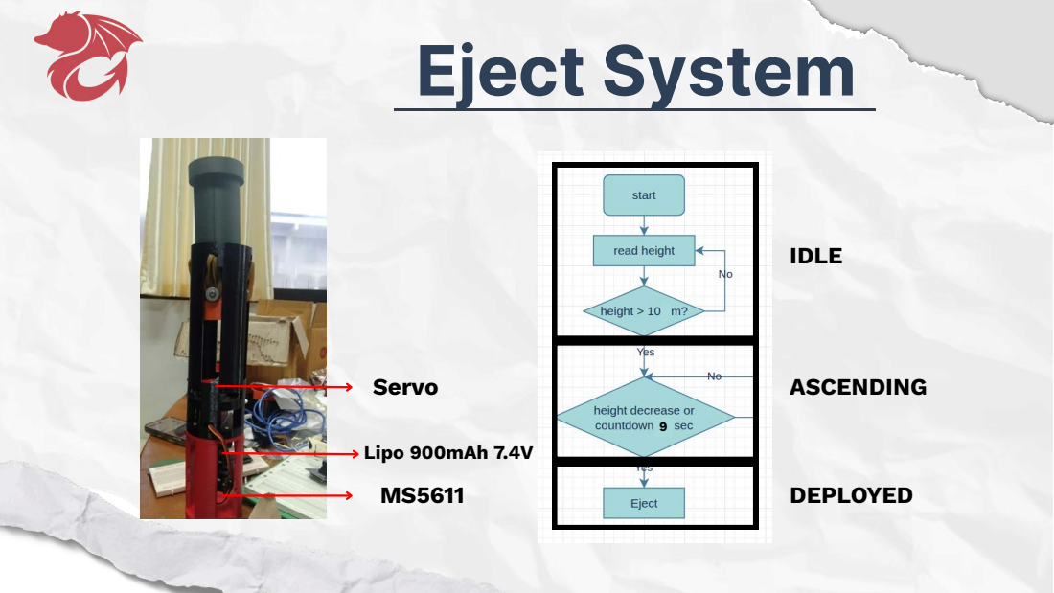
[picture p86: page 19]
ASCENDING; DEPLOYED; Servo; IDLE; Lipo 900mAh 7.4V

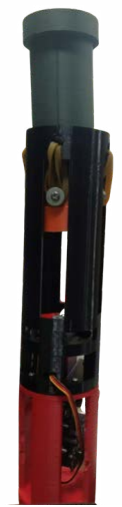
[picture p87: figure]

# Eject System

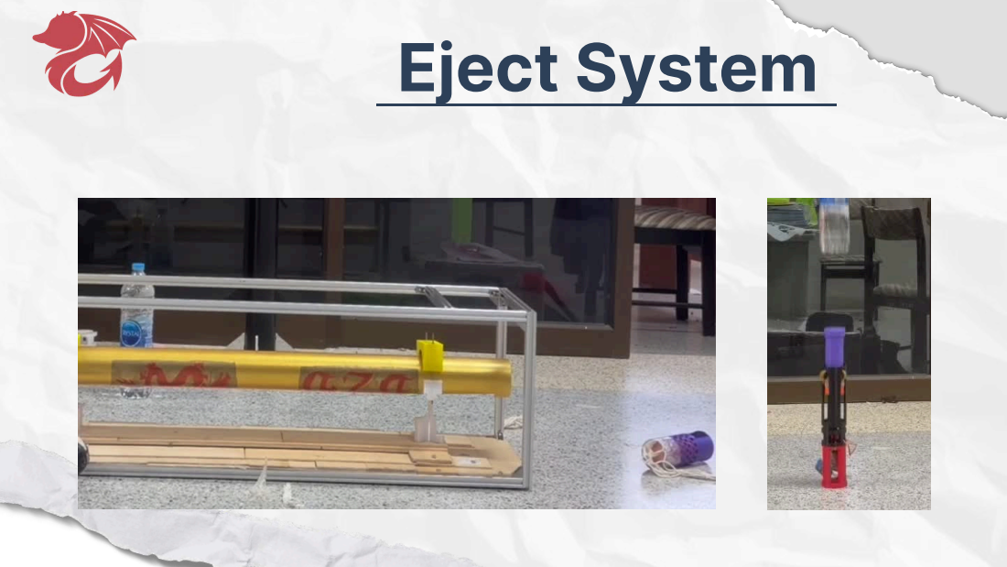
[picture p88: page 21]

# SUB MISSION

## Autogyro

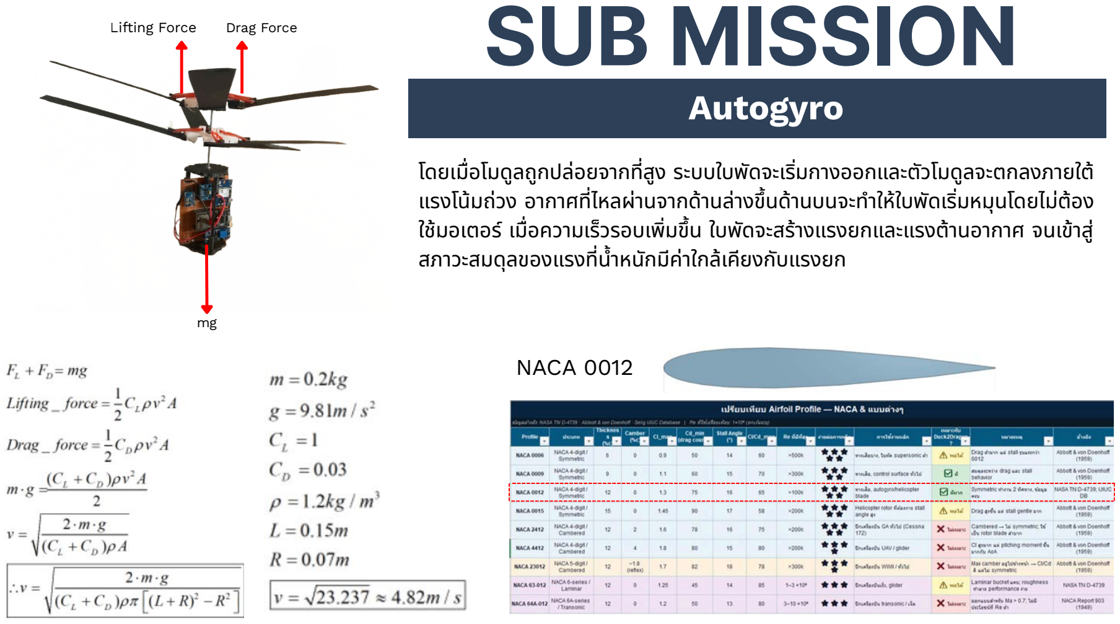
[picture p89: page 22]

NACA 0012 โดยเมือโมดูลถูกปล่อยจากทีสูง ระบบใบพัดจะเริมกางออกและ
| ตัวโมดูลจะตกลงภายใต้
แรงโน้มถ่วง อากาศทีไหลผ่านจากด้านล่างขึนด้านบนจะทําให้ใบพัดเริมห

มุนโดยไม่ต้อง
ใชมอเตอ

้ ร์เมือความเร็วรอบเพิม

ขึน ใบพัดจะสร้างแรงยกและแรงต้านอากาศ จนเข้าสู่ สภาวะสมดุลของแรงทีนําหนักมีค่าใกล้เคียงกับแรงยก

Lifting Force Drag Force mg

# SUB MISSION

## Autogyro

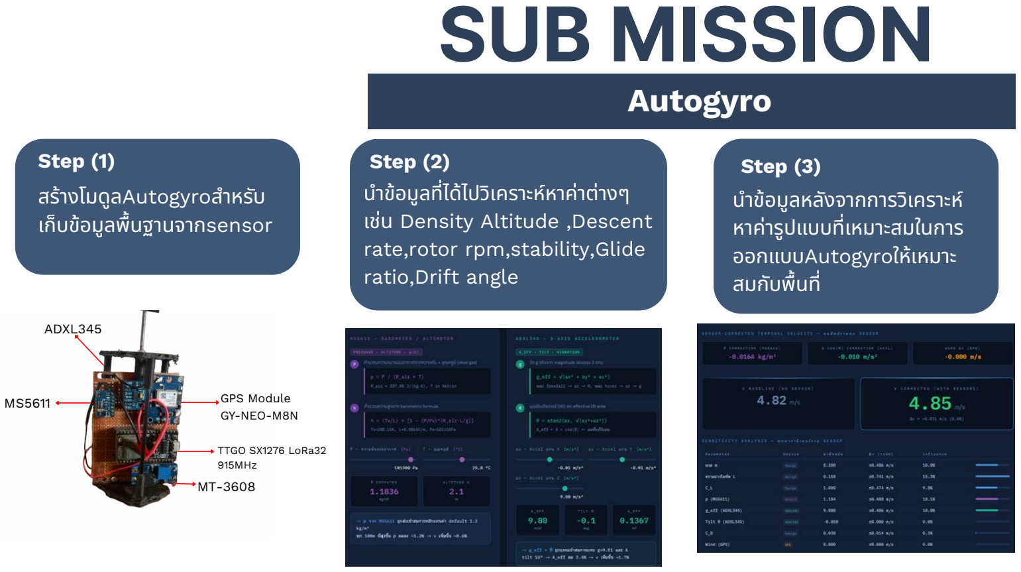
[picture p90: page 23]

ADXL345 | GPS Module

GY-NEO-M8N

MS5611 | TTGO SX1276 LoRa32

915MHz
MT-3608

Step (1

) | Step (2
) | Step (3
)
สร้างโมดู

ลAutogyroสำ

หรับ
เก็

บข้

อมู

ลพืนฐานจากsensor

นําข้

อมู

ลที
ได้ไปวิเคราะห์หาค่

าต่างๆ
เ

ช

น
่ Density Altitude ,Descent rate,rotor rpm,stability,Glide ratio,Drift angle

นำข้

อมูลหลังจากการวิเคราะห์
หาค่

ารูปแบบที่เหมาะสมในการ
ออกแบบAutogyro

ให้เหมาะ
สมกั

บพื

นที

# SUB MISSION

การศึกษาค่าคงท

ี
การสลายตัวของวิตามินซีต่อตัวแปร อุณหภูมิความเร่งเฉล

ี
ยรวม
เพื่อสร้างสมการ Mutiple regression ในการทํานาย
Step 1
Data Collection
(เก็บข้อมูลดิบจาก 2 ตัวแปร)

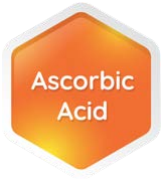
[picture p91: figure]

อุณหภูมิ | ความเร่งเฉล ี ยรวม

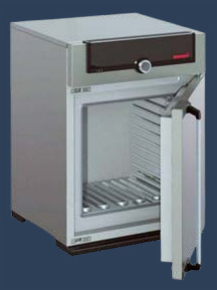
[picture p92: figure]

ทำการทดลอง จํานวน3ชุดการทดลอง ที่อุณหภูมิ 30 50 75 องศาเซลเซยสี

ทำการทดลอง จํานวน4ชุดการทดลอง
(ค่าท

ีได้น

ีวัดจากเซนเซอร์)

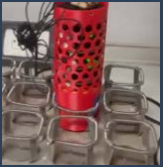
[picture p93: figure]

คำนวณจาก ค่าความเร่งเฉลี่ย (RMS Acceleration) ใน 3 แกน ที่ บันทึกได้จากเซนเซอร์วัดความเร่ง ตลอดช่วงเวลาทดลอง
ช่

# SUB MISSION

การศึกษาค่าคงที่การสลายตัวของวิตามินซี ต่อตัวแปร อุณหภูมิความเร่งเฉลี่ยรวม เพื่อสร้างสมการ Mutiple regression ในการทํานาย

Step 2
Kinetic Calculation
(คำนวณหาค่าคงท

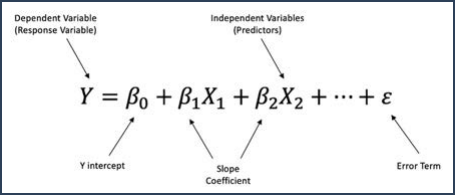
[picture p94: figure]

ีอัตรา k)

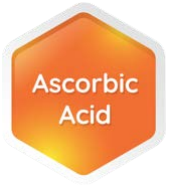
[picture p95: figure]

Step 3
Multiple Regression
(สร้างสมการพยากรณ์)
Step 4
Model Validation
(ทดสอบความแม่นยำของ
สมการในสถานการณ์จริง)

คำนวนค่าคงที่การสลายตัว
ด้วยกฏอัตราอินทิเกรต
อันดับ1

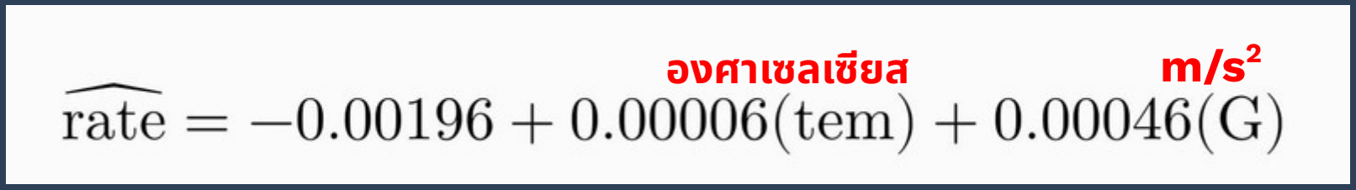
[picture p96: figure]
องศาเซลเซียสซี
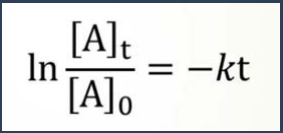
[picture p97: figure]

นําค่า k จากทุกชุดการทดลองเข้าสู่ระบบสถิติMultiple Linear Regression (MLR) เพือสร้างสมการทางคณิตศาสตร์และวิเคราะห์ อิทธิพล (Weight) ของตัวแปรต้นแต่ละตัวท

ี
มต่ ี
อการสลายตัว

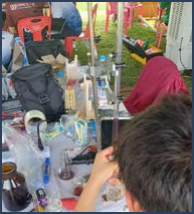
[picture p98: figure]

12 มิ | ถุนายน m/s²

# FLIGHT PLAN

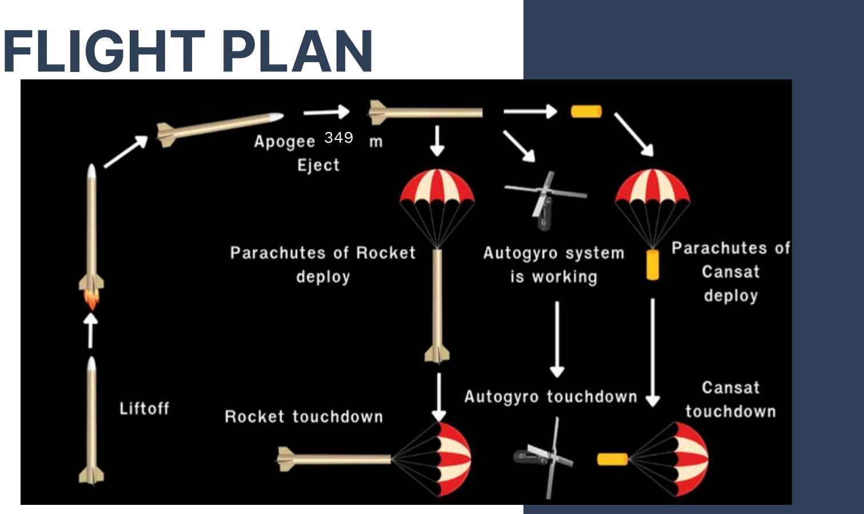
[picture p99: page 26]

32

349

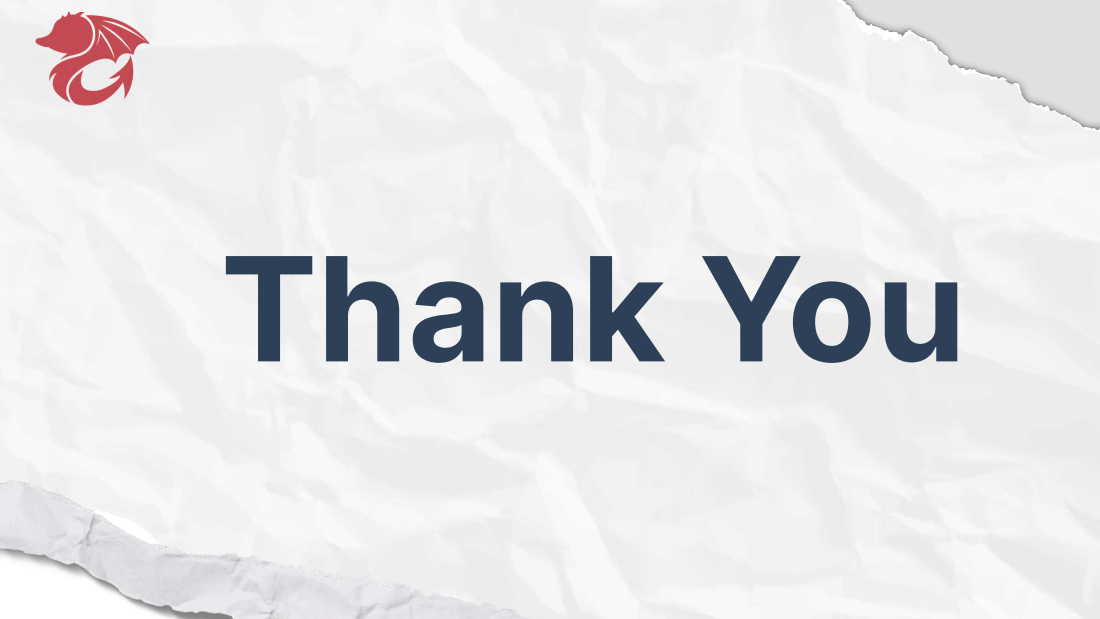
[picture p100: page 27]
Thank You
