DraSoGo/Cansat_Duck2Dragon/(commit log)

2026-05-20 fix bug and add autogyro
    [adxl375.ino, bno055.ino, cansat.ino, deployment.ino, ds3231.ino, gps.ino, ground_station.ino, gyro.ino]
2026-05-23 change to arduino IDE
2026-06-04 add data and change band
    [log_clean.csv]
2026-06-05 fix cansat and add for DTI
    [cansat.ino, cansat_DTI.ino, read_serial_1.py, read_serial_2.py]
2026-06-05 add test vibration in data
    [log_vibration_test1.csv, log_vibration_test2.csv, log_vibration_test3.csv]
2026-06-05 Add ground station monitor design spec
2026-06-05 Add ground station monitor implementation plan
2026-06-05 Add ground station telemetry parser
2026-06-05 Fix monitor event log rows
    [ground_station_monitor.py]
2026-06-05 Fix replay reader stop and pacing
    [ground_station_monitor.py]
2026-06-05 Fix serial reader stop cleanup safety
    [ground_station_monitor.py]
2026-06-05 Fix serial reader connect stop race
    [ground_station_monitor.py]
2026-06-05 Fix monitor UI event lifecycle
    [ground_station_monitor.py]
2026-06-05 Fix monitor stale event handling
    [ground_station_monitor.py]
2026-06-05 Fix merged duplicate replacement
    [ground_station_monitor.py]
2026-06-05 Fix merged replacement edge cases
    [ground_station_monitor.py]
2026-06-05 Fix merged log rewrite on RSSI replacement
    [ground_station_monitor.py]
2026-06-05 Fix full merged log replacement state
    [ground_station_monitor.py]
2026-06-05 Preserve merge buffer bound after trimmed replacements
    [ground_station_monitor.py]
2026-06-05 Add monitor charts and GPS track
2026-06-05 Document ground station monitor usage
2026-06-06 Show GPS track with live coordinates
2026-06-06 Throttle chart redraws during replay
2026-06-06 Stabilize merge tab width on theme toggle
    [ground_station_monitor.py]
2026-06-06 Keep full GPS track on map
2026-06-06 Render GPS track as points
2026-06-06 Show replay progress and skip comment delays
    [ground_station_monitor.py]
2026-06-06 Keep event drain alive after UI errors
    [ground_station_monitor.py]
2026-06-06 Filter impossible GPS map coordinates
2026-06-06 add restart system in ground station
2026-06-06 Add ground station monitor improvements design spec\n\n- Bug fixes: GPS validation, drag sensitivity, input validation\n- New features: CSV export, packet loss metrics, auto-apogee, configurable aler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
2026-06-06 feat: add AlertConfig serialization methods\n\nAdd to_dict() and from_dict() methods to AlertConfig dataclass\nfor configuration persistence and serialization.\n\n- to_dict(): converts config to dict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
2026-06-06 fix: reduce orientation drag sensitivity from 0.6 to 0.3
    [ground_station_monitor.py]
2026-06-06 feat: integrate auto-apogee detection\n\n- Initialize ApogeeDetector and AlertConfig in __init__\n- Call apogee_detector.update() in _update_merge_view\n- Record apogee event when detected\n- Reset a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
    [ground_station_monitor.py]
2026-06-06 fix: move calculate_packet_loss to module level and fix import path\n\n- Changed 'from Data.telemetry_core' to 'from telemetry_core'\n- Unindented calculate_packet_loss from class method to module fu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
    [ground_station_monitor.py]
2026-06-06 fix: move alert config methods into class body\n\nMoved _show_alert_settings, _save_alert_config, _load_alert_config from after calculate_packet_loss (line 1462, module level) to before it (inside Gr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
    [ground_station_monitor.py]
2026-06-08 fix: remove deployment bugs and dead code\n\n- Removed unused 'time' variable and broken time-based failsafe (lines 30, 132-136)\n- Changed deployParachute() to use SERVO_DEPLOY_ANGLE constant instea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
    [deployment.ino]
2026-06-09 docs: add landing prediction simulation design spec\n\n- RocketPy-based 6-DOF trajectory simulation\n- Monte Carlo with wind/deployment/drag uncertainty\n- 2D/3D visualization with interactive widget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
2026-06-09 feat: add landing prediction simulation notebook\n\n- RocketPy 6-DOF Monte Carlo simulation for rocket/CanSat landing predictions\n- OpenRocket .ork file parser for motor thrust curve and rocket spec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
2026-06-09 fix: reorder notebook cells to correct execution sequence\n\nCells were inserted in reverse order by NotebookEdit tool.\nCorrected sequence: title â imports â config â physics â parser â en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
2026-06-09 fix: update RocketPy API calls for v1.12.1\n\n- SolidMotor: center_of_dry_mass â center_of_dry_mass_position\n- Rocket: remove motor param, use add_motor() method instead\n- Adds motor at position 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
2026-06-09 feat: show landing distance from launch instead of GPS coords\n\n- Map centers on launch site (not mean landing)\n- Added 300m blue reference circle around launch\n- Landing markers show distance fro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
2026-06-14 end of cansat
    [2026-06-12_14-33-14_events.csv, 2026-06-12_14-33-14_merged.csv, final_log.csv, final_log_high_temp.csv, final_log_processed.csv, final_log_processed_2.csv, final_log_processed_3.csv, gps_log.csv]
